robouden/note-hardware/Notecarrier-R/README.md

# Notecarrier R

  - Schematics
  - Bills of material
  - PCB layouts and Gerber files
  - Dimensioned drawings
  - 3D models
