robouden/note-hardware/Notecarrier-A/v2.0/KiCad_format/documentation/B-Cu_phantom_curve_overlay.png

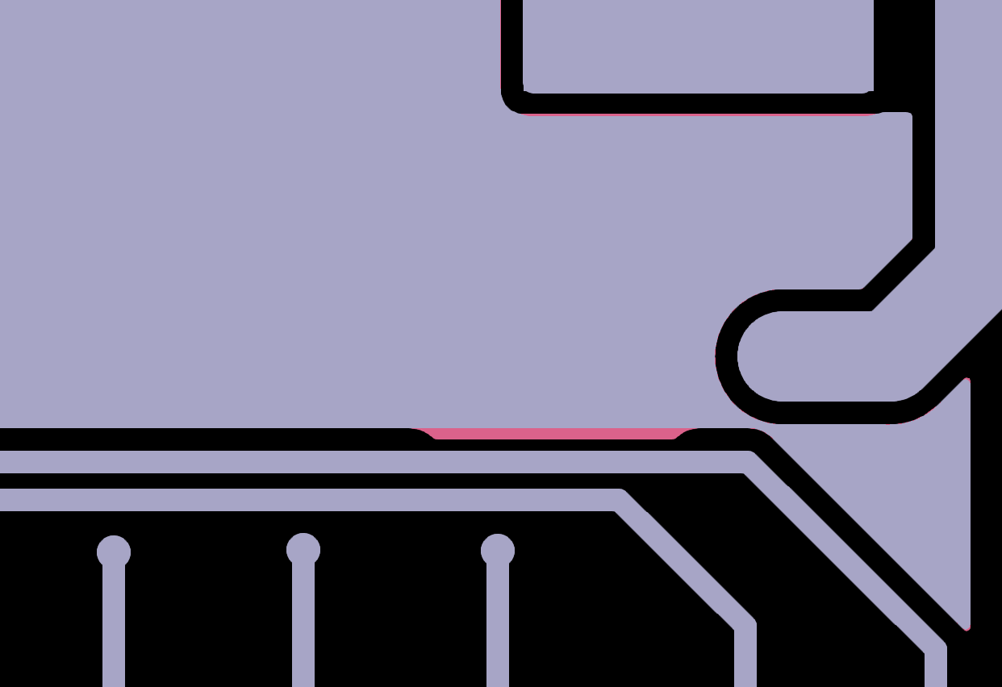
Notecarrier-A/v2.0/KiCad_format/documentation/B-Cu_phantom_curve_overlay.png
