robouden/note-hardware/Notecarrier-A/v2.0/KiCad_format/documentation/multiple_zone_clearance_settings.png

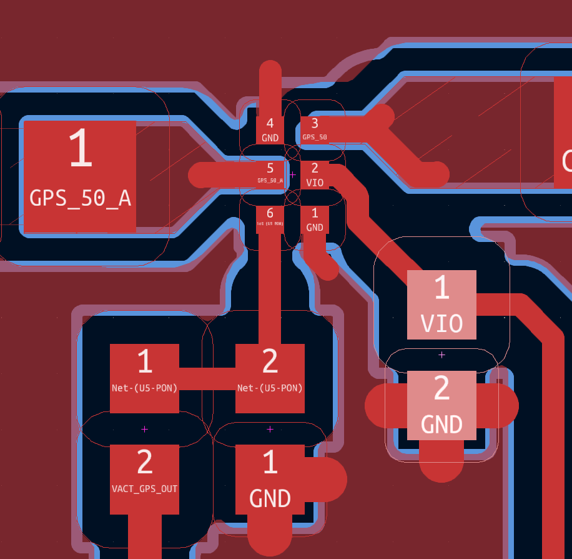
Notecarrier-A/v2.0/KiCad_format/documentation/multiple_zone_clearance_settings.png
