robouden/note-hardware/Notecarrier-A/v2.0/KiCad_format/documentation/no_phantom_curve.png

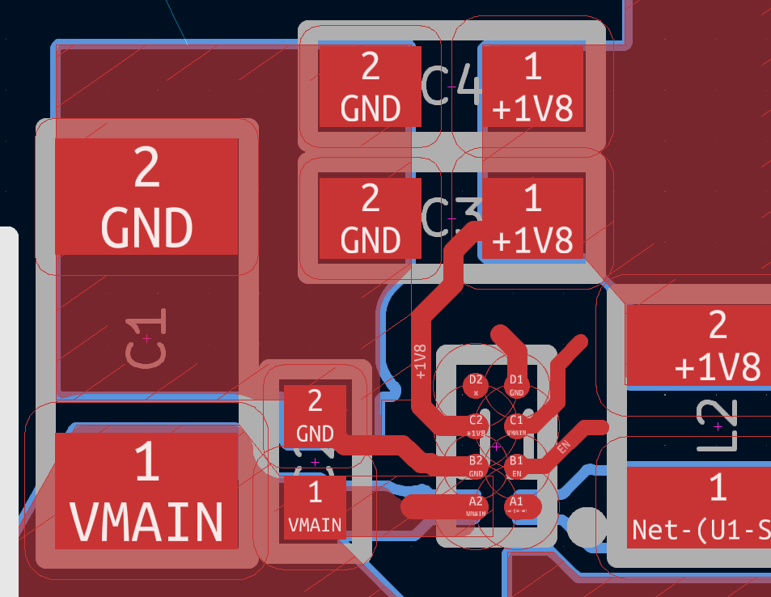
Notecarrier-A/v2.0/KiCad_format/documentation/no_phantom_curve.png
