robouden/note-hardware/Notecarrier-A/v2.0/KiCad_format/documentation/phantom_curve.png

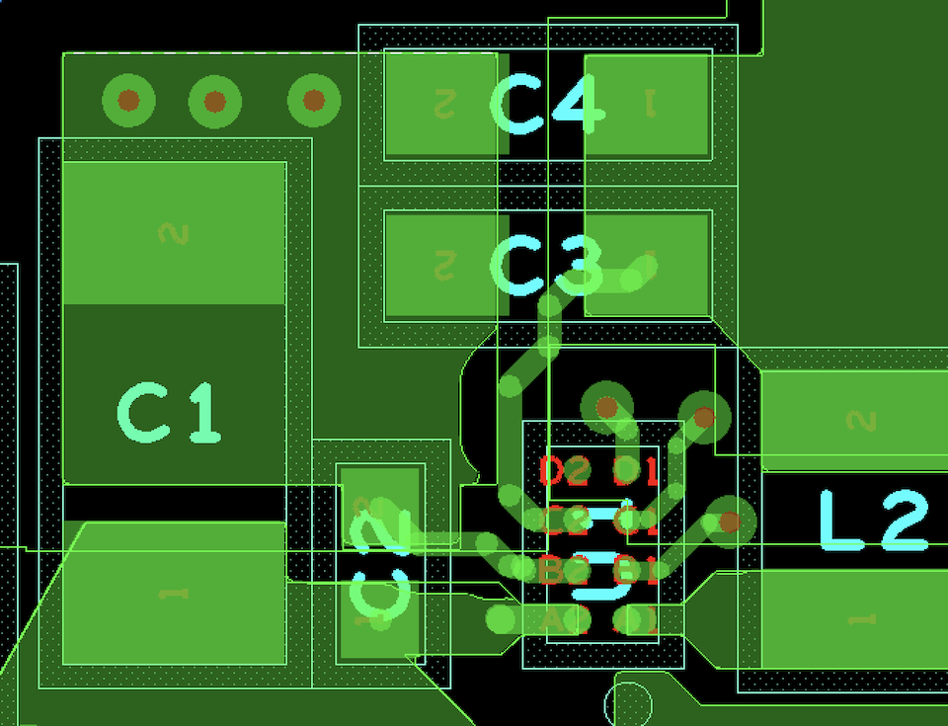
Notecarrier-A/v2.0/KiCad_format/documentation/phantom_curve.png
