robouden/note-hardware/Notecarrier-Mirco/Notecarrier-Micro/Reference/Coilcraft-XFL4020.STEP

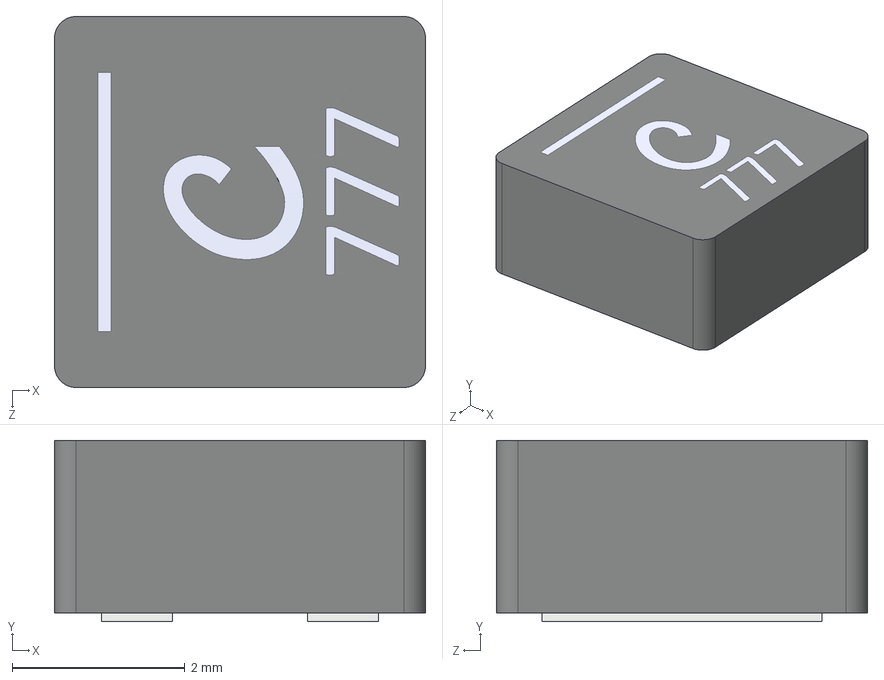
[picture p8: CAD file, 2024-05-01]
Notecarrier-Mirco/Notecarrier-Micro/Reference/Coilcraft-XFL4020.STEP
4.30 x 2.10 x 4.30 mm
