robouden/note-hardware/(list of files, cad)

Other CAD files:
Notecarrier-Mirco/Notecarrier-Micro/Notecarrier- Mirco.FCStd
Notecarrier-B/v3.1/PCB + 3D + 2D/2D/20173047_NOTECARRIER-M2-BH_V14_DIMENSION.dxf
Notecarrier-B/v1.6/Notecarrier-B drawing v1.6.dxf
Notecarrier-Mirco/Notecarrier-Micro/Reference/Coilcraft-XFL4020.stl
