robouden/note-hardware/Notecarrier-A/v2.0/KiCad_format/validation/In1_Cu-diff.png

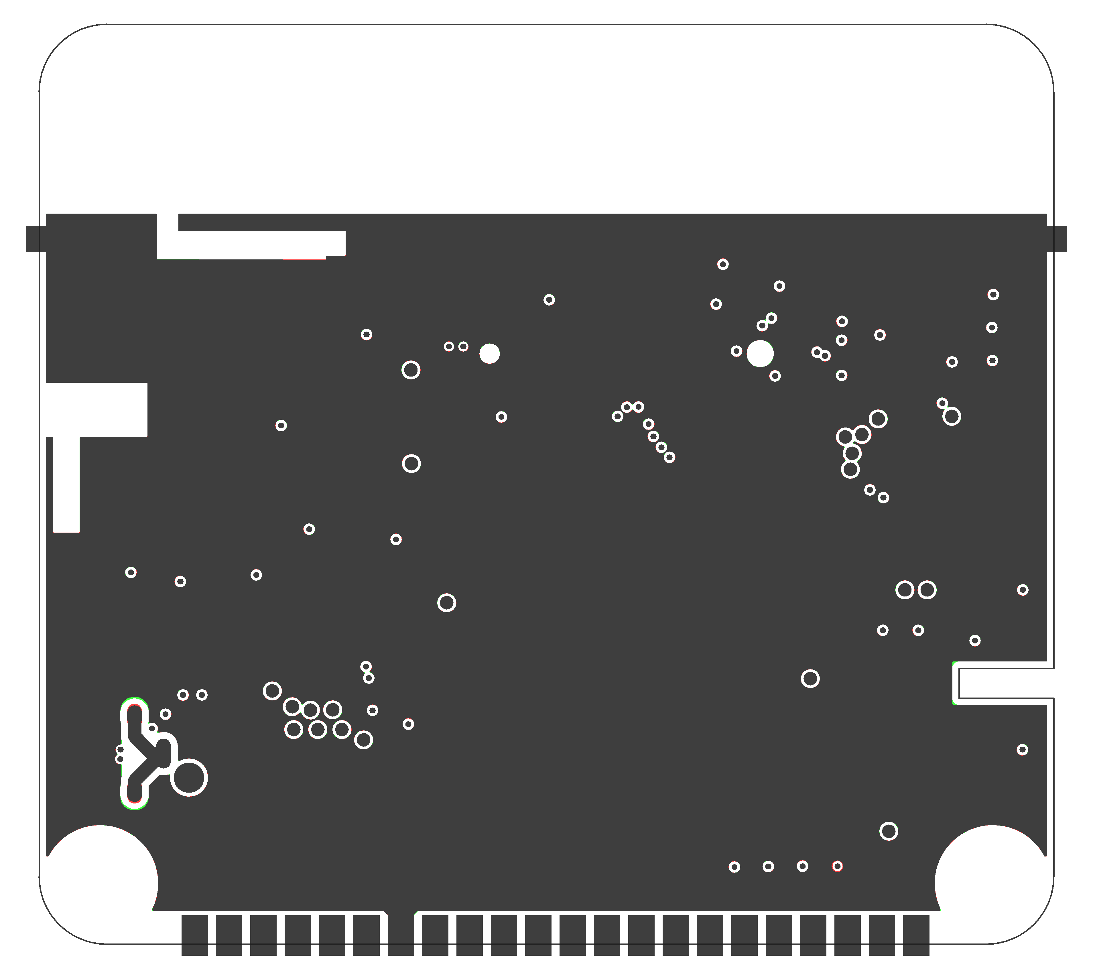
Notecarrier-A/v2.0/KiCad_format/validation/In1_Cu-diff.png
