robouden/note-hardware/Notecarrier-Mirco/Notecarrier-Micro/validation/B_Cu-diff.png

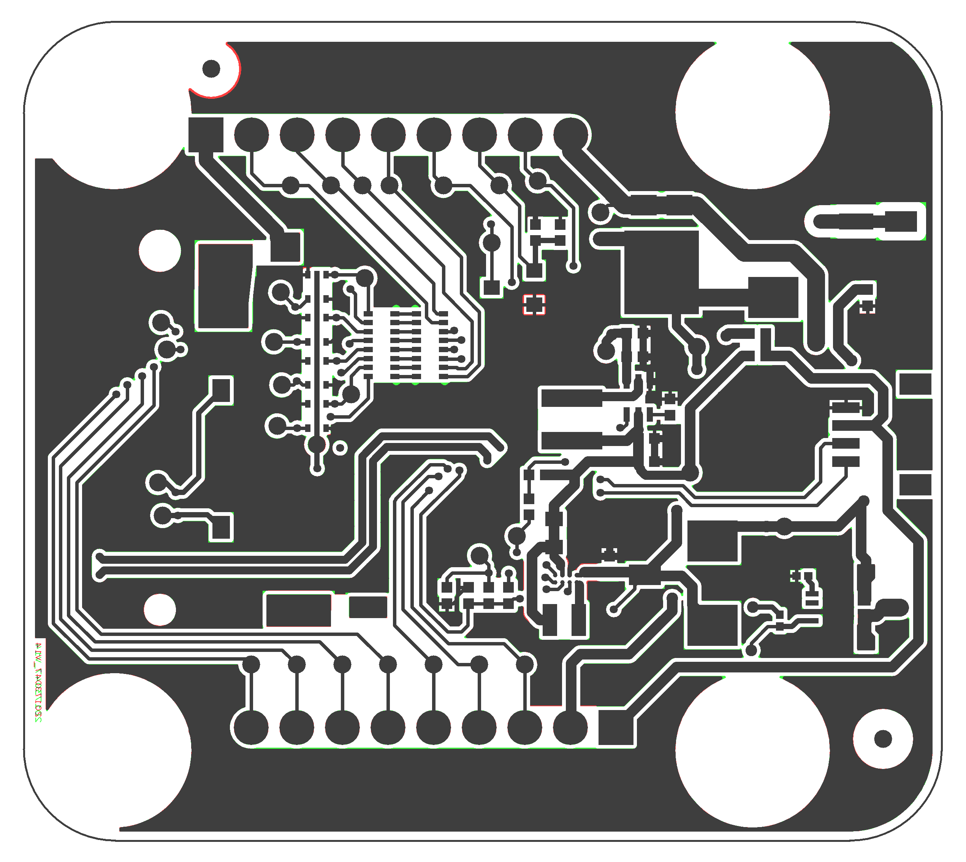
Notecarrier-Mirco/Notecarrier-Micro/validation/B_Cu-diff.png
