robouden/note-hardware/Notecarrier-Mirco/Notecarrier-Micro/validation/B_Mask-diff.png

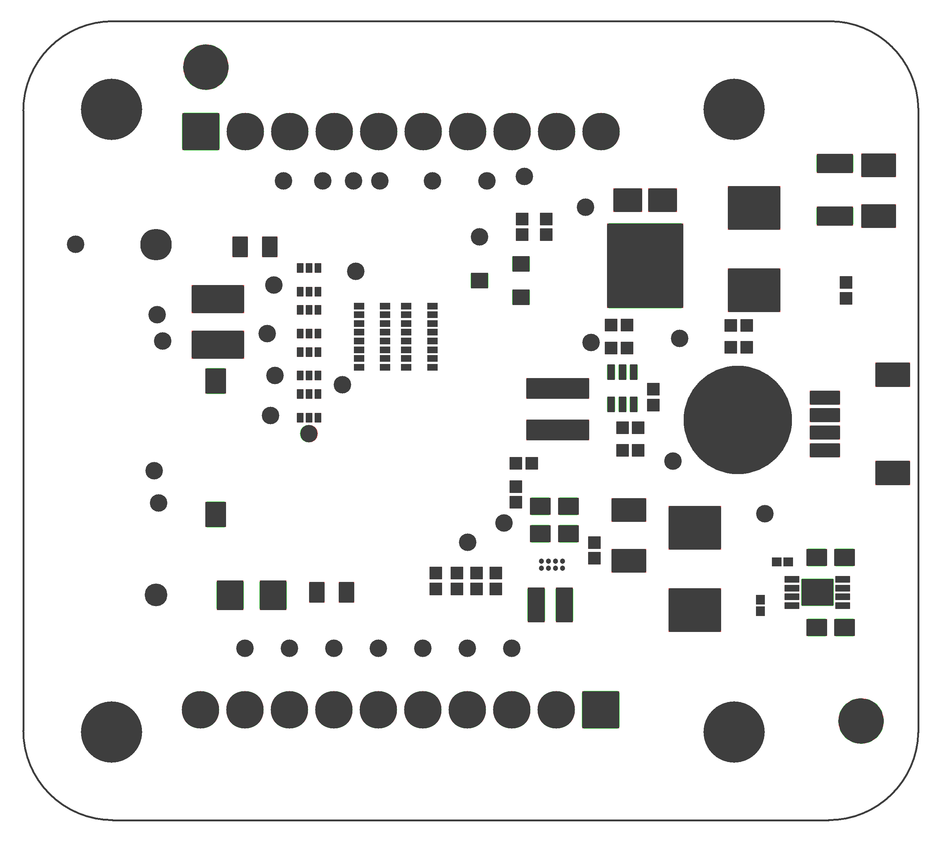
Notecarrier-Mirco/Notecarrier-Micro/validation/B_Mask-diff.png
