robouden/note-hardware/Notecarrier-Mirco/Notecarrier-Micro/validation/B_Paste-diff.png

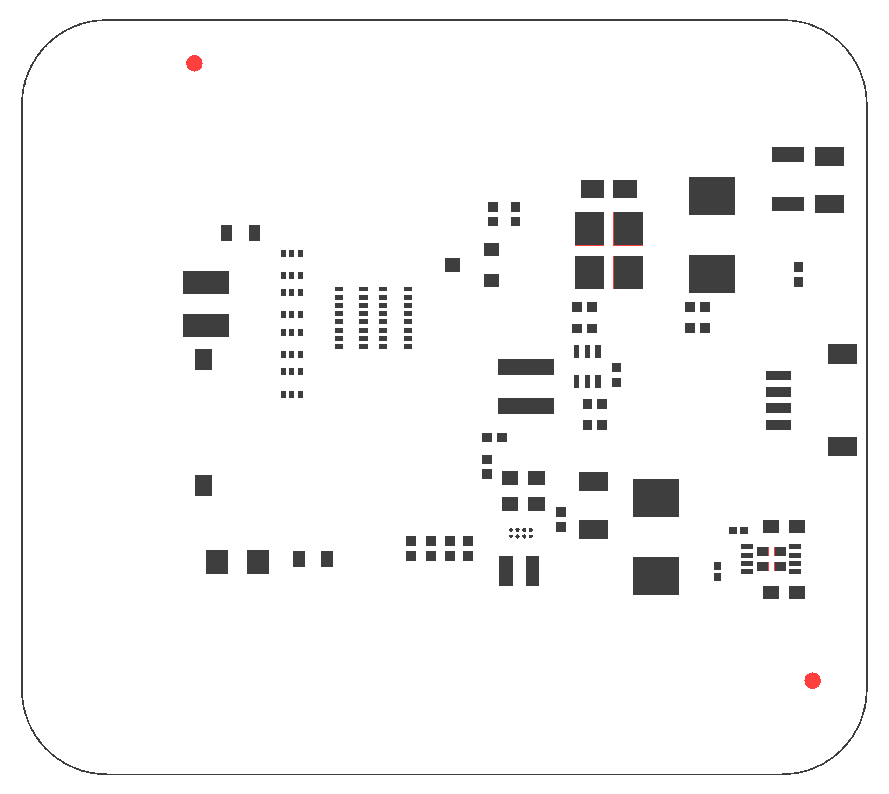
Notecarrier-Mirco/Notecarrier-Micro/validation/B_Paste-diff.png
