robouden/note-hardware/Notecarrier-Mirco/Notecarrier-Micro/validation/B_Silkscreen-diff.png

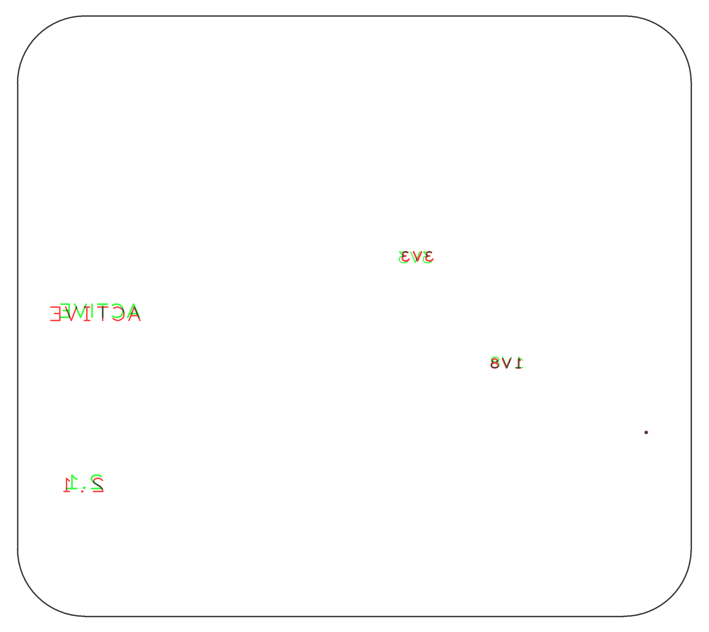
Notecarrier-Mirco/Notecarrier-Micro/validation/B_Silkscreen-diff.png
