robouden/note-hardware/Notecarrier-Mirco/Notecarrier-Micro/validation/Edge_Cuts-diff.png

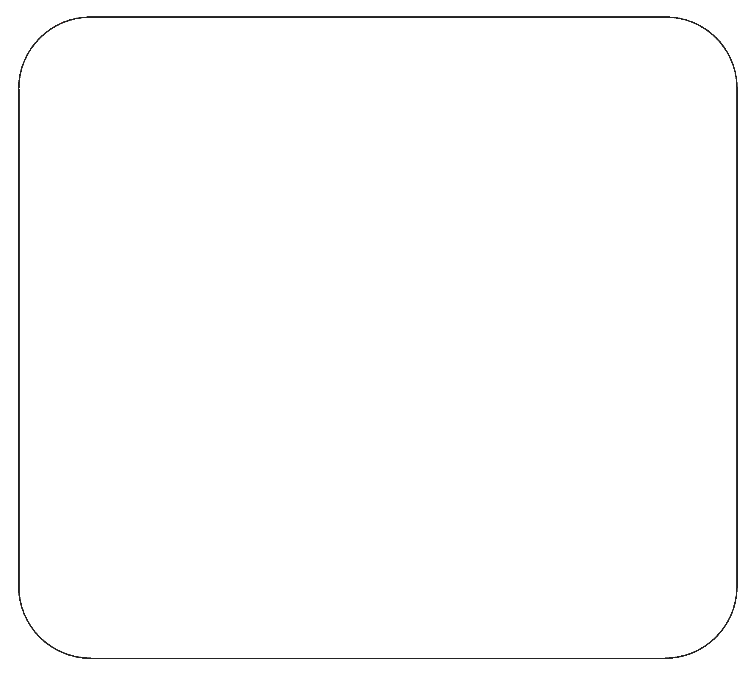
Notecarrier-Mirco/Notecarrier-Micro/validation/Edge_Cuts-diff.png
