robouden/note-hardware/Notecarrier-Mirco/Notecarrier-Micro/validation/F_Cu-diff.png

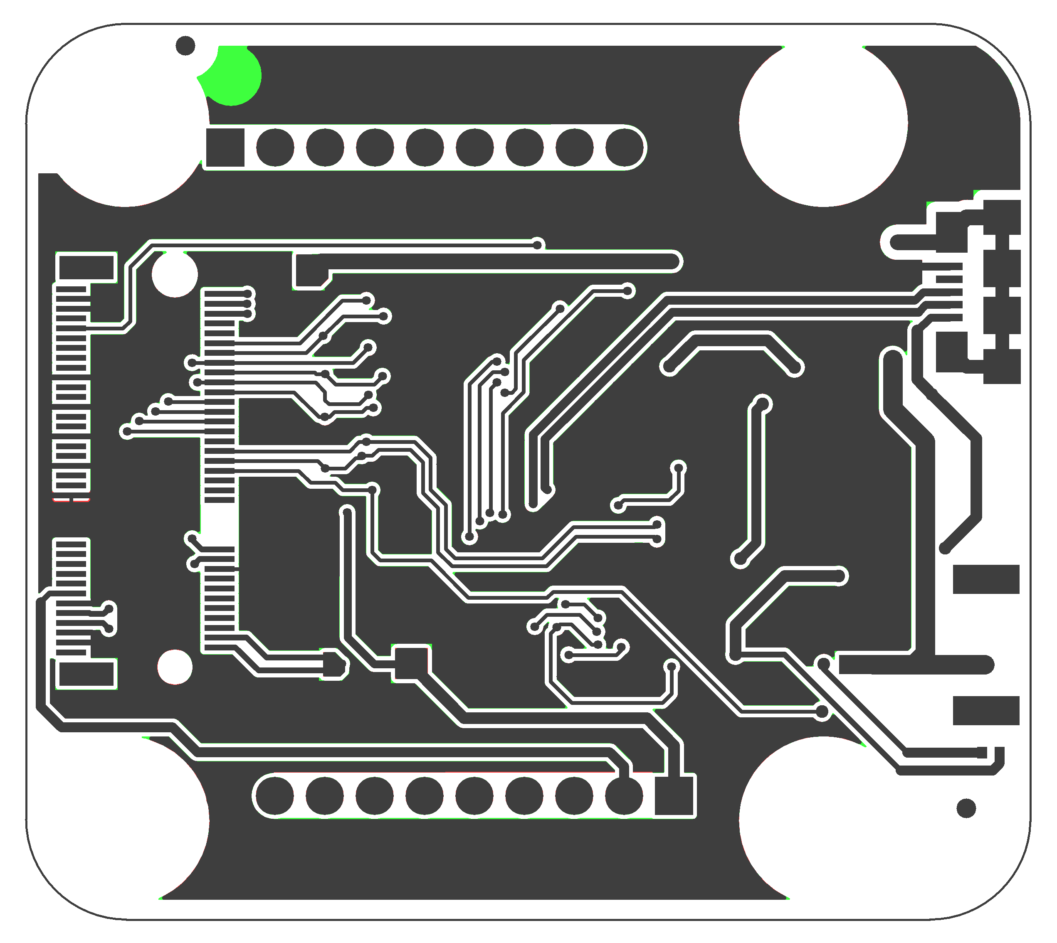
Notecarrier-Mirco/Notecarrier-Micro/validation/F_Cu-diff.png
