robouden/note-hardware/Notecarrier-Mirco/Notecarrier-Micro/validation/F_Mask-diff.png

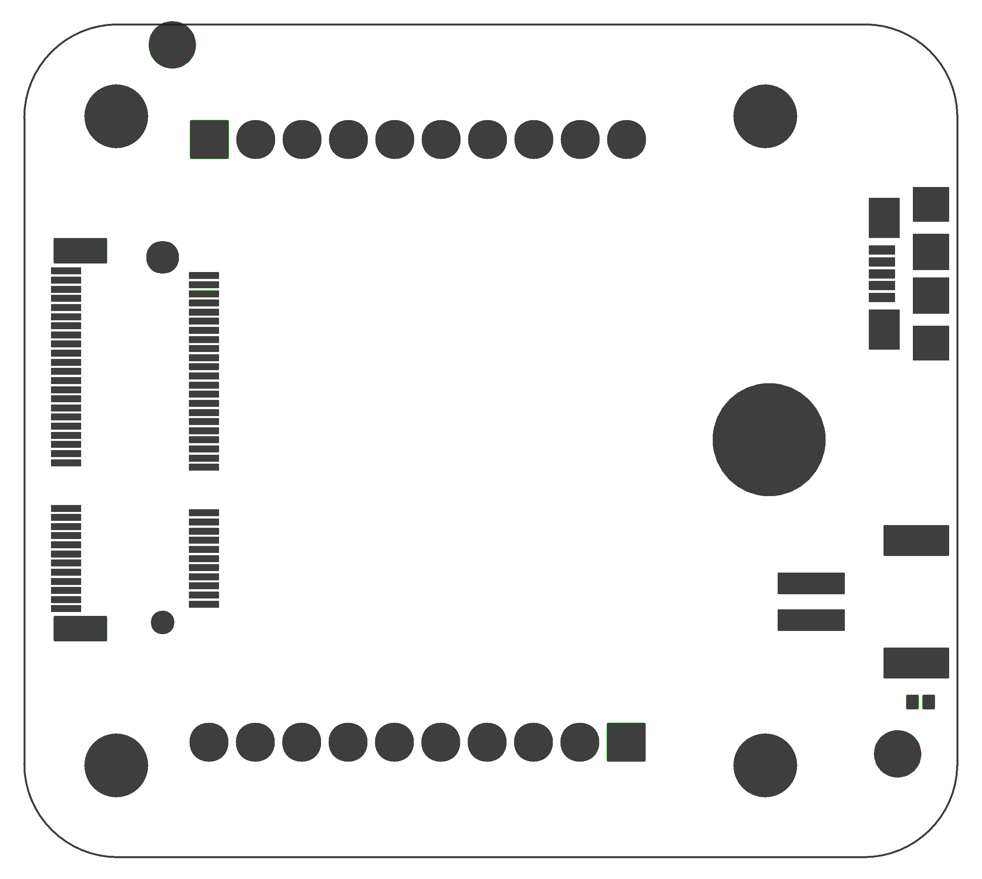
Notecarrier-Mirco/Notecarrier-Micro/validation/F_Mask-diff.png
