robouden/note-hardware/Notecarrier-Mirco/Notecarrier-Micro/validation/F_Paste-diff.png

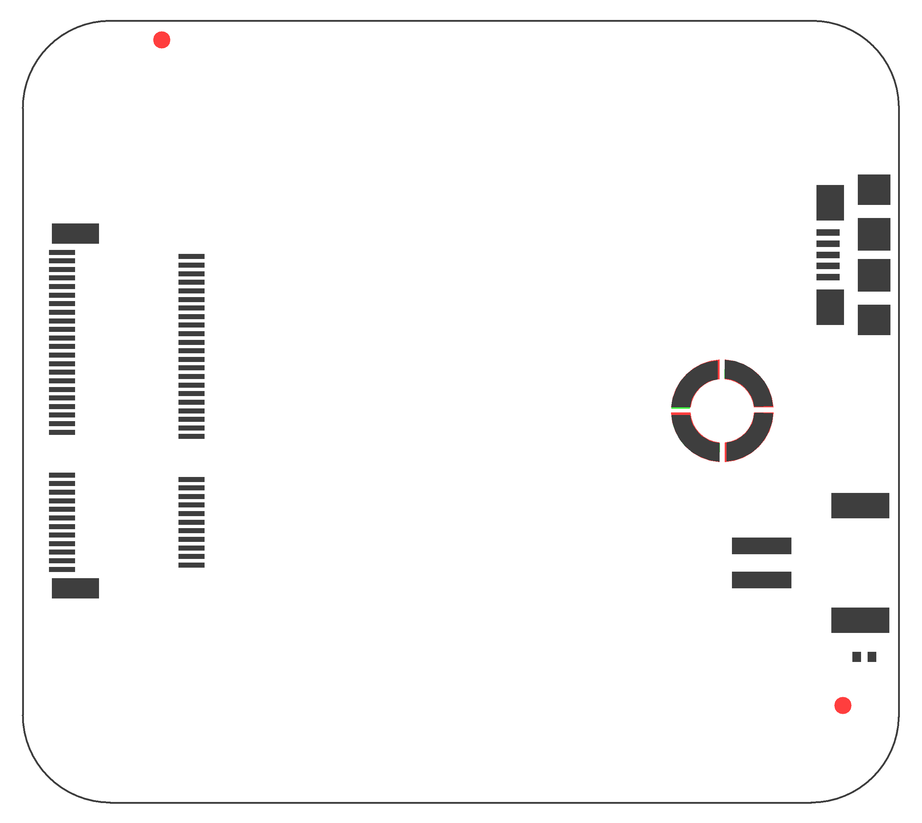
Notecarrier-Mirco/Notecarrier-Micro/validation/F_Paste-diff.png
