robouden/note-hardware/Notecarrier-Mirco/Notecarrier-Micro/validation/F_Silkscreen-diff.png

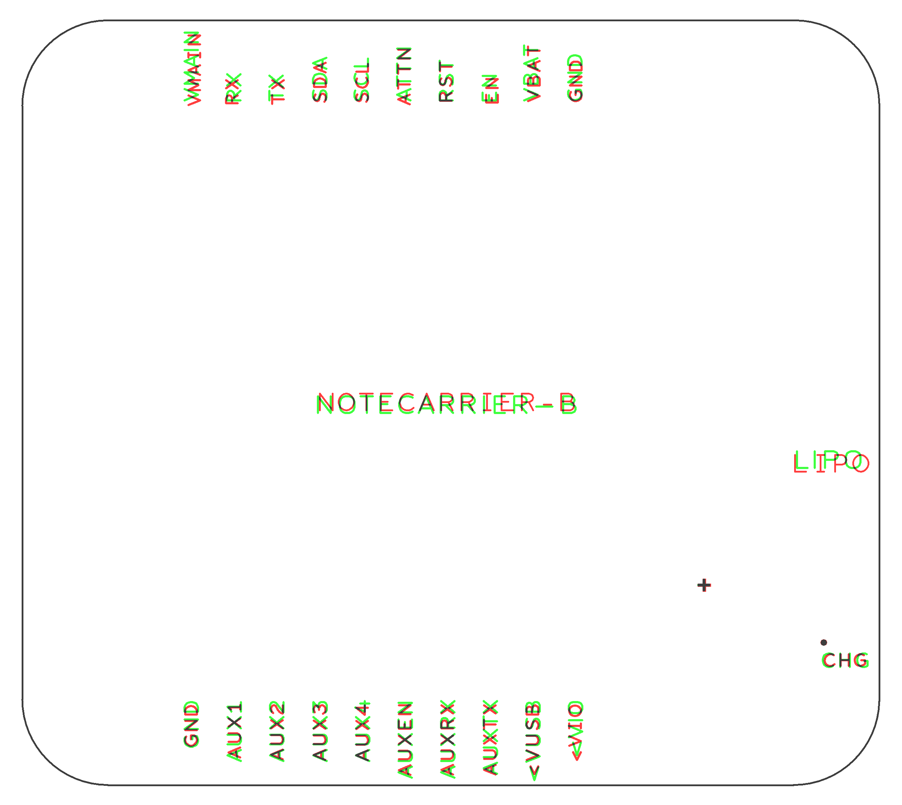
Notecarrier-Mirco/Notecarrier-Micro/validation/F_Silkscreen-diff.png
