robouden/note-hardware/Notecarrier-Mirco/Notecarrier-Micro/validation/F_Silkscreen-KiCad.png

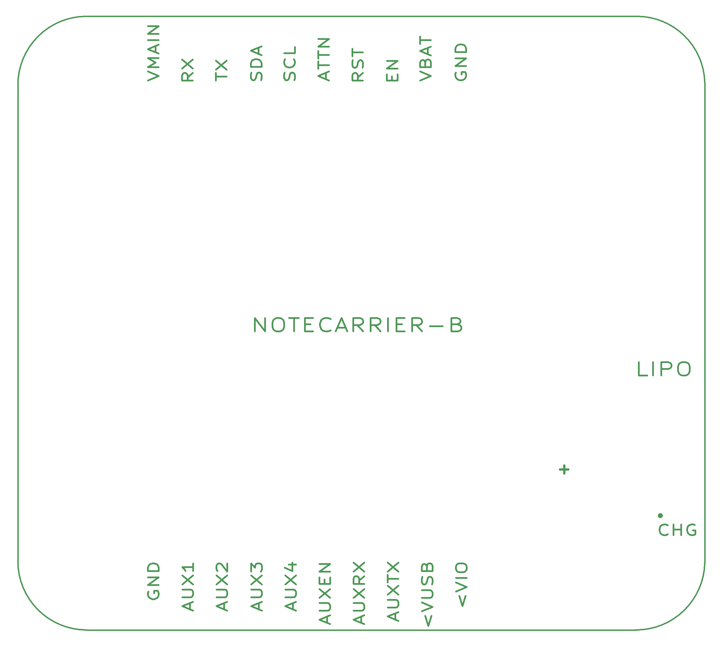
Notecarrier-Mirco/Notecarrier-Micro/validation/F_Silkscreen-KiCad.png
