robouden/note-hardware/Notecarrier-Mirco/Notecarrier-Micro/validation/NPTH-diff.png

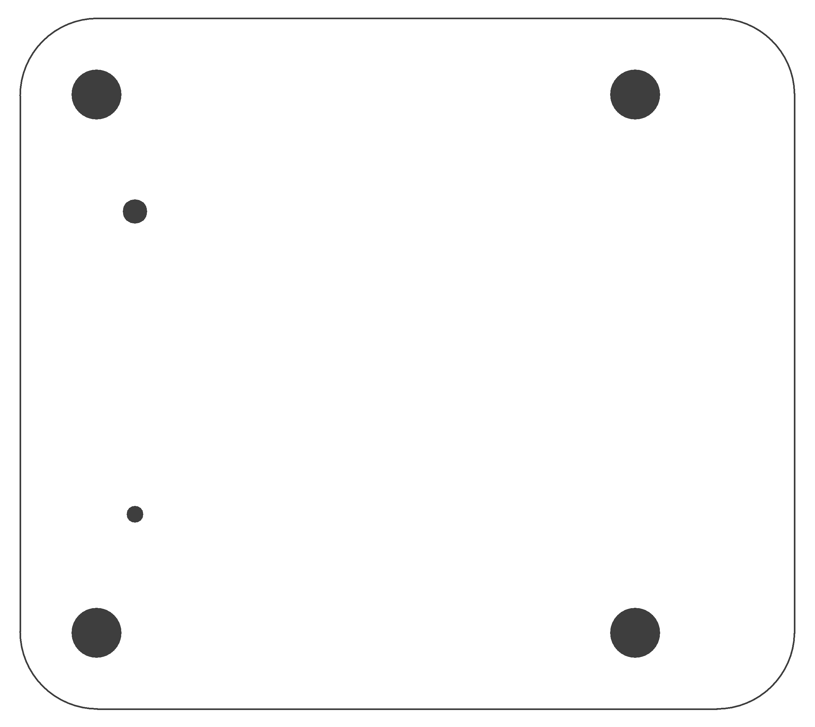
Notecarrier-Mirco/Notecarrier-Micro/validation/NPTH-diff.png
