robouden/note-hardware/Notecarrier-Mirco/Notecarrier-Micro/validation/orig/B_Paste-KiCad_top.png

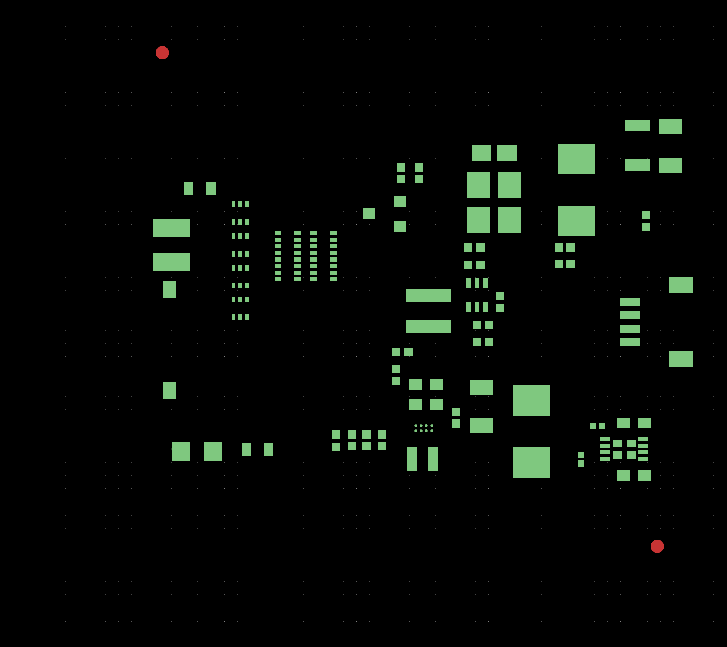
Notecarrier-Mirco/Notecarrier-Micro/validation/orig/B_Paste-KiCad_top.png
