robouden/note-hardware/Notecarrier-Mirco/Notecarrier-Micro/validation/orig/Drill_NPTH-KiCad_top.png

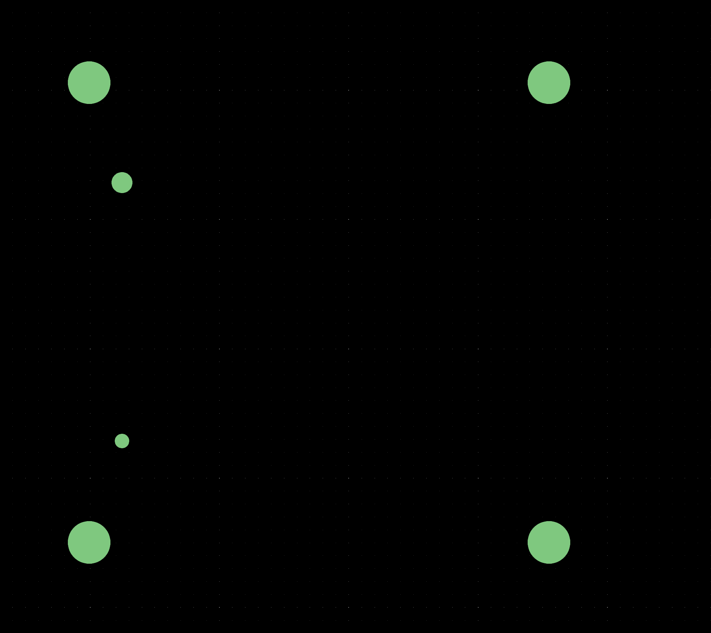
Notecarrier-Mirco/Notecarrier-Micro/validation/orig/Drill_NPTH-KiCad_top.png
