robouden/note-hardware/Notecarrier-Mirco/Notecarrier-Micro/validation/orig/Drill_PTH-OrCAD_top.png

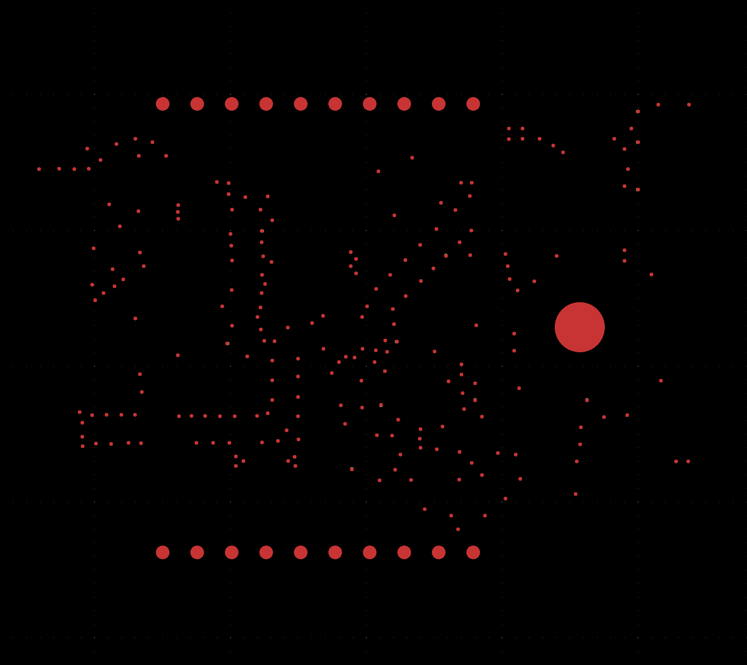
Notecarrier-Mirco/Notecarrier-Micro/validation/orig/Drill_PTH-OrCAD_top.png
