robouden/note-hardware/Notecarrier-Mirco/Notecarrier-Micro/validation/orig/Edge_Cuts-KiCad_top.png

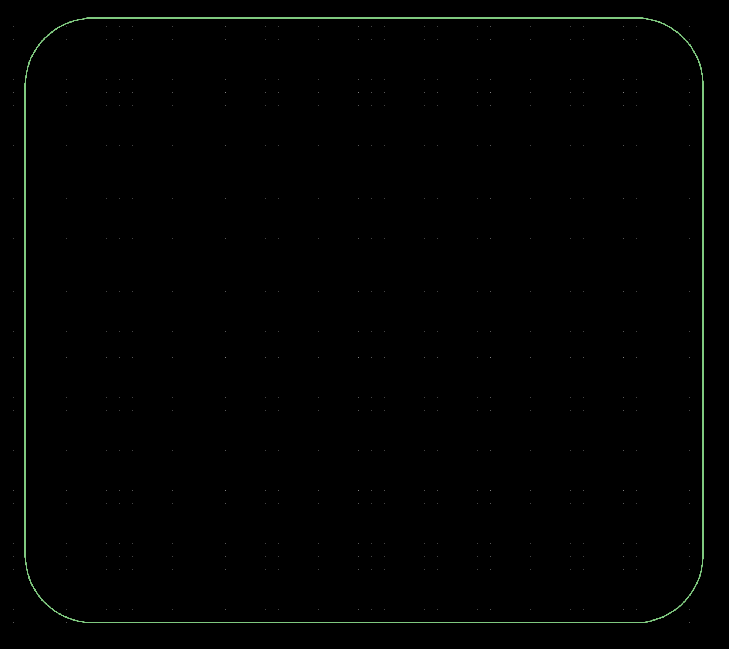
Notecarrier-Mirco/Notecarrier-Micro/validation/orig/Edge_Cuts-KiCad_top.png
