robouden/note-hardware/Notecarrier-Mirco/Notecarrier-Micro/validation/orig/F_Cu-KiCad_top.png

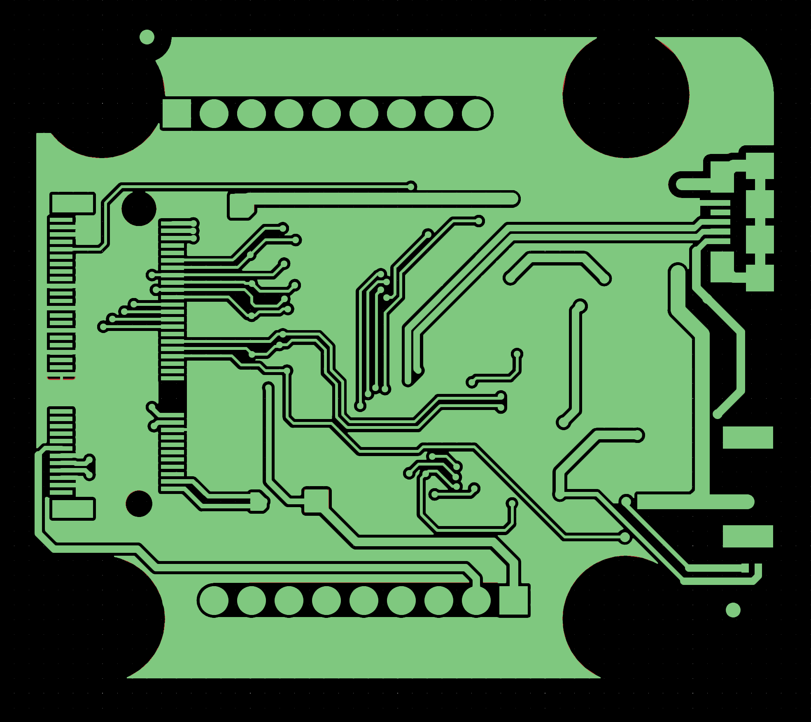
Notecarrier-Mirco/Notecarrier-Micro/validation/orig/F_Cu-KiCad_top.png
