robouden/note-hardware/Notecarrier-Mirco/Notecarrier-Micro/validation/orig/F_Mask-KiCad_top.png

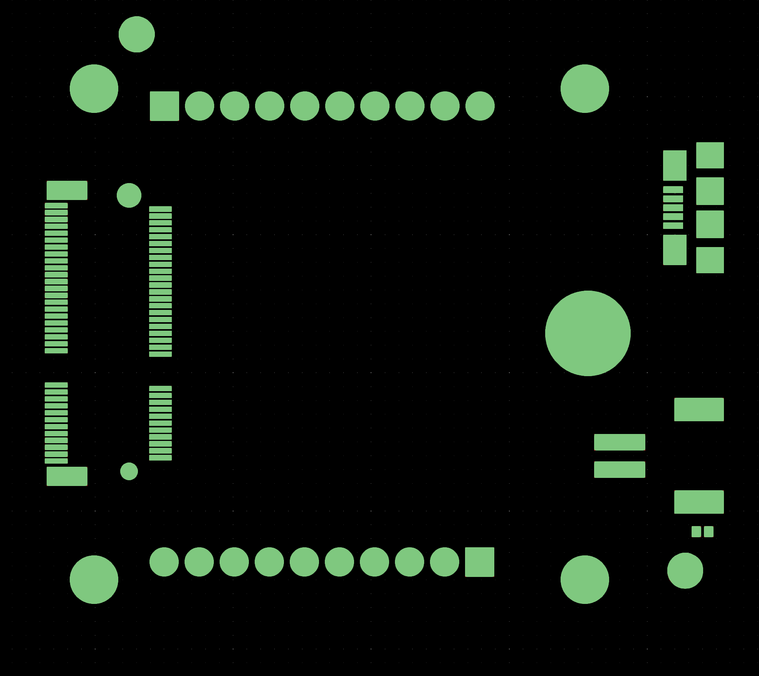
Notecarrier-Mirco/Notecarrier-Micro/validation/orig/F_Mask-KiCad_top.png
