robouden/note-hardware/Notecarrier-Mirco/Notecarrier-Micro/validation/PTH-diff.png

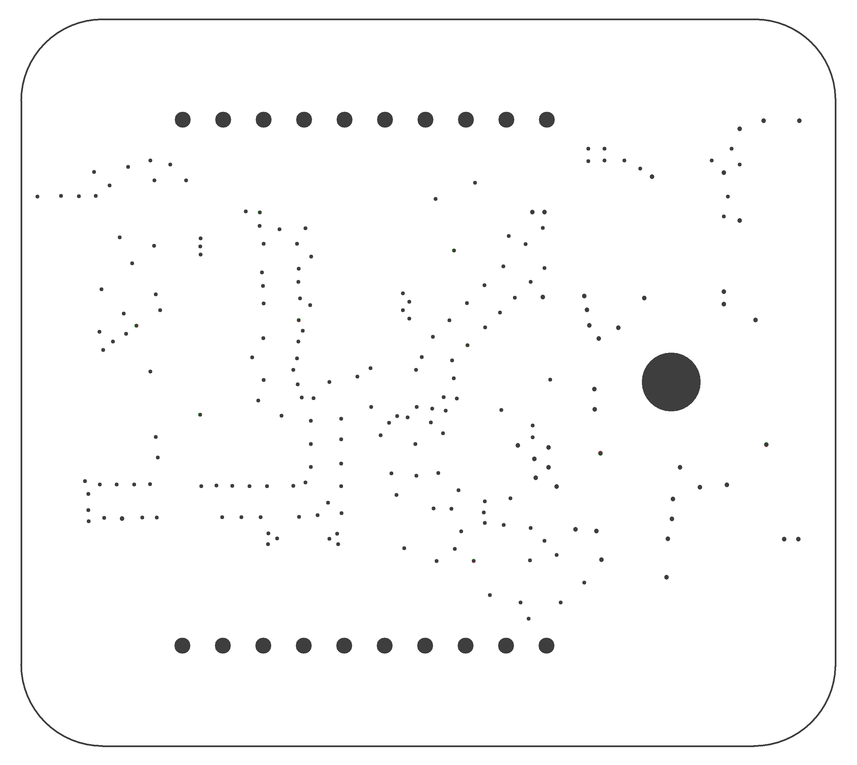
Notecarrier-Mirco/Notecarrier-Micro/validation/PTH-diff.png
