robouden/note-hardware/Notecarrier-Mirco/Notecarrier-Micro/validation/PTH-OrCAD.png

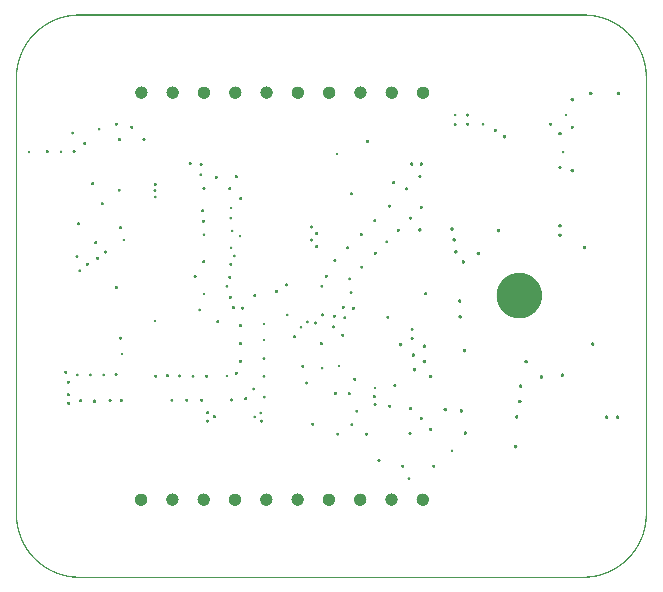
Notecarrier-Mirco/Notecarrier-Micro/validation/PTH-OrCAD.png
