robouden/note-hardware/Notecarrier-A/v2.0/Notecarrier-A schematic v2.0.pdf

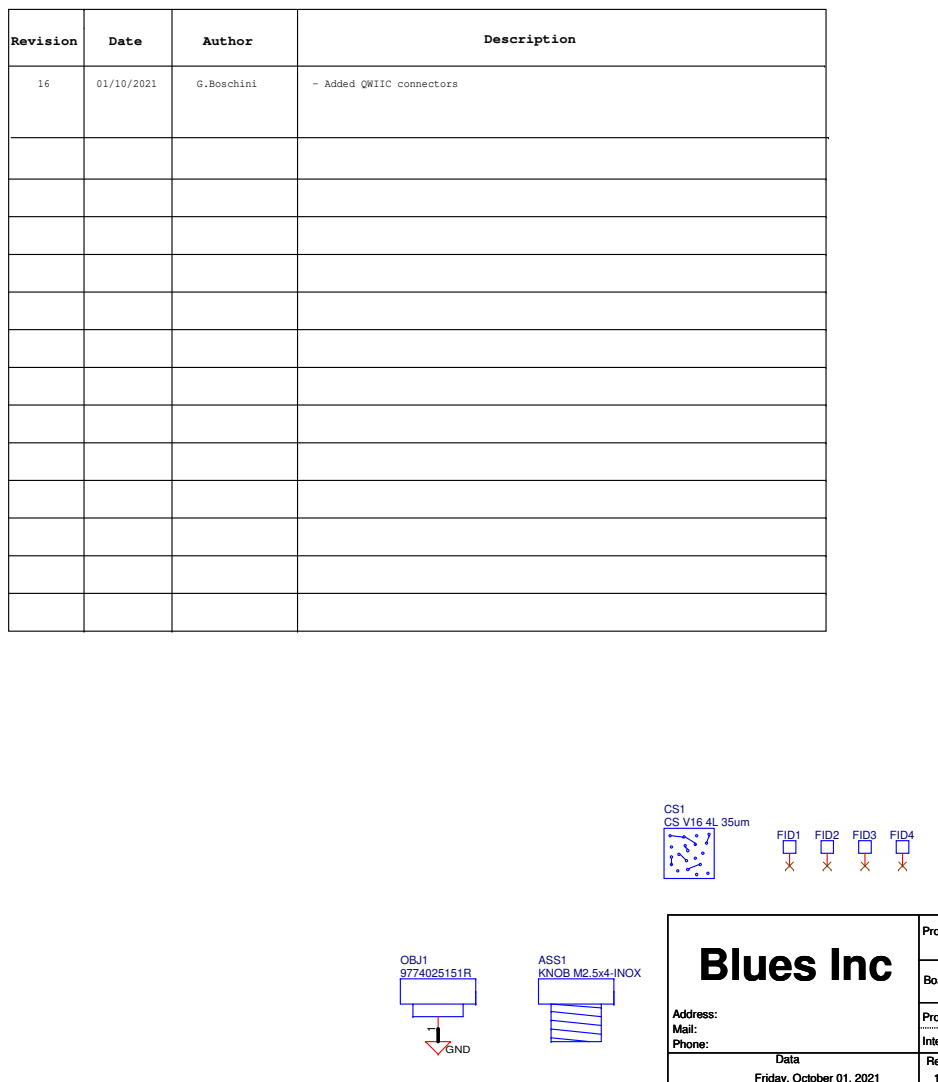
[picture p36: page 1]
Revision; Date; Author; Description; G.Boschini; - Added QWIIC connectors; GND; Project Code; Rev.; Rev. changes; Sheet; Board; Project; Code; Page name; Data; Designed by; Internal Code; Friday, October 01, 2021; 00 - REVISION; NOTECARRIER AL; NOTEBOX; See Revision Page; Address:; Mail: Phone:; Blues Inc; FID3; ASS1 KNOB M2.5x4-INOX; OBJ1 9774025151R; FID1; FID2; FID4

via C. Battisti, 136
24025 Gazzaniga (Bg), Italy
Mail: info@fae.technology
Phone: +39035738130

Copyright (c) 2020 Blues Inc

# I2C GROVE

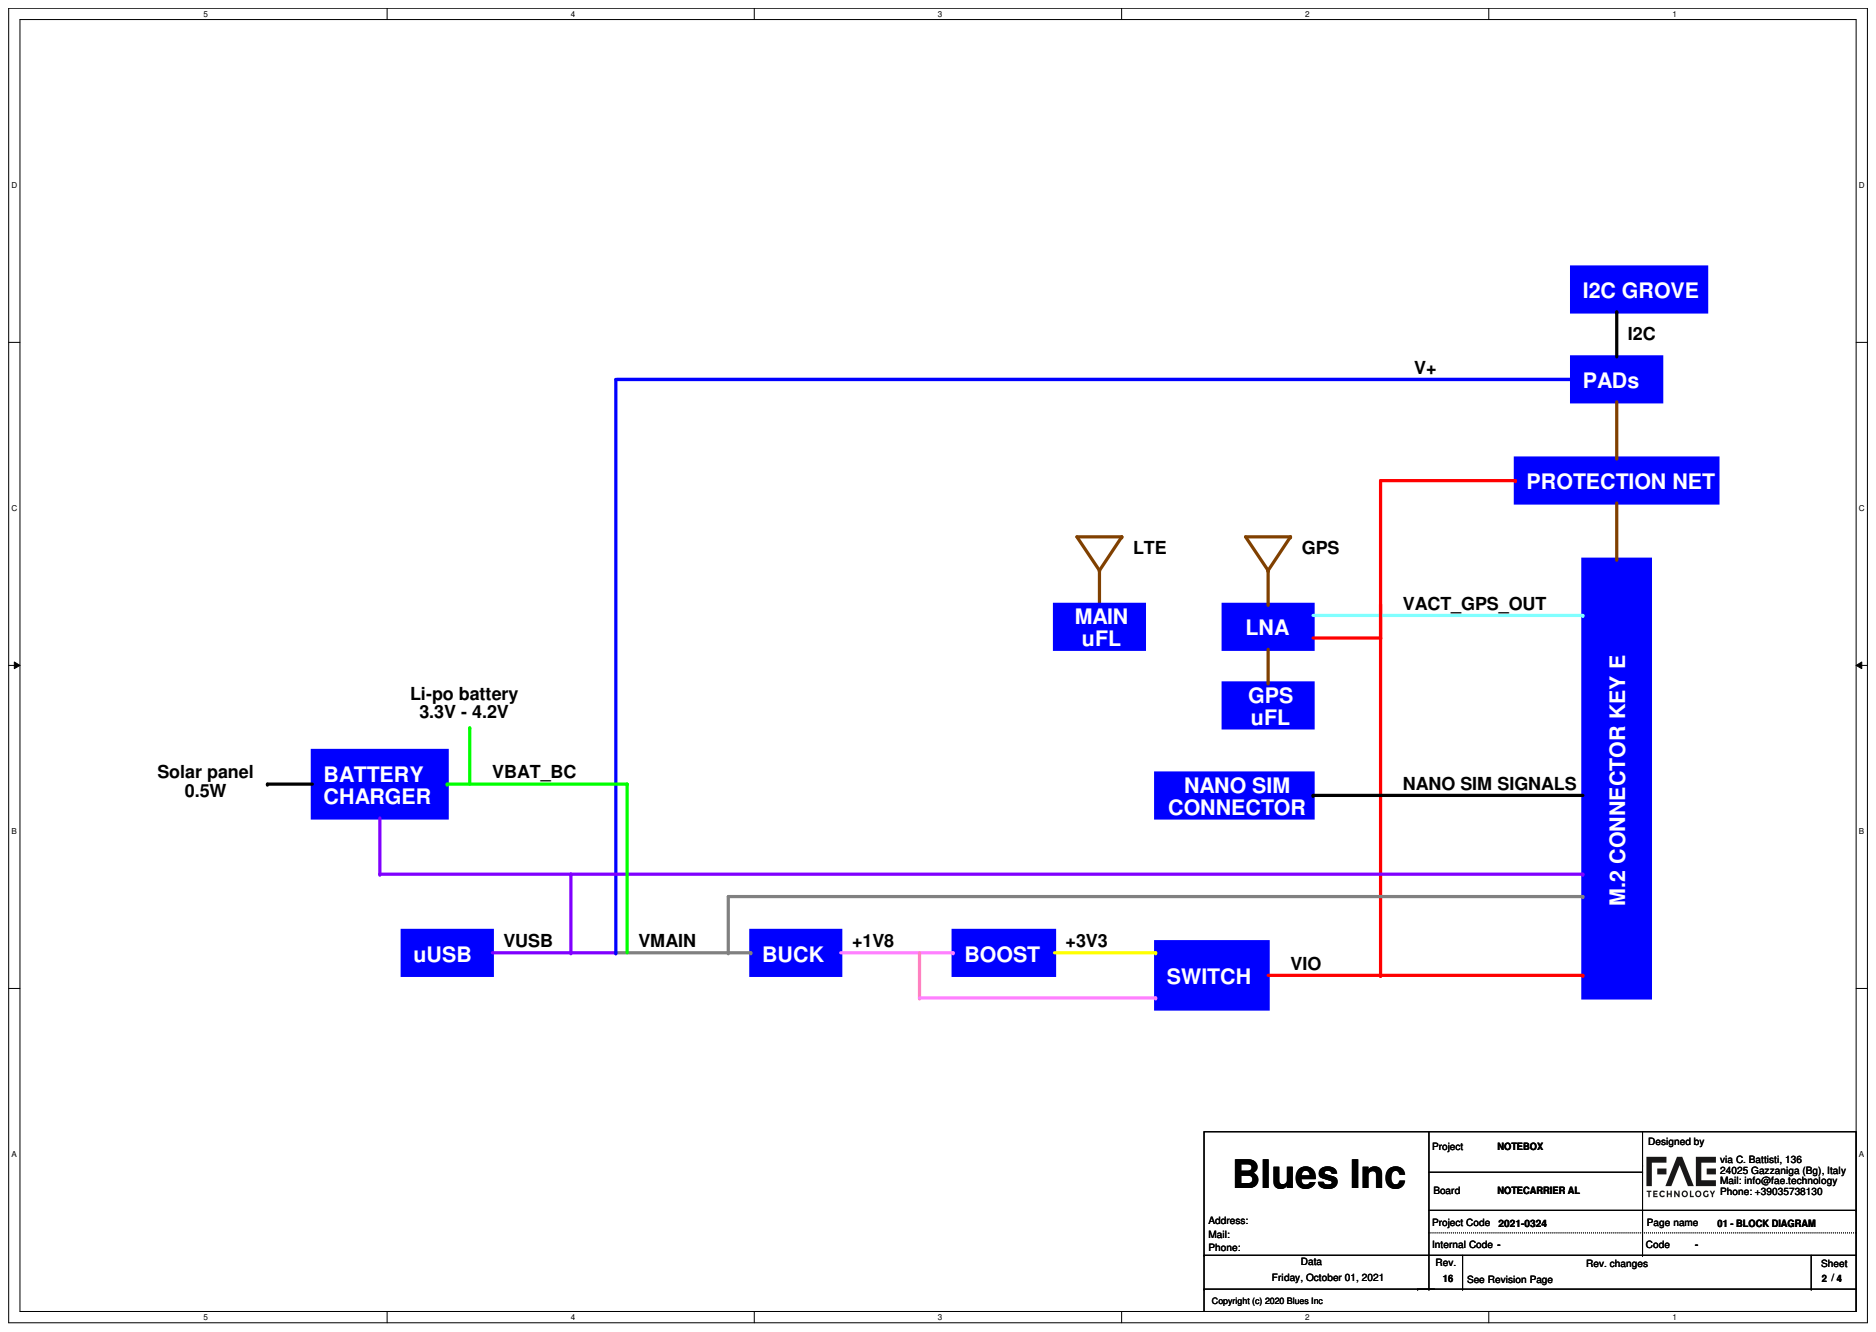
[picture p37: page 2]
BUCK VUSB; VIO SWITCH VMAIN uUSB; BOOST ⁺¹V8; VACT_GPS_OUT; LNA; LTE; GPS; M.2 CONNECTOR KEY E; PROTECTION NET; PADs; GPS uFL; MAIN uFL; NANO SIM CONNECTOR; NANO SIM SIGNALS BATTERY CHARGER Solar panel 0.5W; VBAT_BC; Project Code; Rev.; Rev. changes; Sheet; Board; Project; Code; Page name; Data; Designed by; Internal Code; 01 - BLOCK DIAGRAM; NOTECARRIER AL; NOTEBOX; See Revision Page; Address:; Mail: Phone:; Blues Inc

Li-po battery

via C. Battisti, 136
24025 Gazzaniga (Bg), Italy
Mail: info@fae.technology
Phone: +39035738130

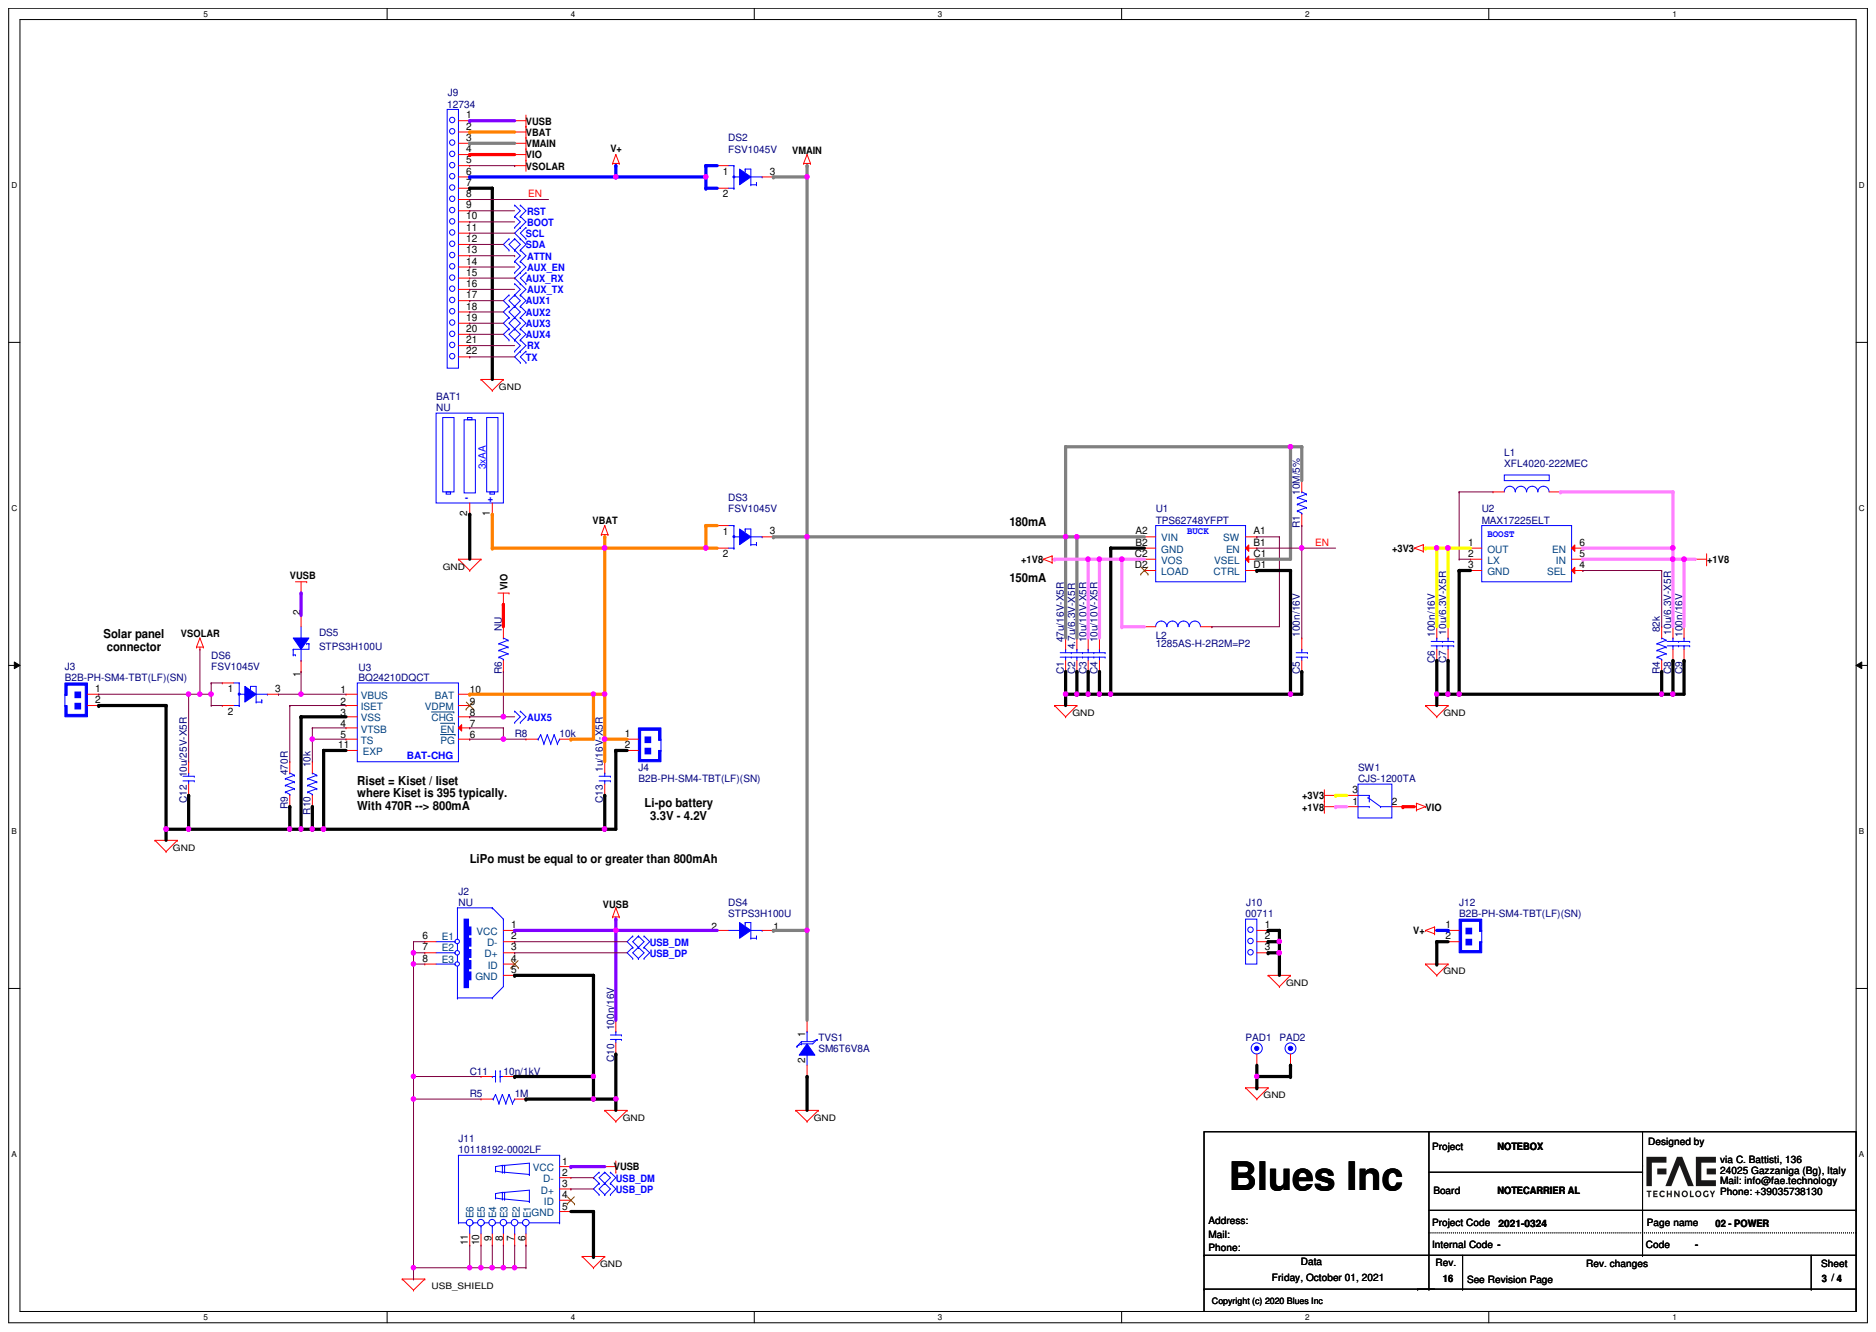
[picture p38: page 3]

B2B-PH-SM4-TBT(LF)(SN)

Riset = Kiset / Iiset
where Kiset is 395 typically.
With 470R --> 800mA

LiPo must be equal to or greater than 800mAh

via C. Battisti, 136
24025 Gazzaniga (Bg), Italy
Mail: info@fae.technology
Phone: +39035738130

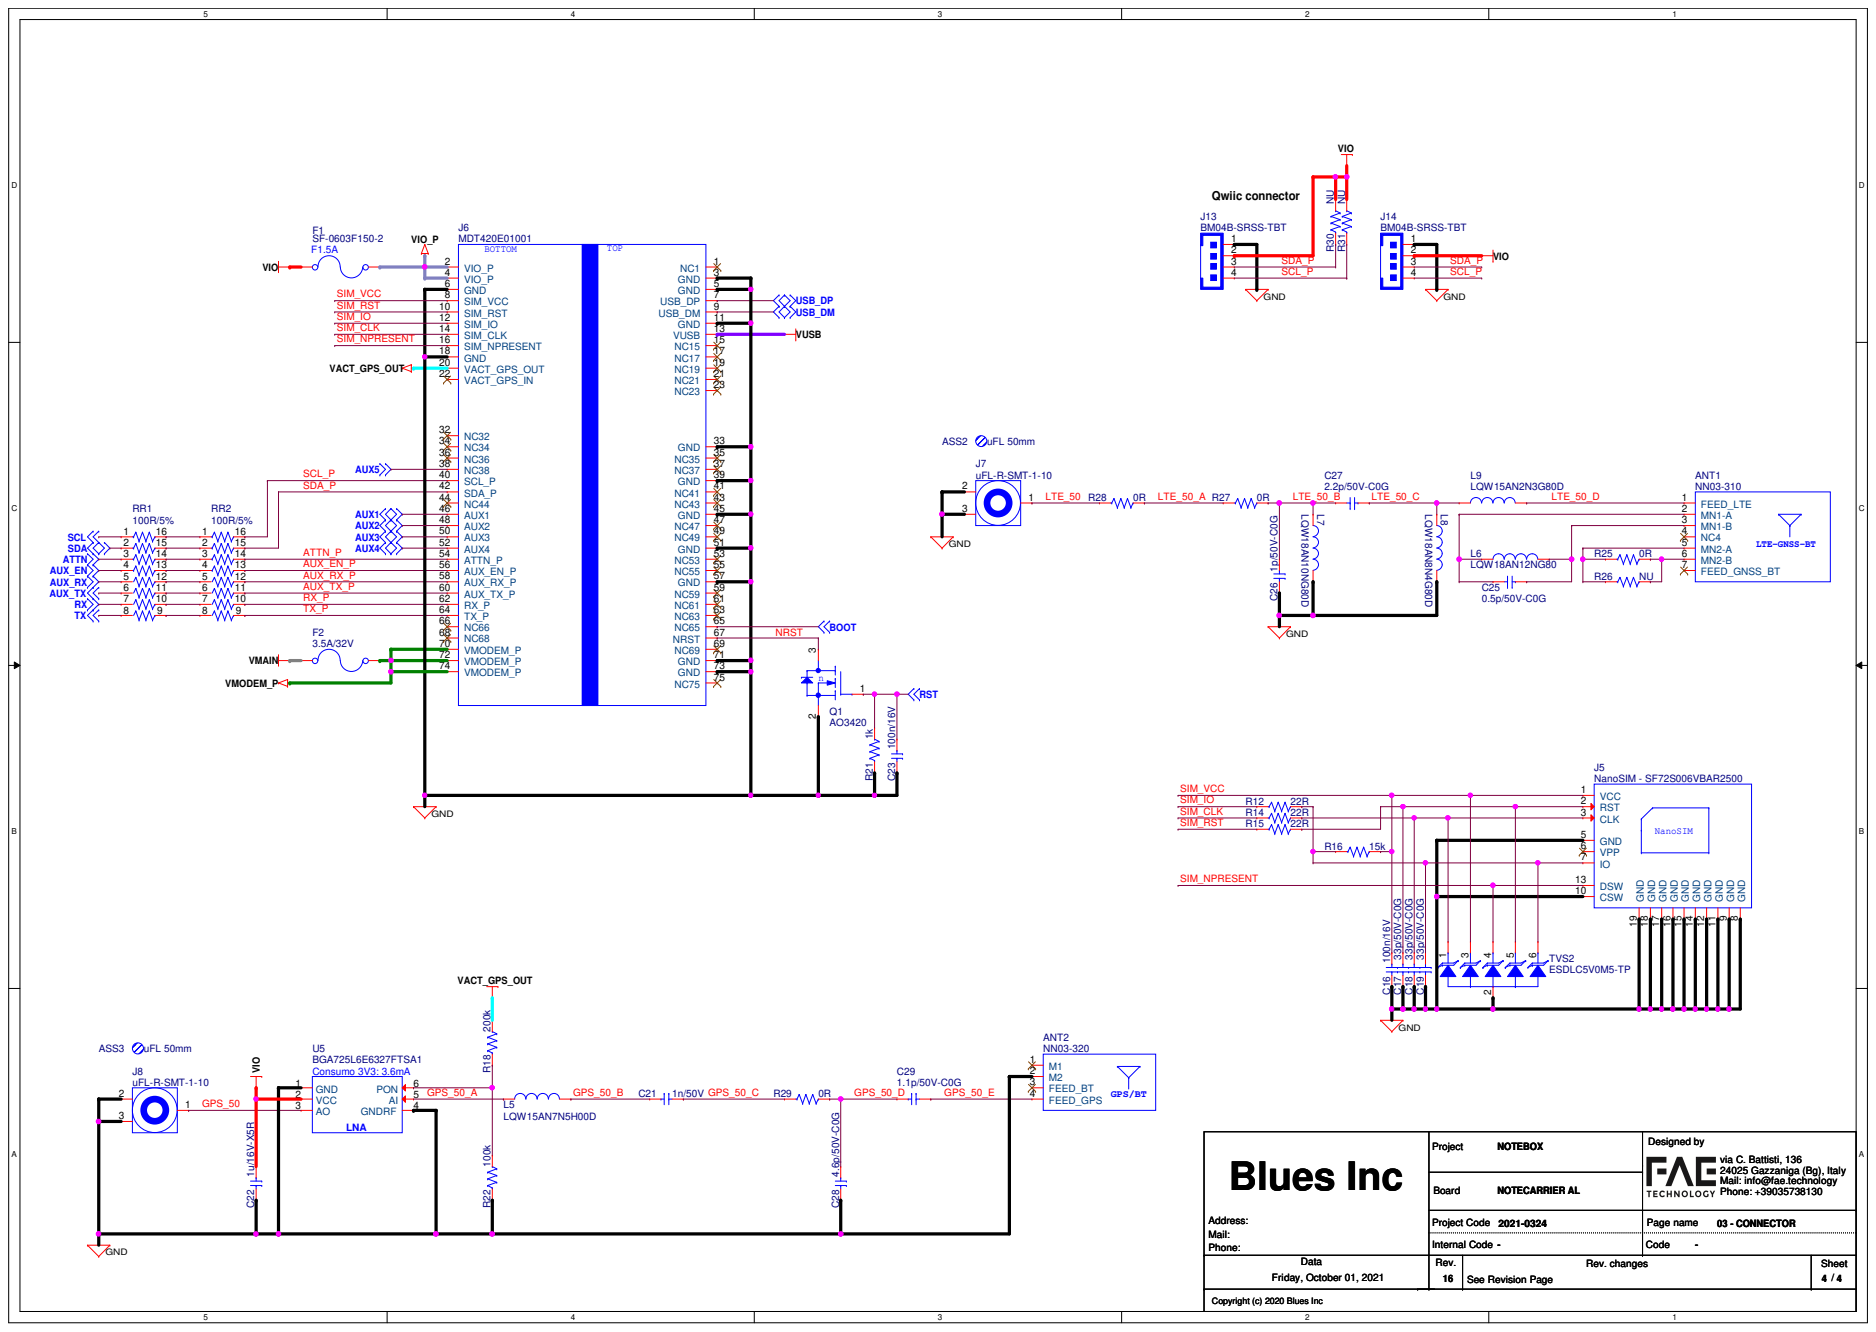
[picture p39: page 4]

via C. Battisti, 136
24025 Gazzaniga (Bg), Italy
Mail: info@fae.technology
Phone: +39035738130

Project Code Project Code Project Code | Page name Page name Page name 03 - CONNECTOR 03 - CONNECTOR 03 - CONNECTOR

Internal Code Internal Code Internal Code --- | Code Code Code ---
