robouden/note-hardware/Notecarrier-B/v3.1/SCH + BOM/SCH/20173047_NOTECARRIER-M2-BH_V14.pdf

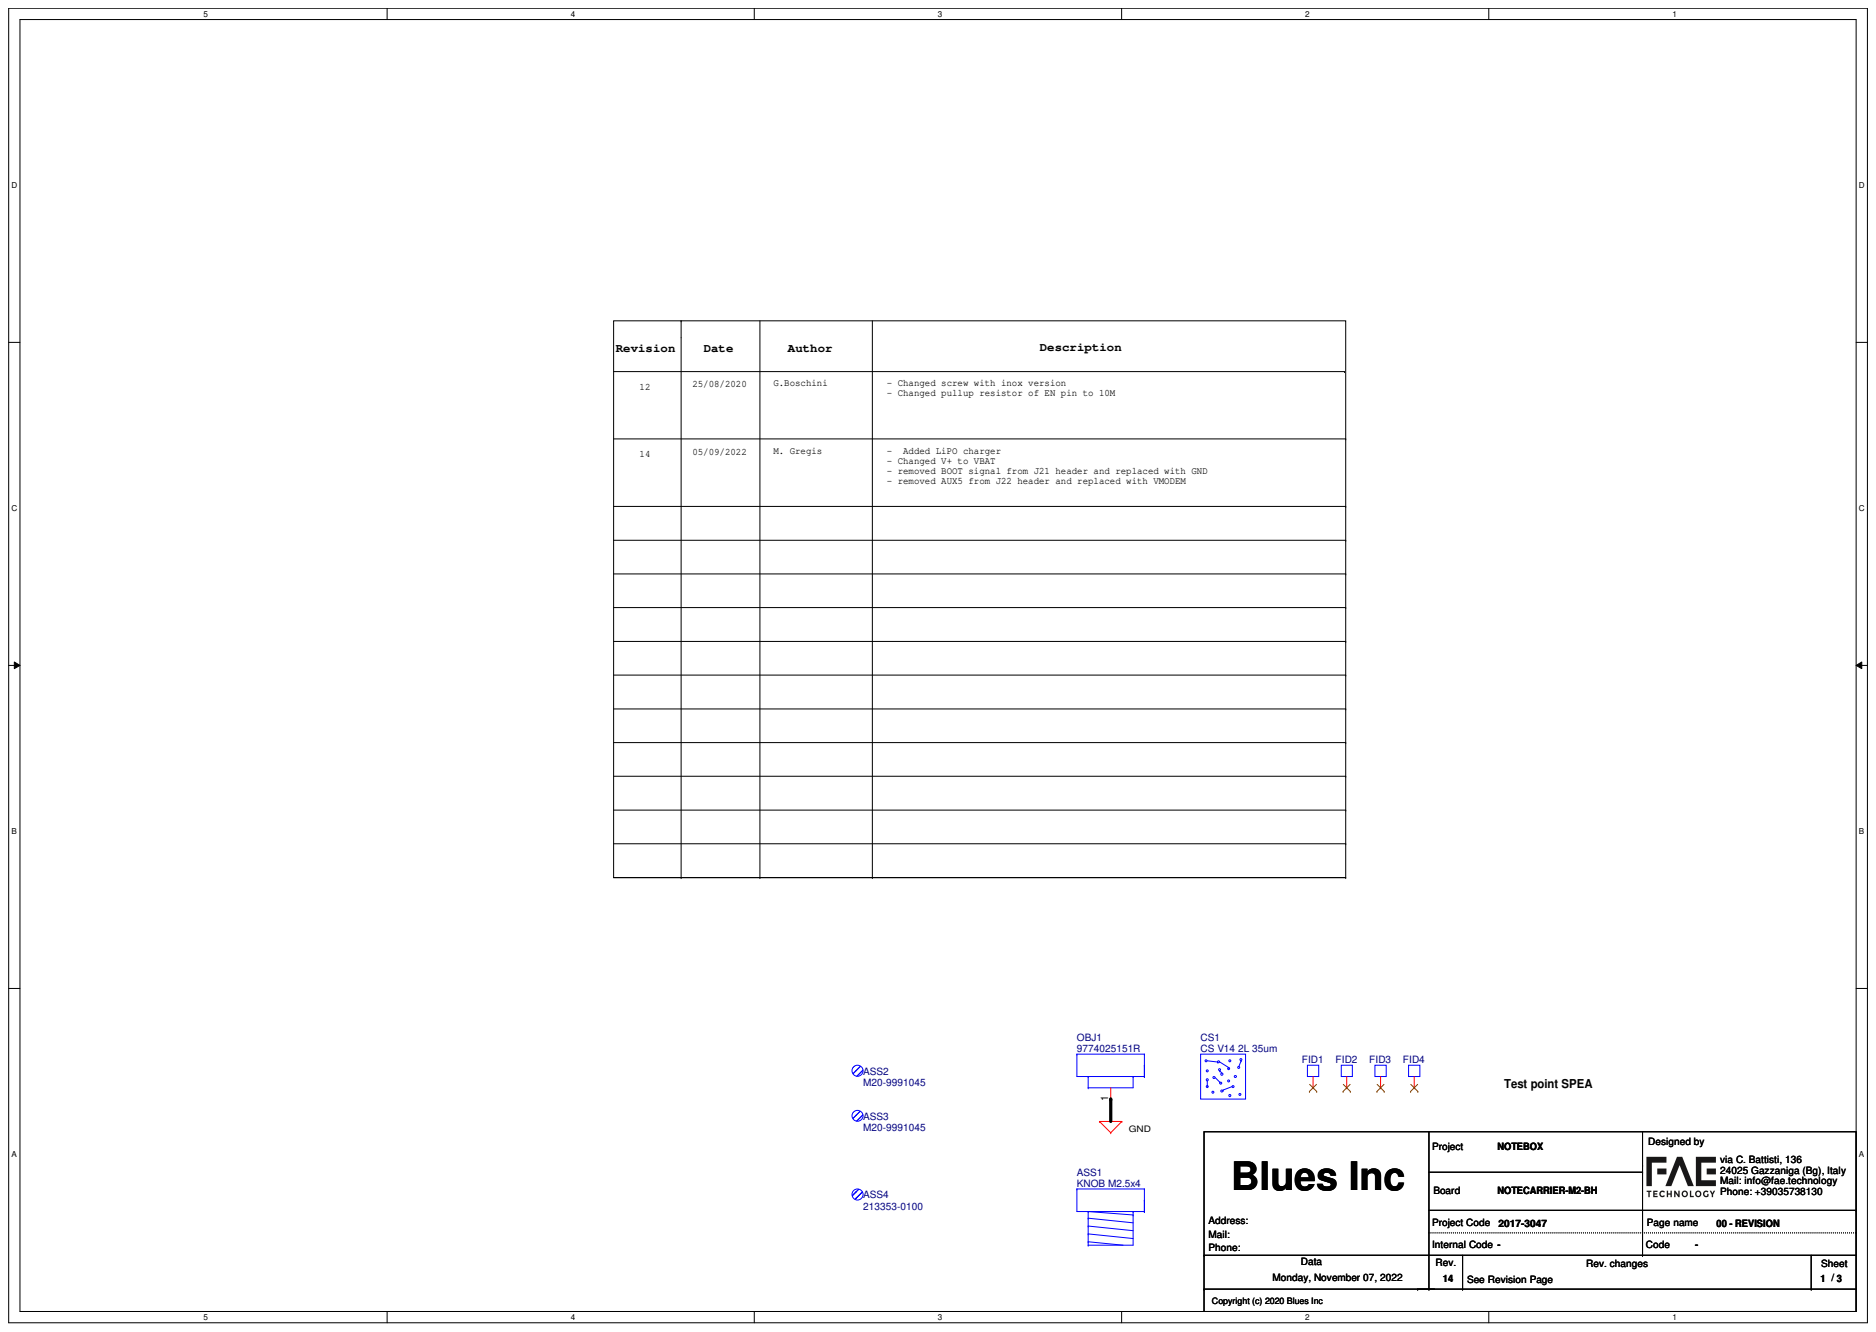
[picture p41: page 1]
Revision; Date; Author; Description; G.Boschini 12; M. Gregis; Added LiPO charger; GND; Project Code; Rev.; Rev. changes; Sheet; Board; Project; Code; Page name; Data; Designed by; Internal Code; Monday, November 07, 2022; 00 - REVISION; NOTECARRIER-M2-BH; NOTEBOX; See Revision Page; Address:; Mail: Phone:; Blues Inc; OBJ1 9774025151R; ASS2 M20-9991045; ASS3 M20-9991045; FID1; ASS4; FID2; FID3; FID4; ASS1 KNOB M2.5x4

- Changed screw with inox version
- Changed pullup resistor of EN pin to 10M

- Changed V+ to VBAT
- removed BOOT signal from J21 header and replaced with GND
- removed AUX5 from J22 header and replaced with VMODEM

Test point SPEA

via C. Battisti, 136
24025 Gazzaniga (Bg), Italy
Mail: info@fae.technology
Phone: +39035738130

Copyright (c) 2020 Blues Inc

# VBAT

# STRIP

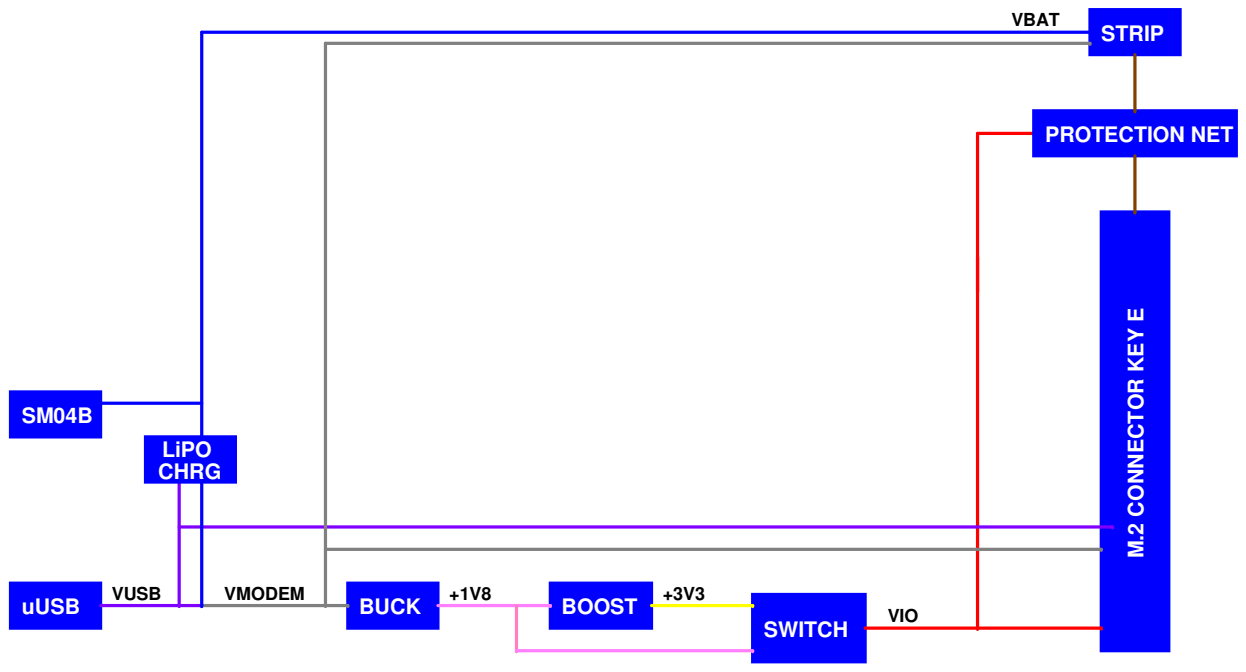
[picture p42: page 2]
M.2 CONNECTOR KEY E; VUSB uUSB; PROTECTION NET; +1V8 VIO BUCK; SWITCH; +3V3 BOOST VMODEM; LiPO CHRG; Project Code; Rev.; Rev. changes; Sheet; Board; Project; Code; Page name; Data; Designed by; Internal Code; 01 - BLOCK DIAGRAM; NOTECARRIER-M2-BH; NOTEBOX; See Revision Page; Address:; Mail: Phone:; Blues Inc

via C. Battisti, 136
24025 Gazzaniga (Bg), Italy
Mail: info@fae.technology
Phone: +39035738130

EDGE CONNECTOR | POWER

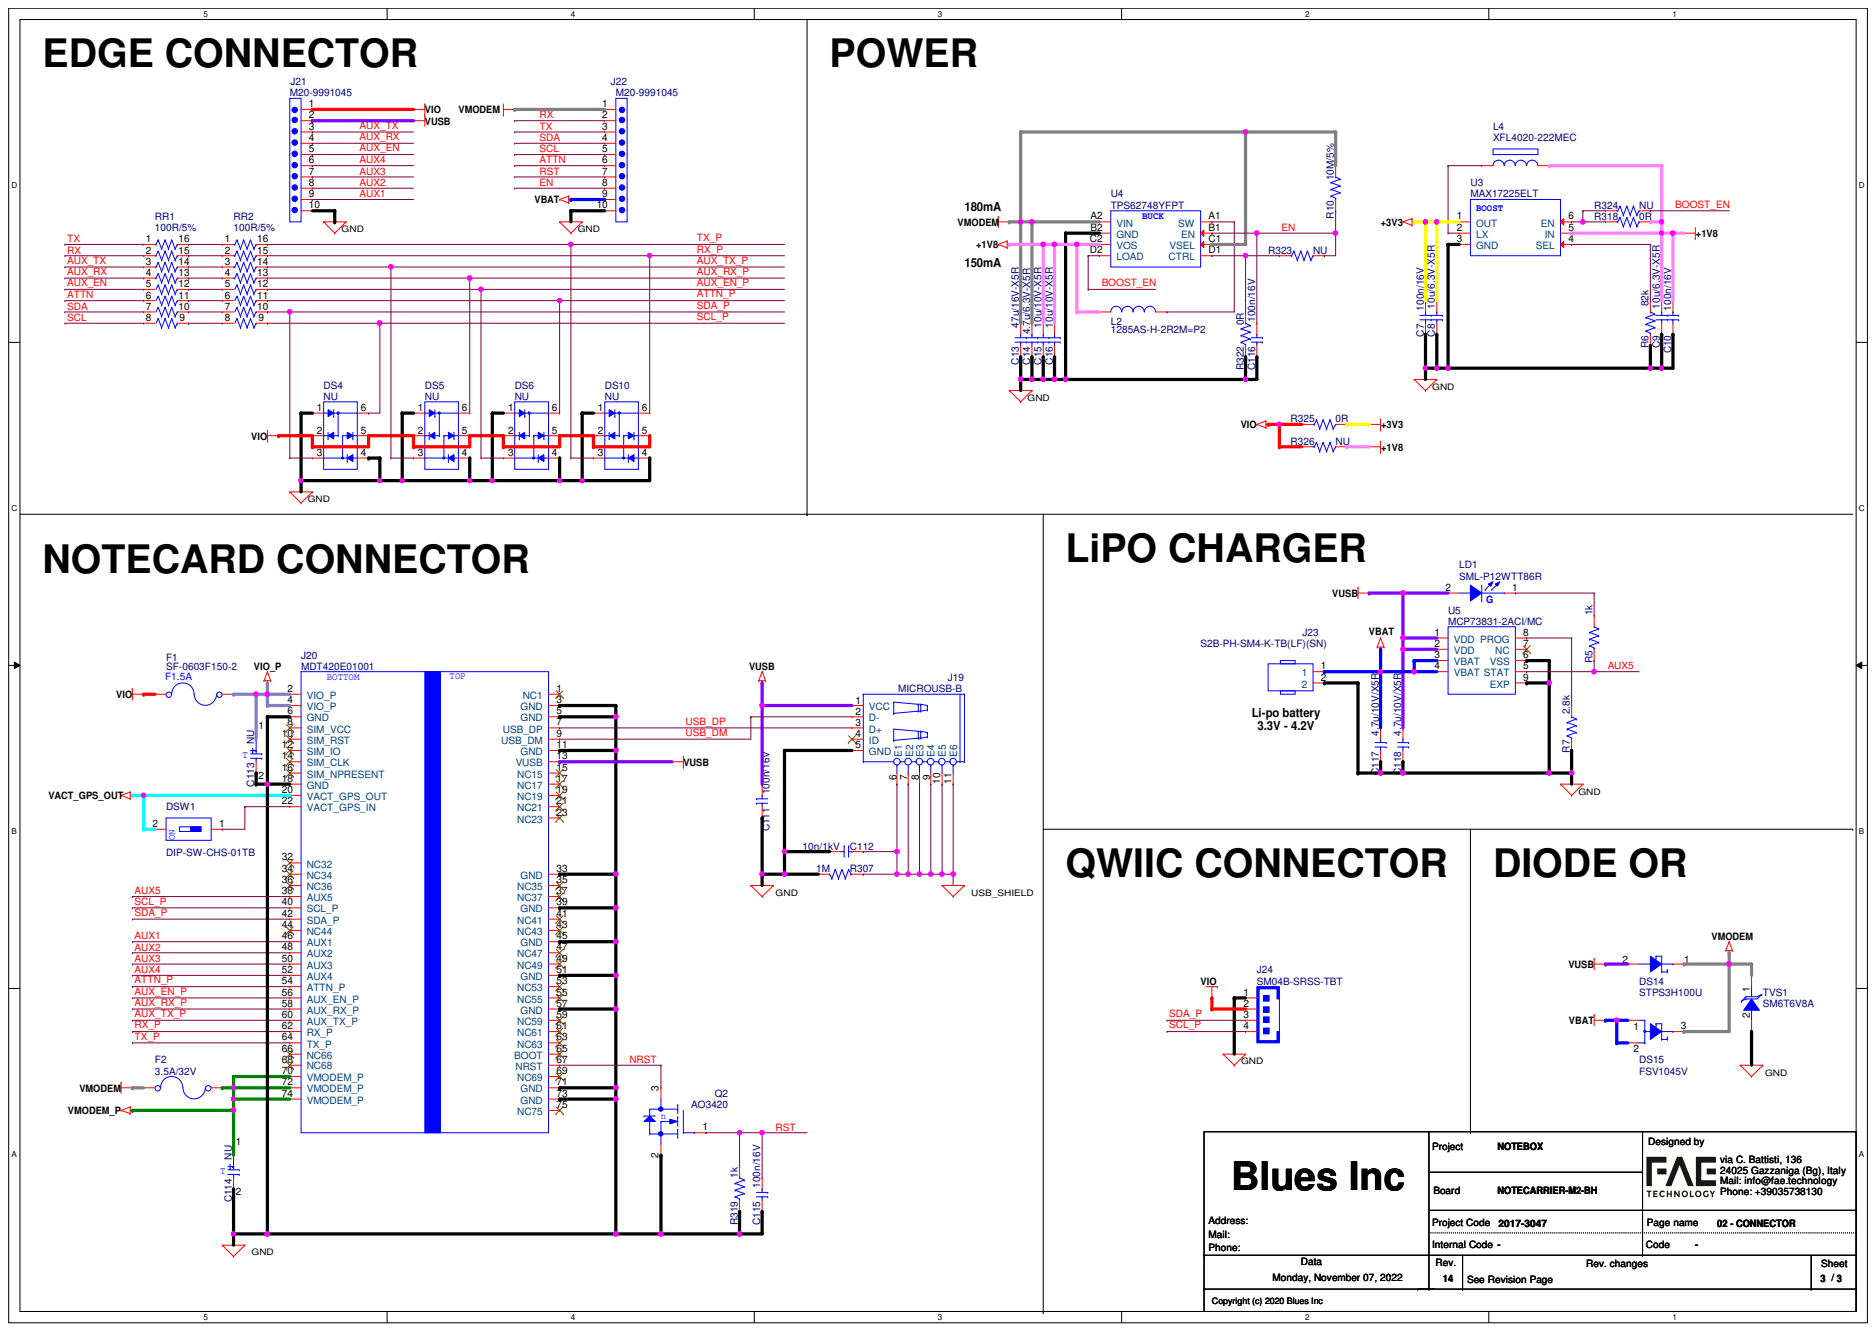
[picture p43: page 3]

SCL_P

via C. Battisti, 136
24025 Gazzaniga (Bg), Italy
Mail: info@fae.technology
Phone: +39035738130
