robouden/note-hardware/Notecarrier-R/v1.0/SCH + BOM/SCH/20231252_notecarrier-m2-r_v1.pdf

# NOTECARRIER-M2-R

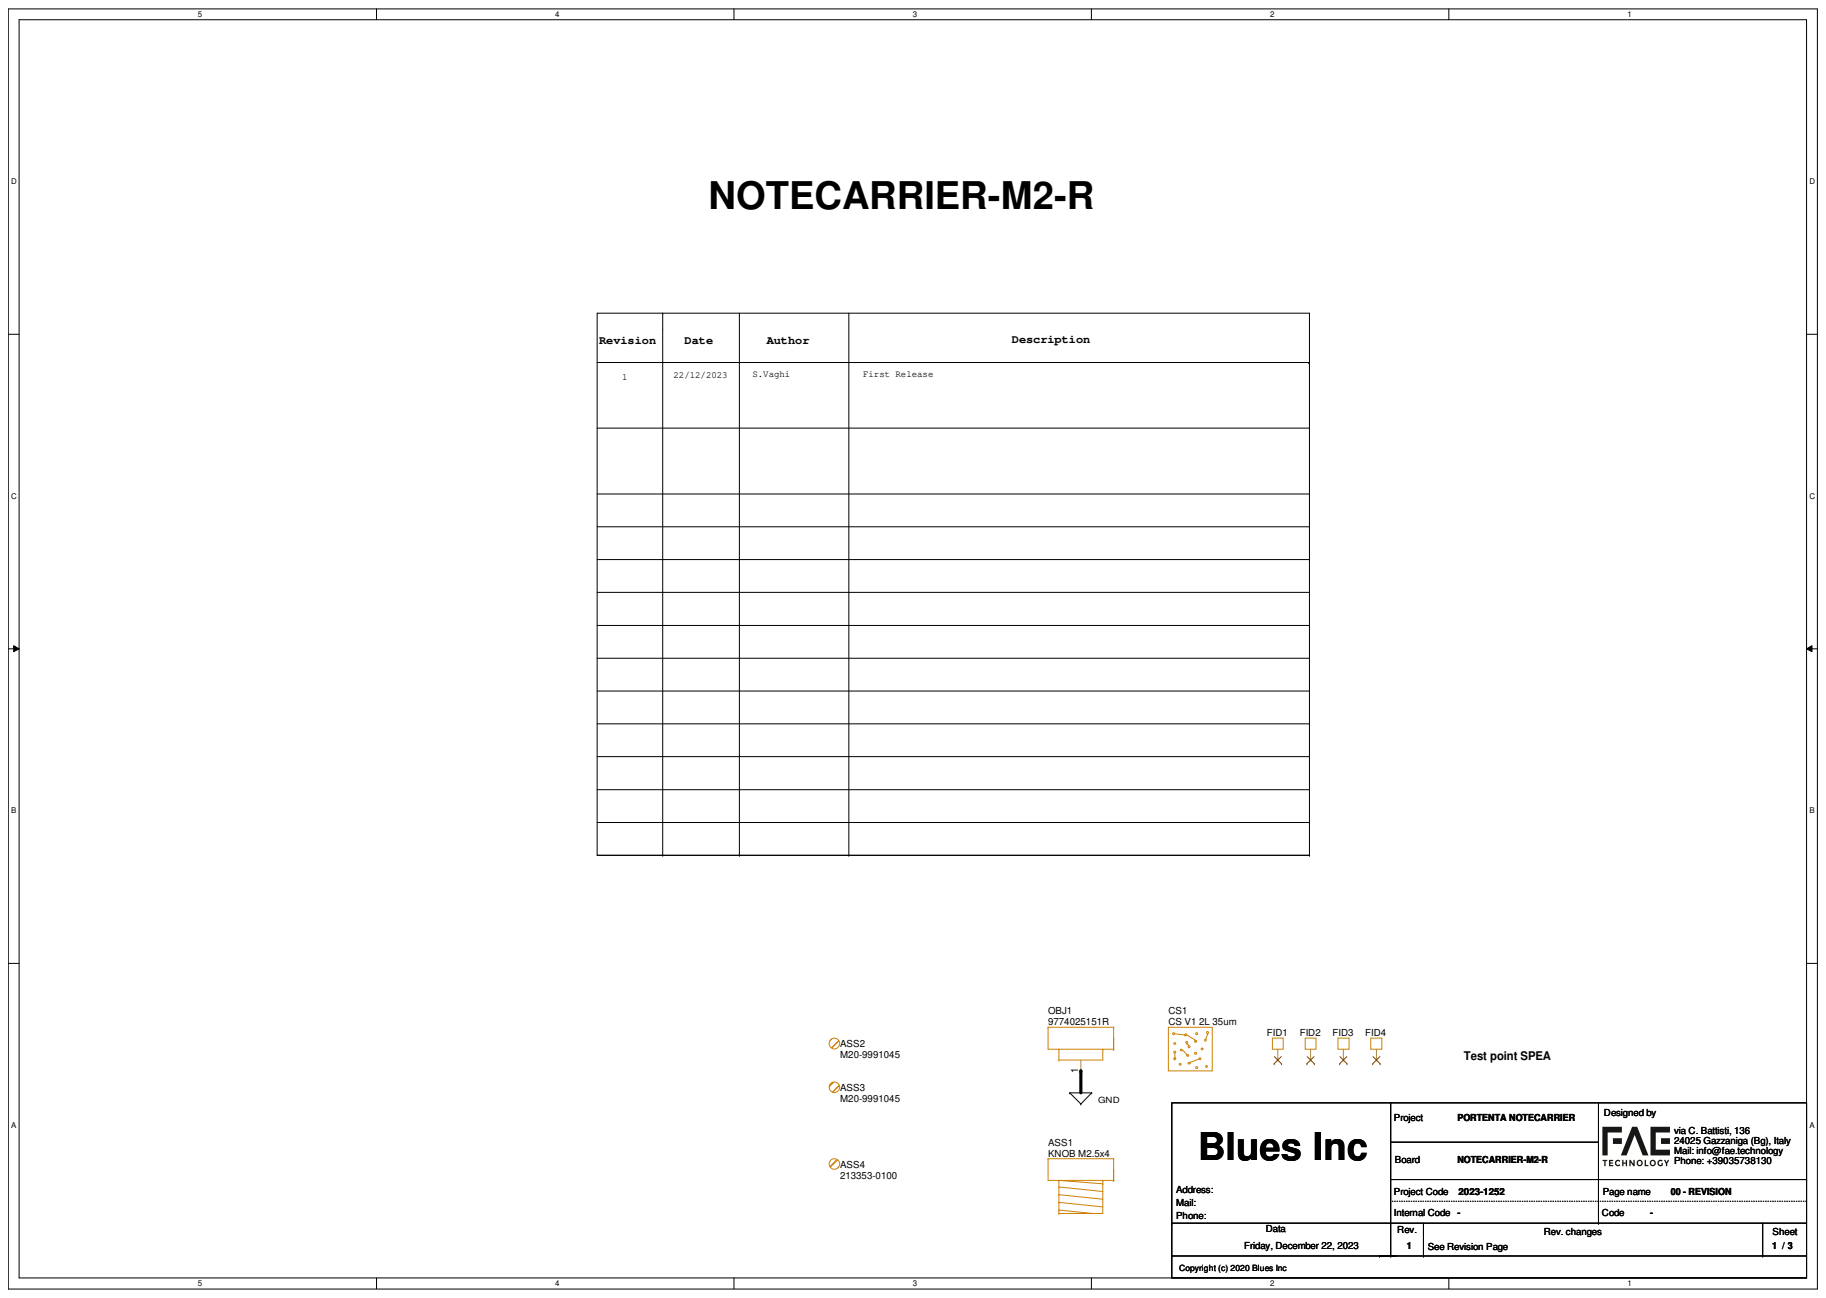
[picture p44: page 1]
Revision; Date; Author; Description; S.Vaghi; First Release 1; GND; Project Code; Rev.; Rev. changes; Sheet; Board; Project; Code; Page name; Data; Designed by; Internal Code; Friday, December 22, 2023; 00 - REVISION; NOTECARRIER-M2-R; PORTENTA NOTECARRIER; See Revision Page; Address:; Mail: Phone:; Blues Inc; FID4; ASS2;  ASS4 213353-0100; OBJ1 9774025151R; ASS1 KNOB M2.5x4; FID2; ASS3; FID1; FID3

Test point SPEA

via C. Battisti, 136
24025 Gazzaniga (Bg), Italy
Mail: info@fae.technology
Phone: +39035738130

Copyright (c) 2020 Blues Inc

# STRIP

# NOTECARRIER-M2-R

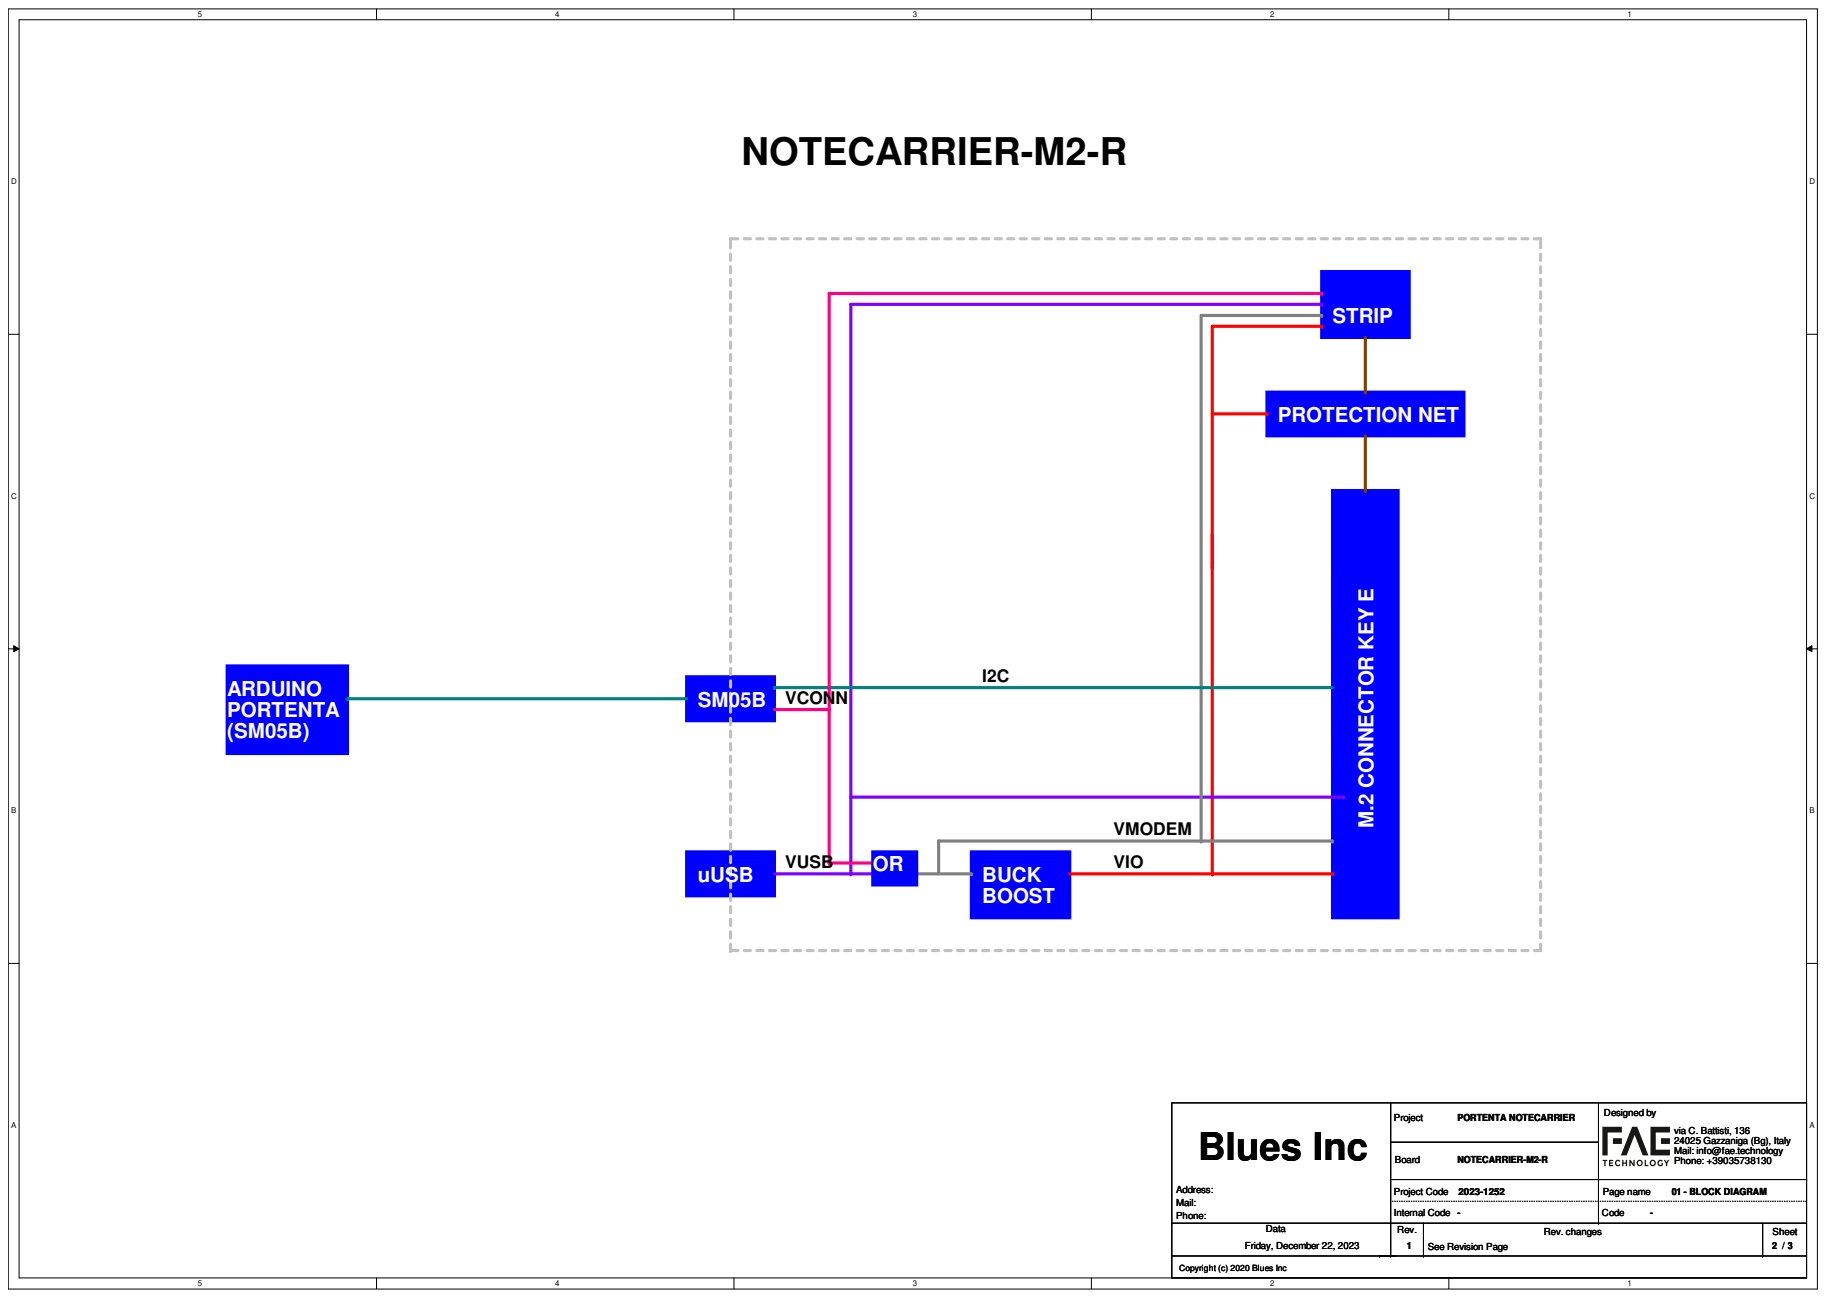
[picture p45: page 2]
M.2 CONNECTOR KEY E; VUSB uUSB; PROTECTION NET; VIO BUCK; BOOST; VMODEM; I2C ARDUINO; PORTENTA (SM05B); VCONN; Project Code; Rev.; Rev. changes; Sheet; Board; Project; Code; Page name; Data; Designed by; Internal Code; Friday, December 22, 2023; 01 - BLOCK DIAGRAM; NOTECARRIER-M2-R; PORTENTA NOTECARRIER; See Revision Page; Address:; Mail: Phone:; Blues Inc

via C. Battisti, 136
24025 Gazzaniga (Bg), Italy
Mail: info@fae.technology
Phone: +39035738130

EDGE CONNECTOR | POWER

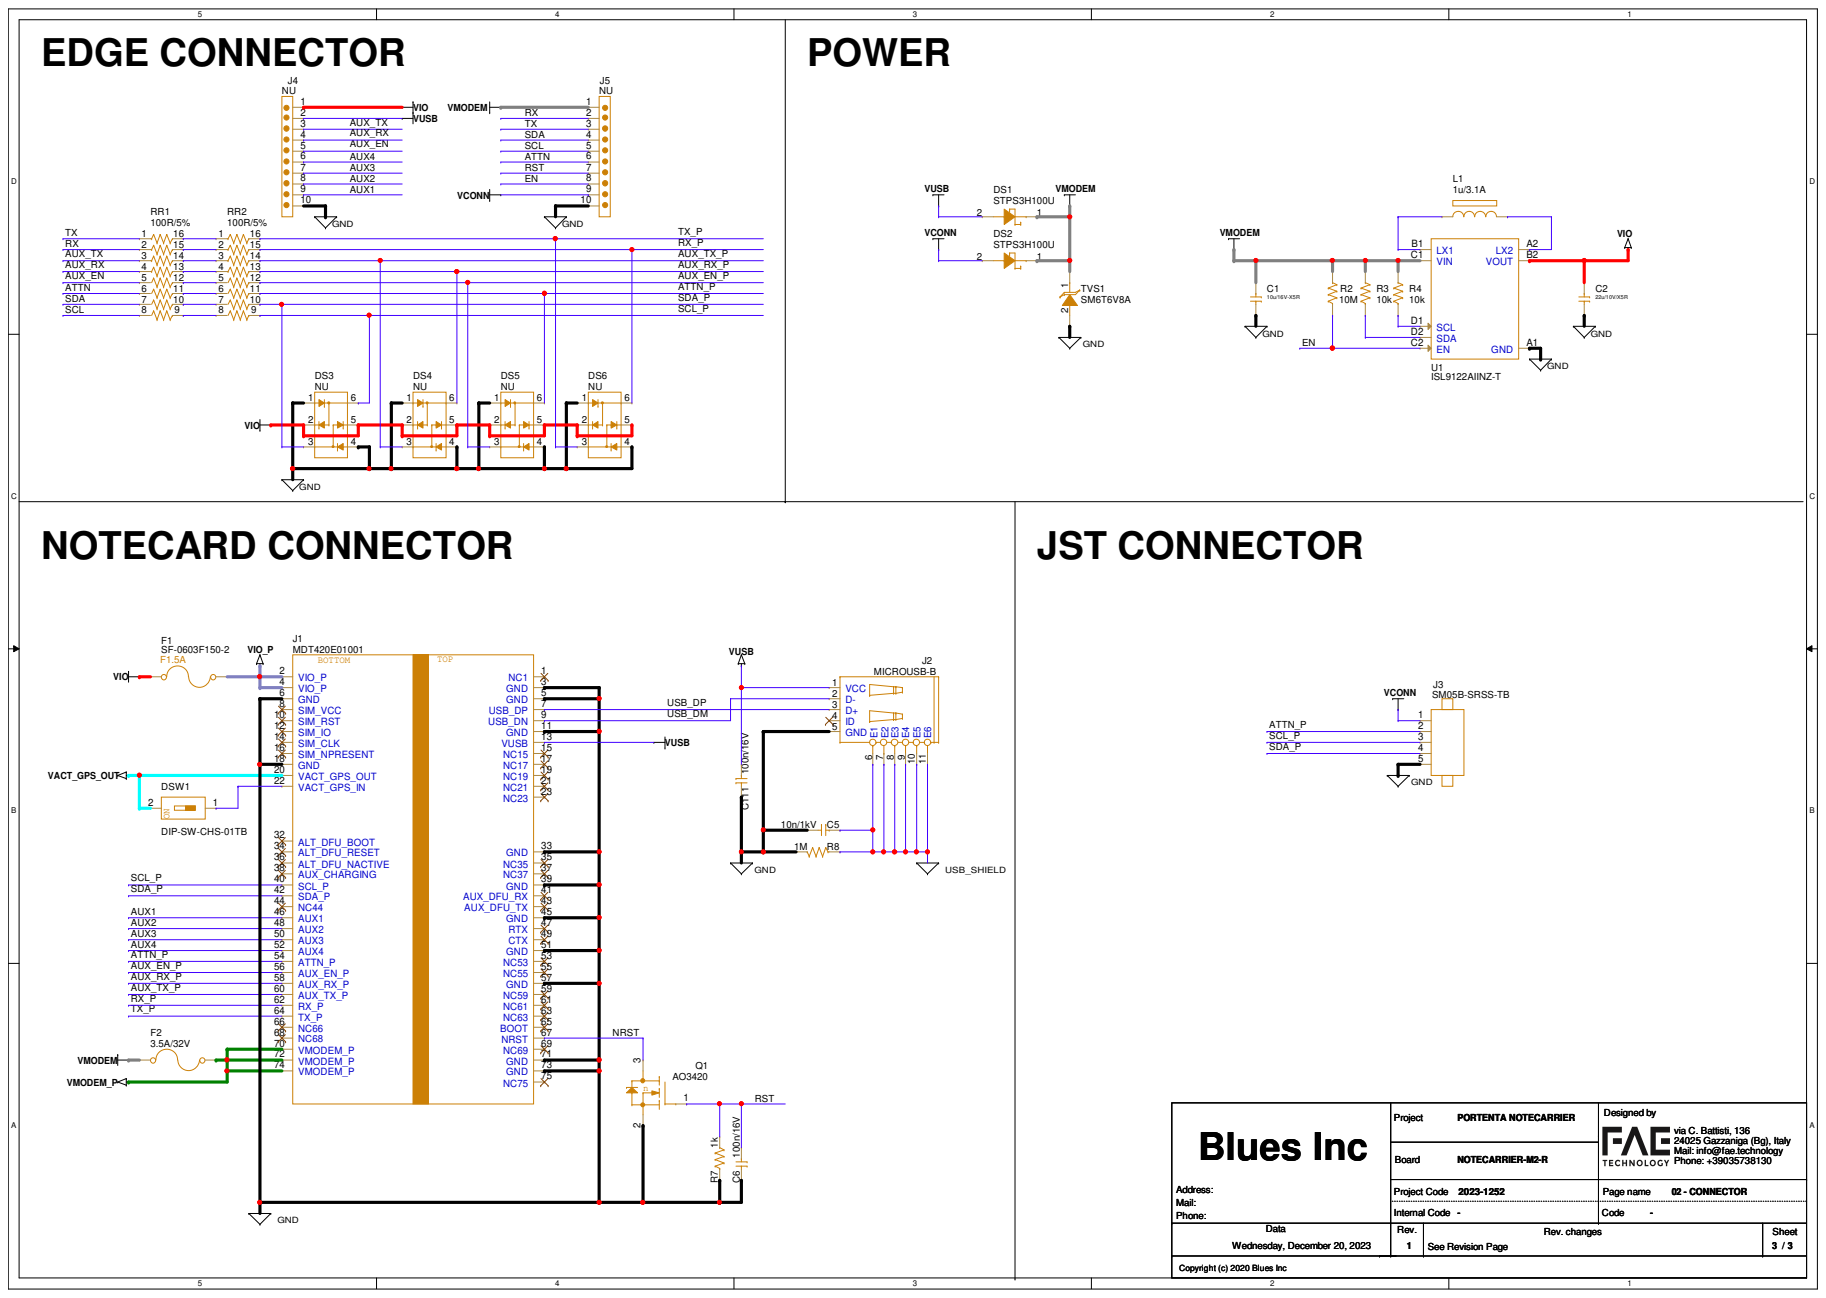
[picture p46: page 3]

F1 SF-0603F150-2 VIO_P VUSB F1.5A J2 | VCONN

VCC 1

via C. Battisti, 136
24025 Gazzaniga (Bg), Italy
Mail: info@fae.technology
Phone: +39035738130
