robouden/note-hardware/100379_mincarrier-b_Rev-10.PDF

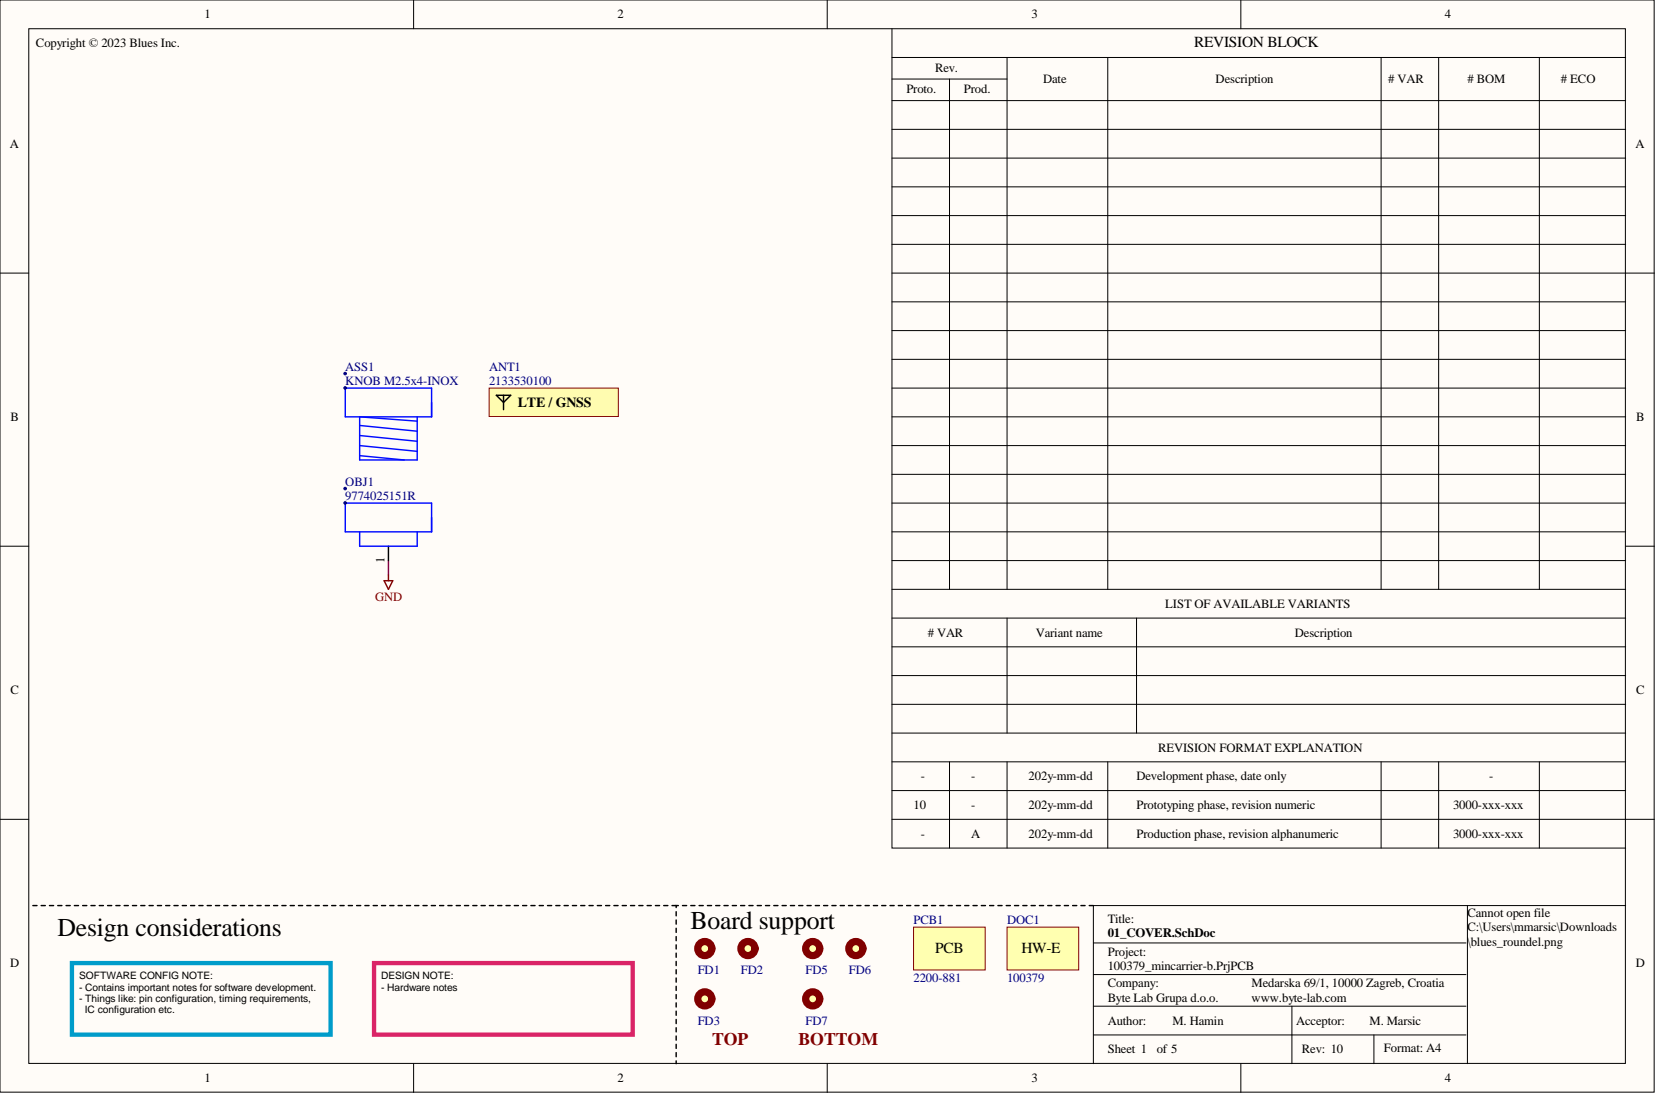
[picture p47: page 1]

Prod.

# VAR | # ECO

LIST OF AVAILABLE VARIANTS

- | - | 202y-mm-dd | Development phase, date only | -

10 - 3000-xxx-xxx | -A | 202y-mm-dd | Prototyping phase, revision numeric Production phase, revision alphanumeric | 3000-xxx-xxx

SOFTWARE CONFIG NOTE:
- Contains important notes for software development.
- Things like: pin configuration, timing requirements,
IC configuration etc.

Medarska 69/1, 10000 Zagreb, Croatia
www.byte-lab.com

Author: M. Hamin | Acceptor: M. Marsic

Sheet 1 of 5 | Rev: 10 | Format: A4

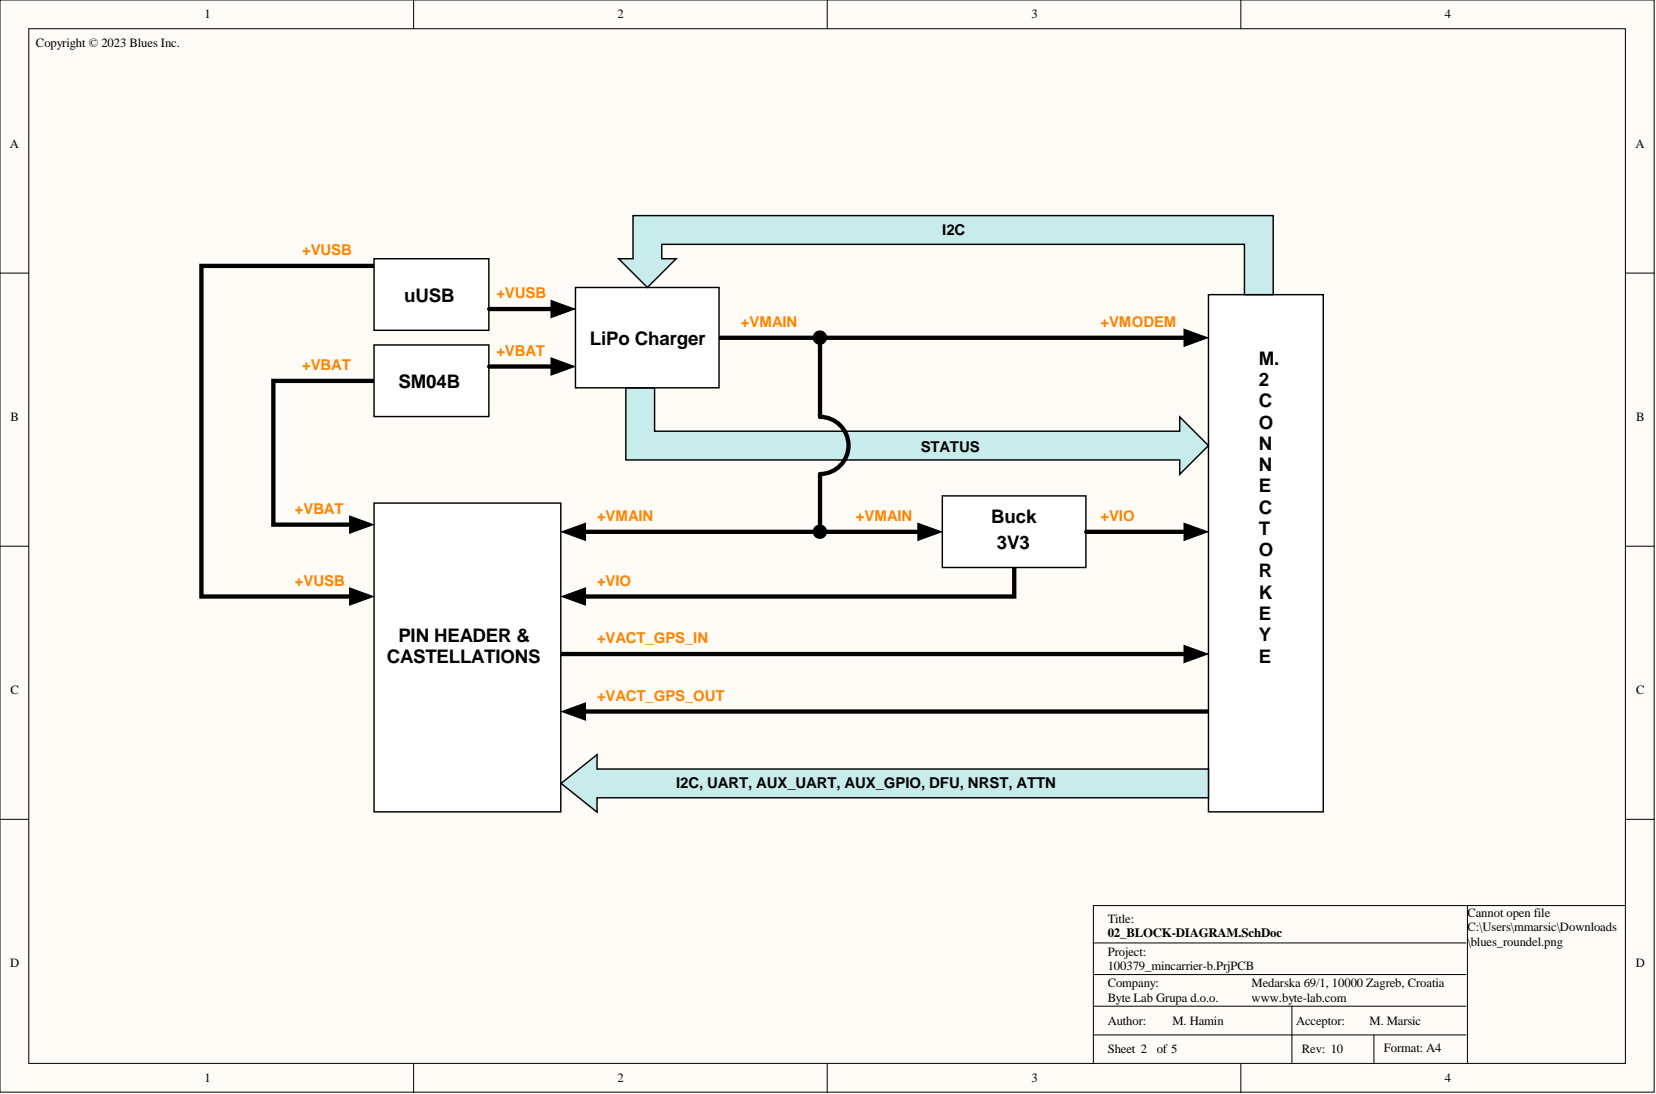
[picture p48: page 2]

I2C, UART, AUX_UART, AUX_GPIO, DFU, NRST, ATTN

Medarska 69/1, 10000 Zagreb, Croatia
www.byte-lab.com

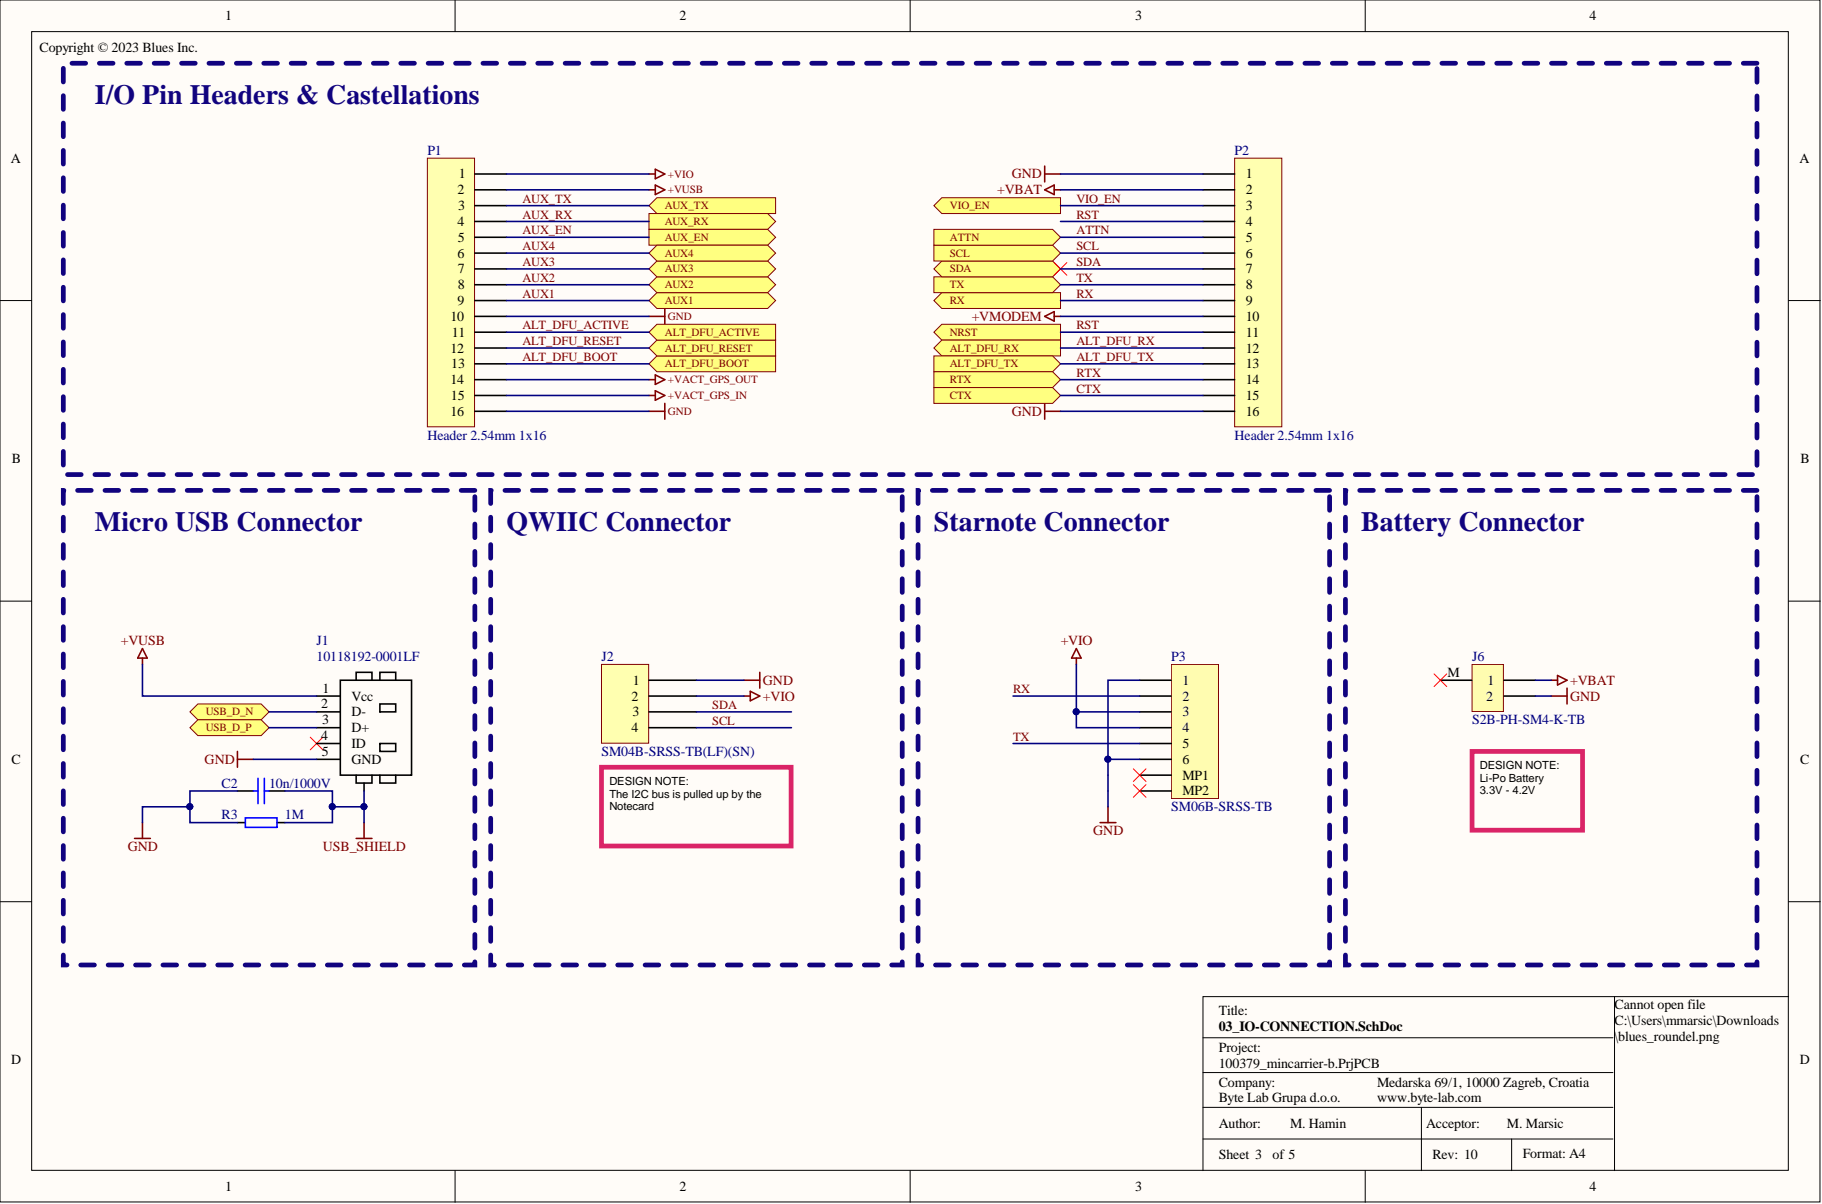
[picture p49: page 3]

SM04B-SRSS-TB(LF)(SN)

3.3V - 4.2V DESIGN NOTE:
The I2C bus is pulled up by the
Notecard

Medarska 69/1, 10000 Zagreb, Croatia
www.byte-lab.com

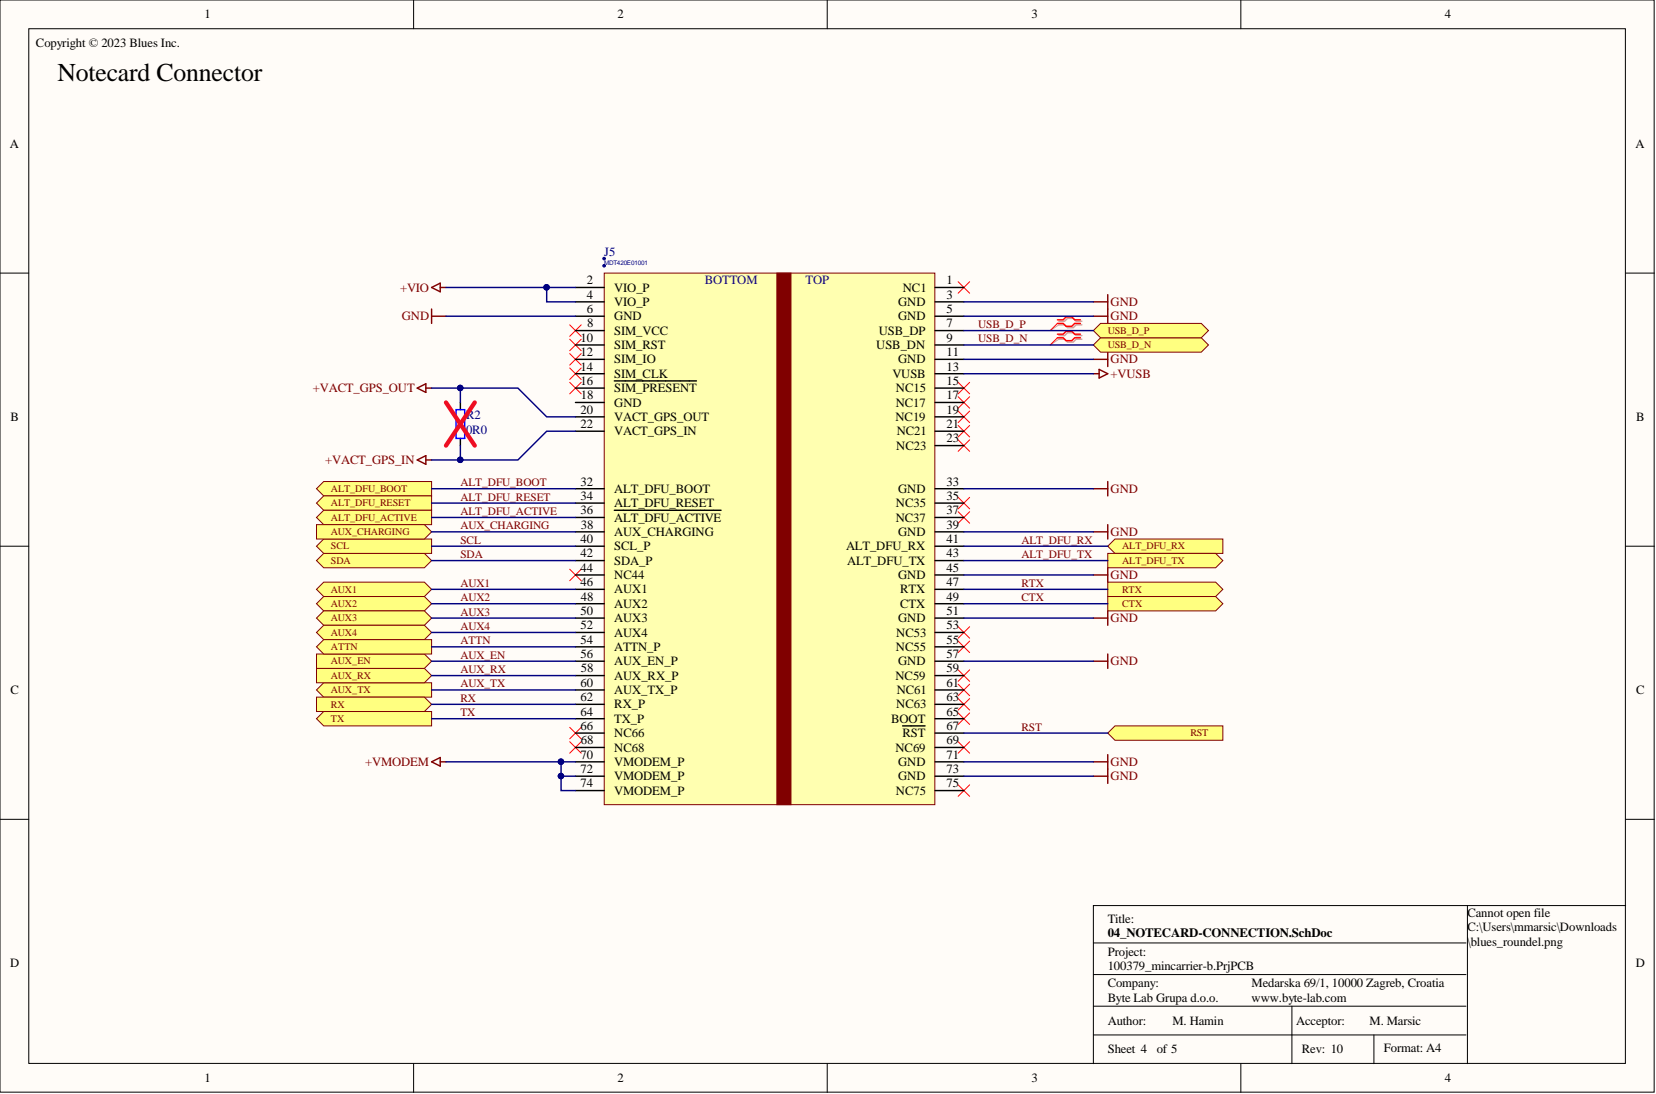
[picture p50: page 4]

7 2 | 7 3
7 4

A u tho r : M . Hamin | A c cep tor : M . M arsi c

She e t o f | Rev : | For m a t: A

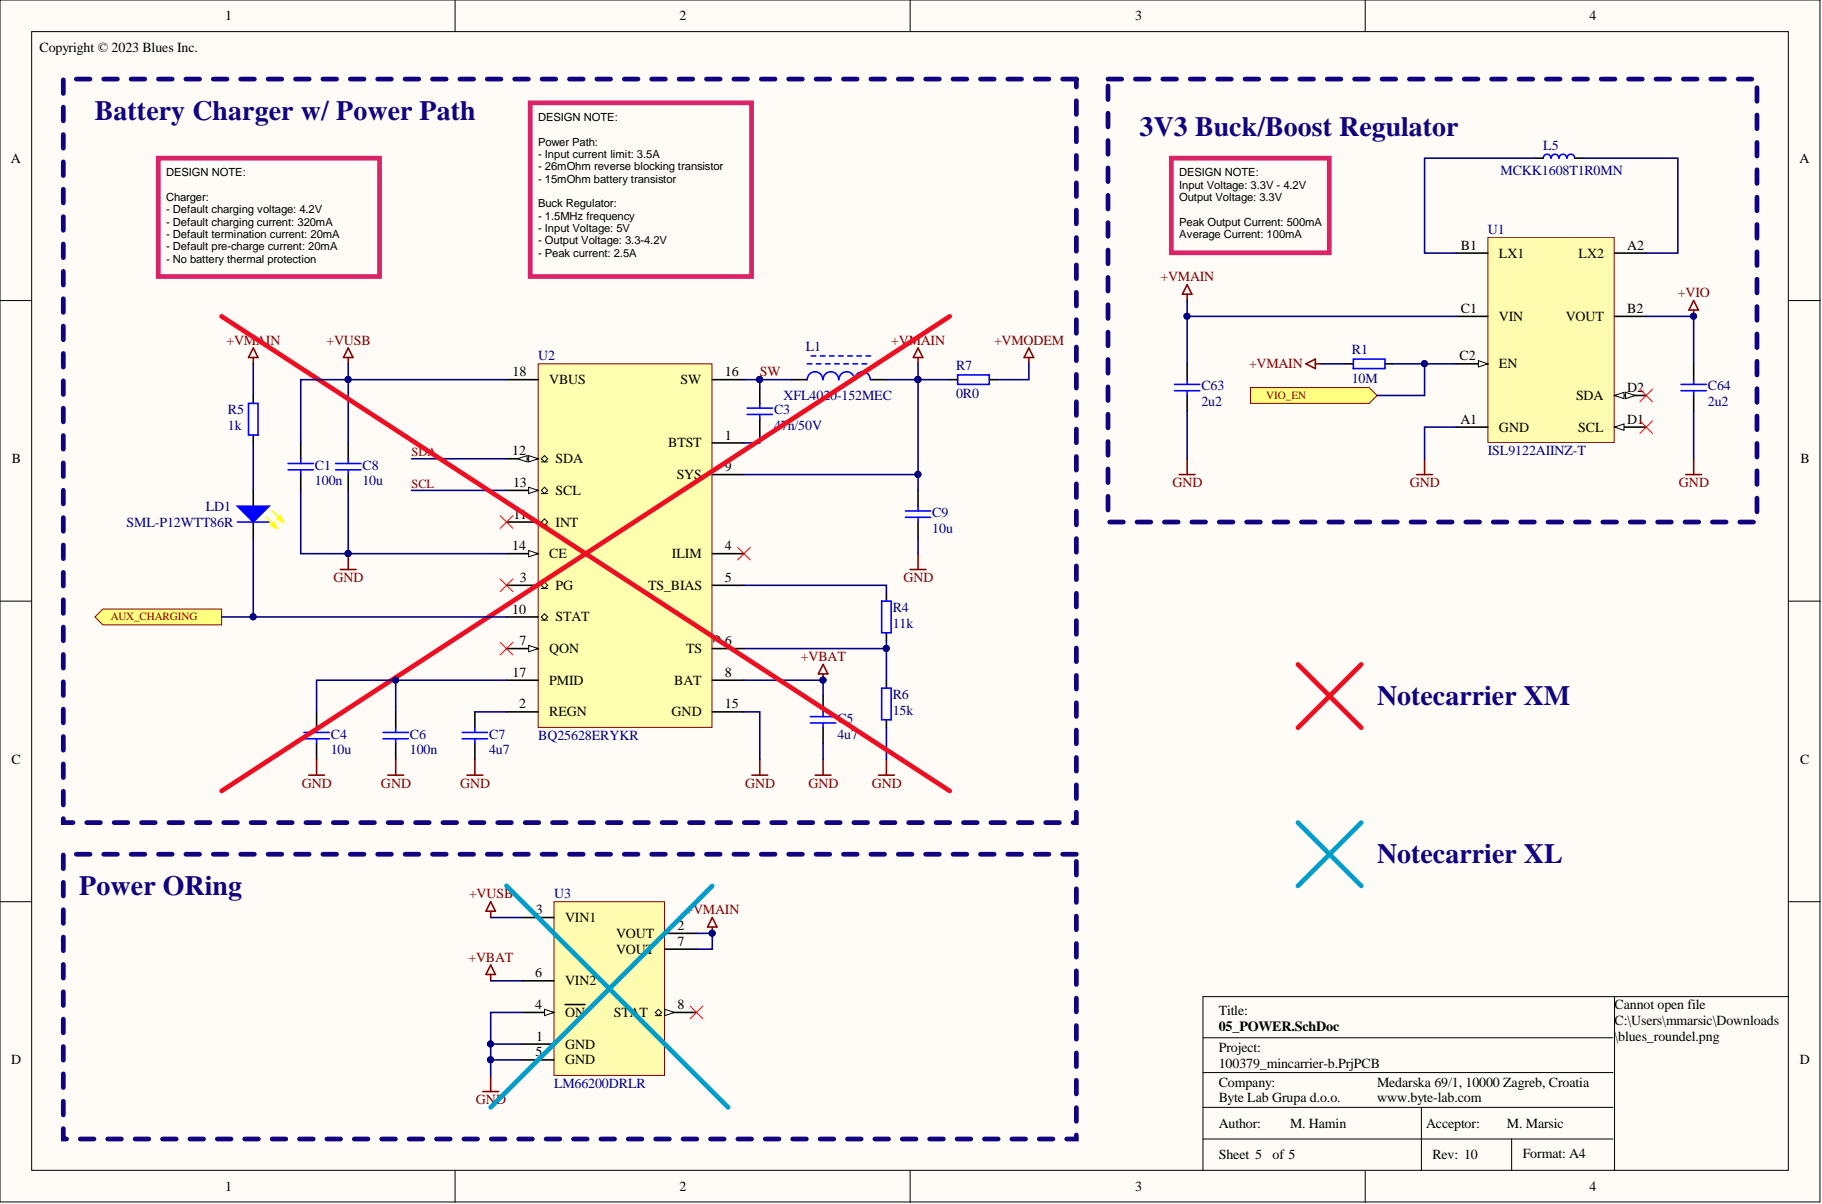
[picture p51: page 5]

Charger:
- Default charging voltage: 4.2V
- Default charging current: 320mA
- Default termination current: 20mA
- Default pre-charge current: 20mA
- No battery thermal protection

PMID 17 | +VBAT

REGN 2

Title: 05_POWER.SchDoc | Cannot open file C:\Users\mmarsic\Downloads \blues_roundel.png

GND 1
GND 5

Medarska 69/1, 10000 Zagreb, Croatia
www.byte-lab.com
