robouden/note-hardware/2200-881_Dimensions.PDF

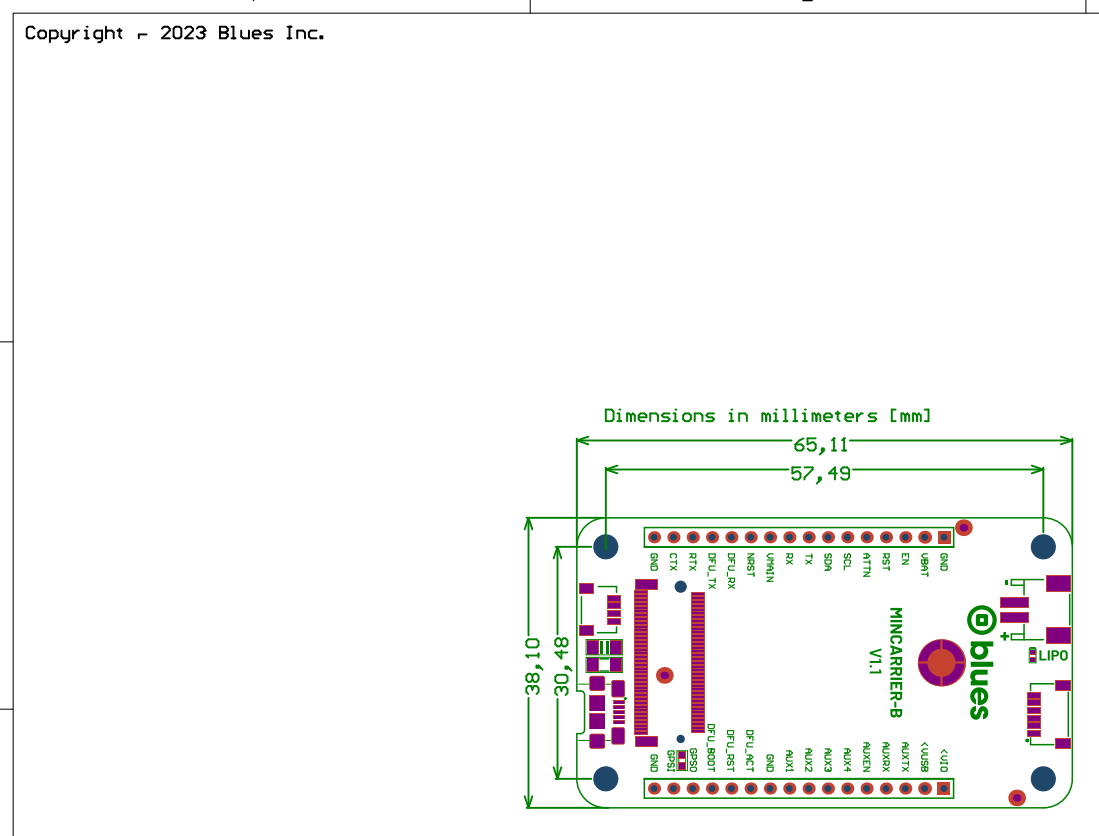
[picture p52: page 1]
