robouden/note-hardware/Notecarrier-B/v1.6/Notecarrier-B schematic v1.6.pdf

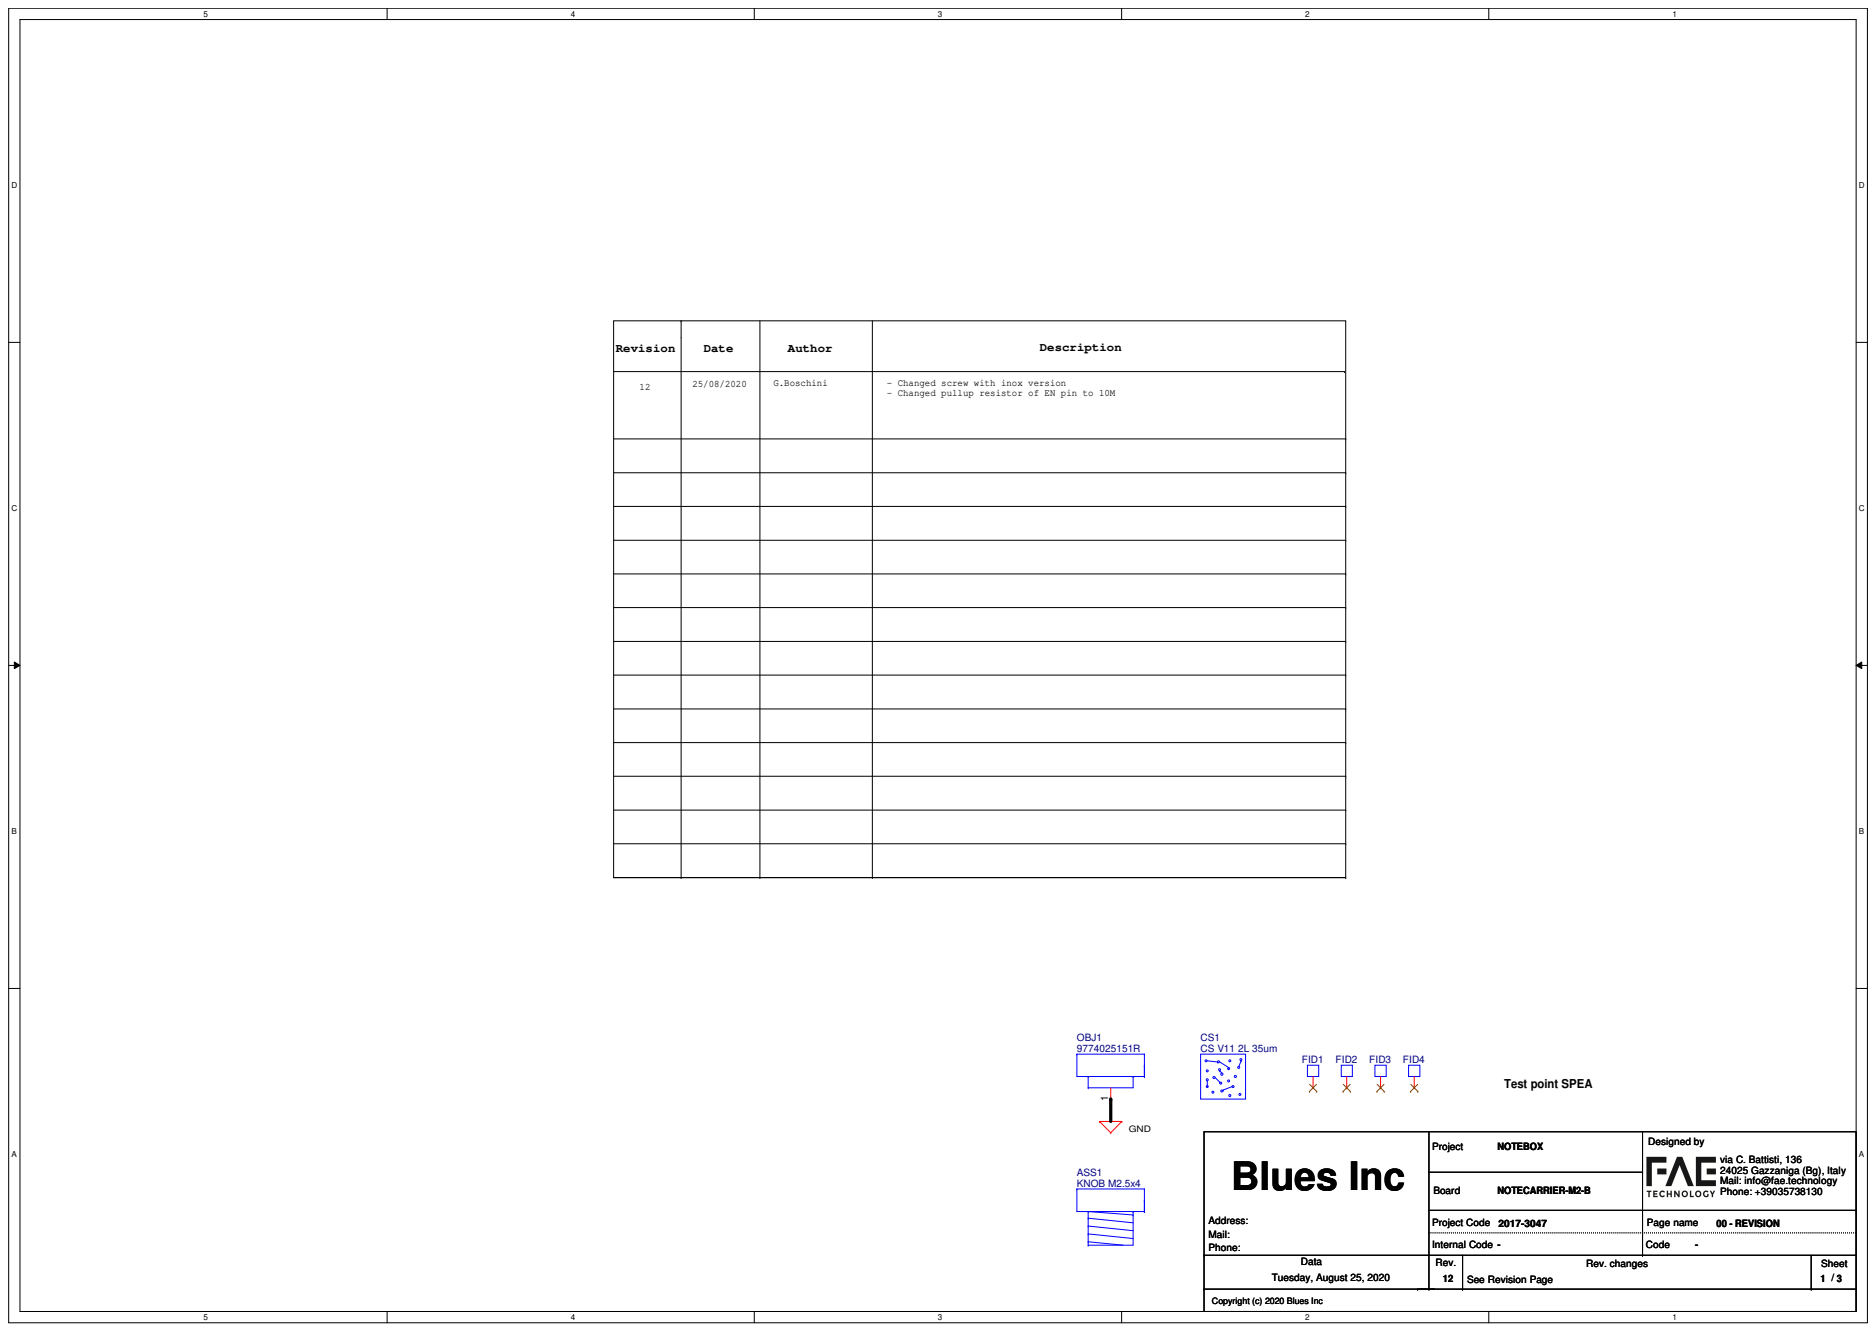
[picture p53: page 1]
Revision; Date; Author; Description; G.Boschini 12; GND; Project Code; Rev.; Rev. changes; Sheet; Board; Project; Code; Page name; Data; Designed by; Internal Code; Tuesday, August 25, 2020; 00 - REVISION; NOTECARRIER-M2-B; NOTEBOX; See Revision Page; Address:; Mail: Phone:; Blues Inc; FID4; OBJ1 9774025151R; ASS1 KNOB M2.5x4; FID1; FID2; FID3

- Changed screw with inox version
- Changed pullup resistor of EN pin to 10M

Test point SPEA

via C. Battisti, 136
24025 Gazzaniga (Bg), Italy
Mail: info@fae.technology
Phone: +39035738130

Copyright (c) 2020 Blues Inc

V+

# STRIP

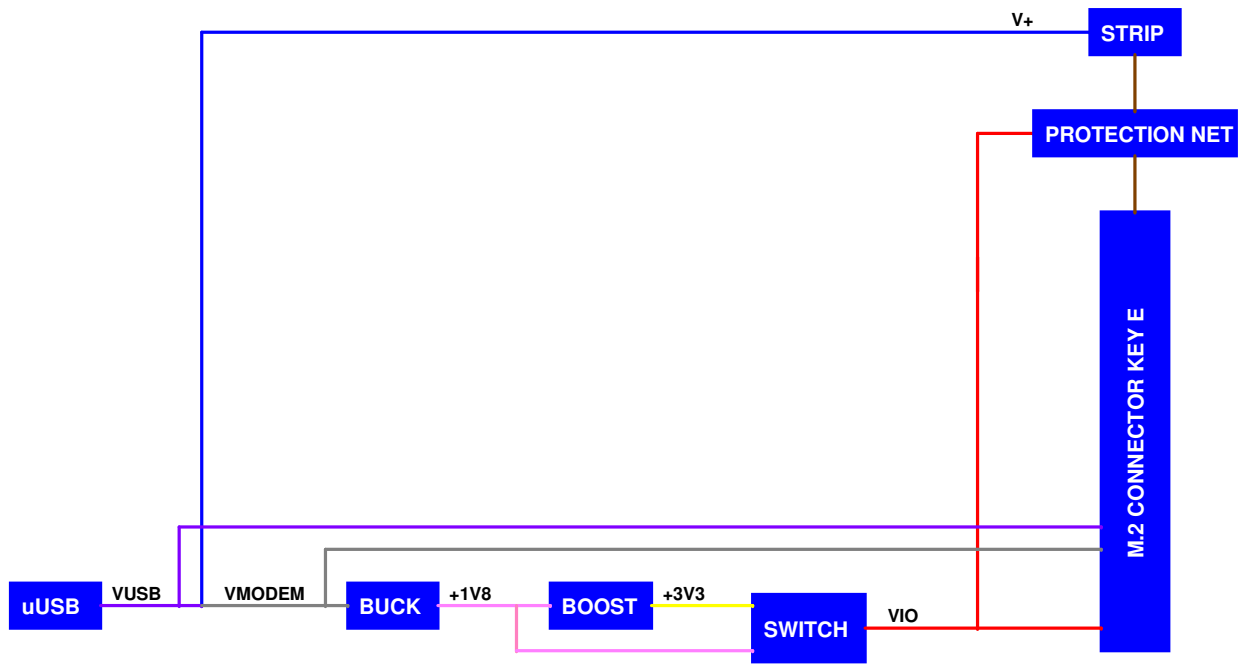
[picture p54: page 2]
M.2 CONNECTOR KEY E; VUSB uUSB; PROTECTION NET; +1V8 VIO BUCK; SWITCH; +3V3 BOOST VMODEM; Project Code; Rev.; Rev. changes; Sheet; Board; Project; Code; Page name; Data; Designed by; Internal Code; 01 - BLOCK DIAGRAM; NOTECARRIER-M2-B; NOTEBOX; See Revision Page; Address:; Mail: Phone:; Blues Inc

via C. Battisti, 136
24025 Gazzaniga (Bg), Italy
Mail: info@fae.technology
Phone: +39035738130

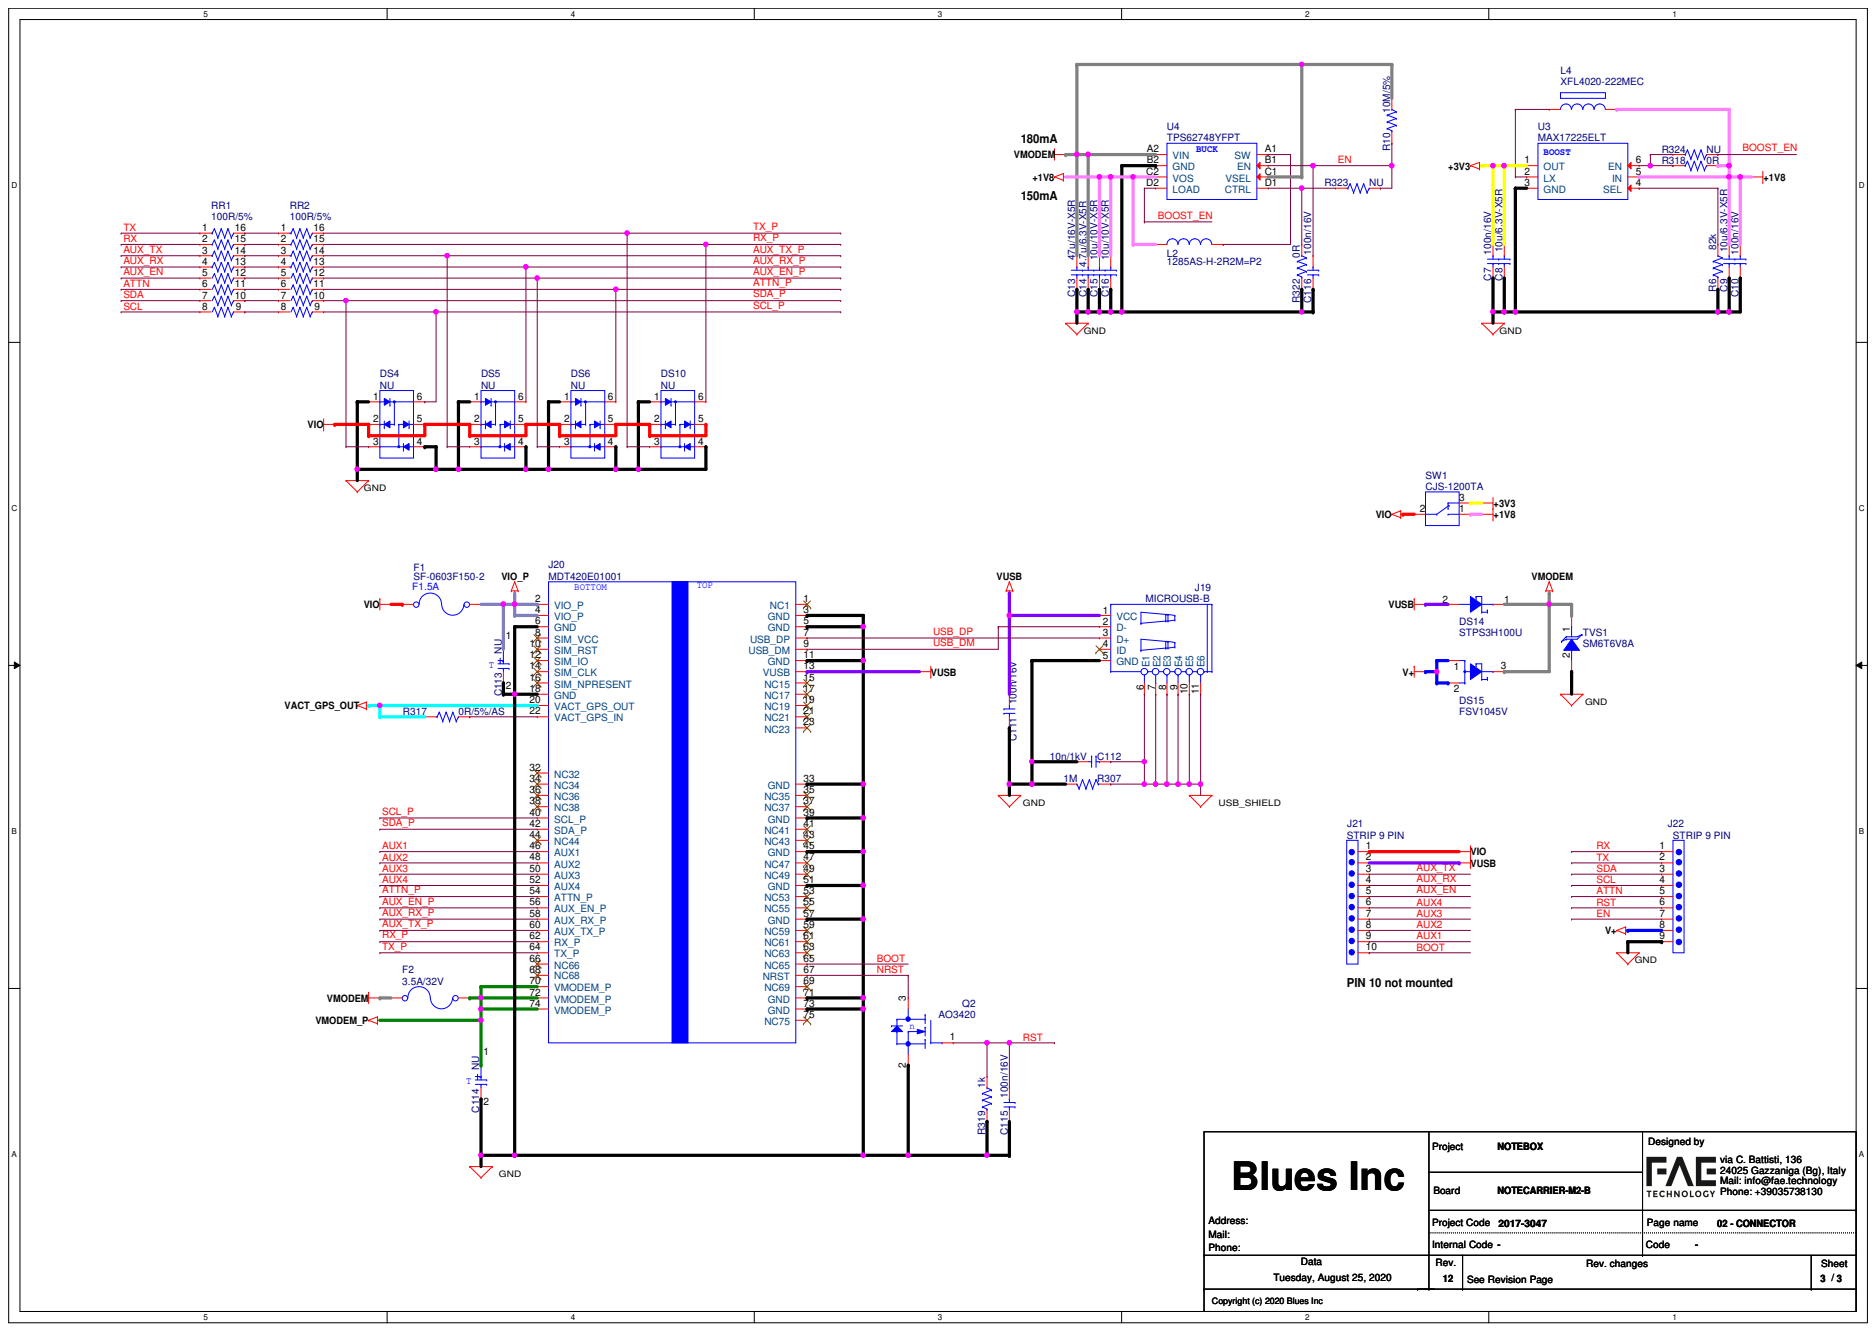
[picture p55: page 3]

via C. Battisti, 136
24025 Gazzaniga (Bg), Italy
Mail: info@fae.technology
Phone: +39035738130

Project Code Project Code Project Code | Page name Page name Page name 02 - CONNECTOR 02 - CONNECTOR 02 - CONNECTOR

Internal Code Internal Code Internal Code --- | Code Code Code ---
