robouden/note-hardware/Notecarrier-B/v1.6/Notecarrier-B drawing v1.6.pdf

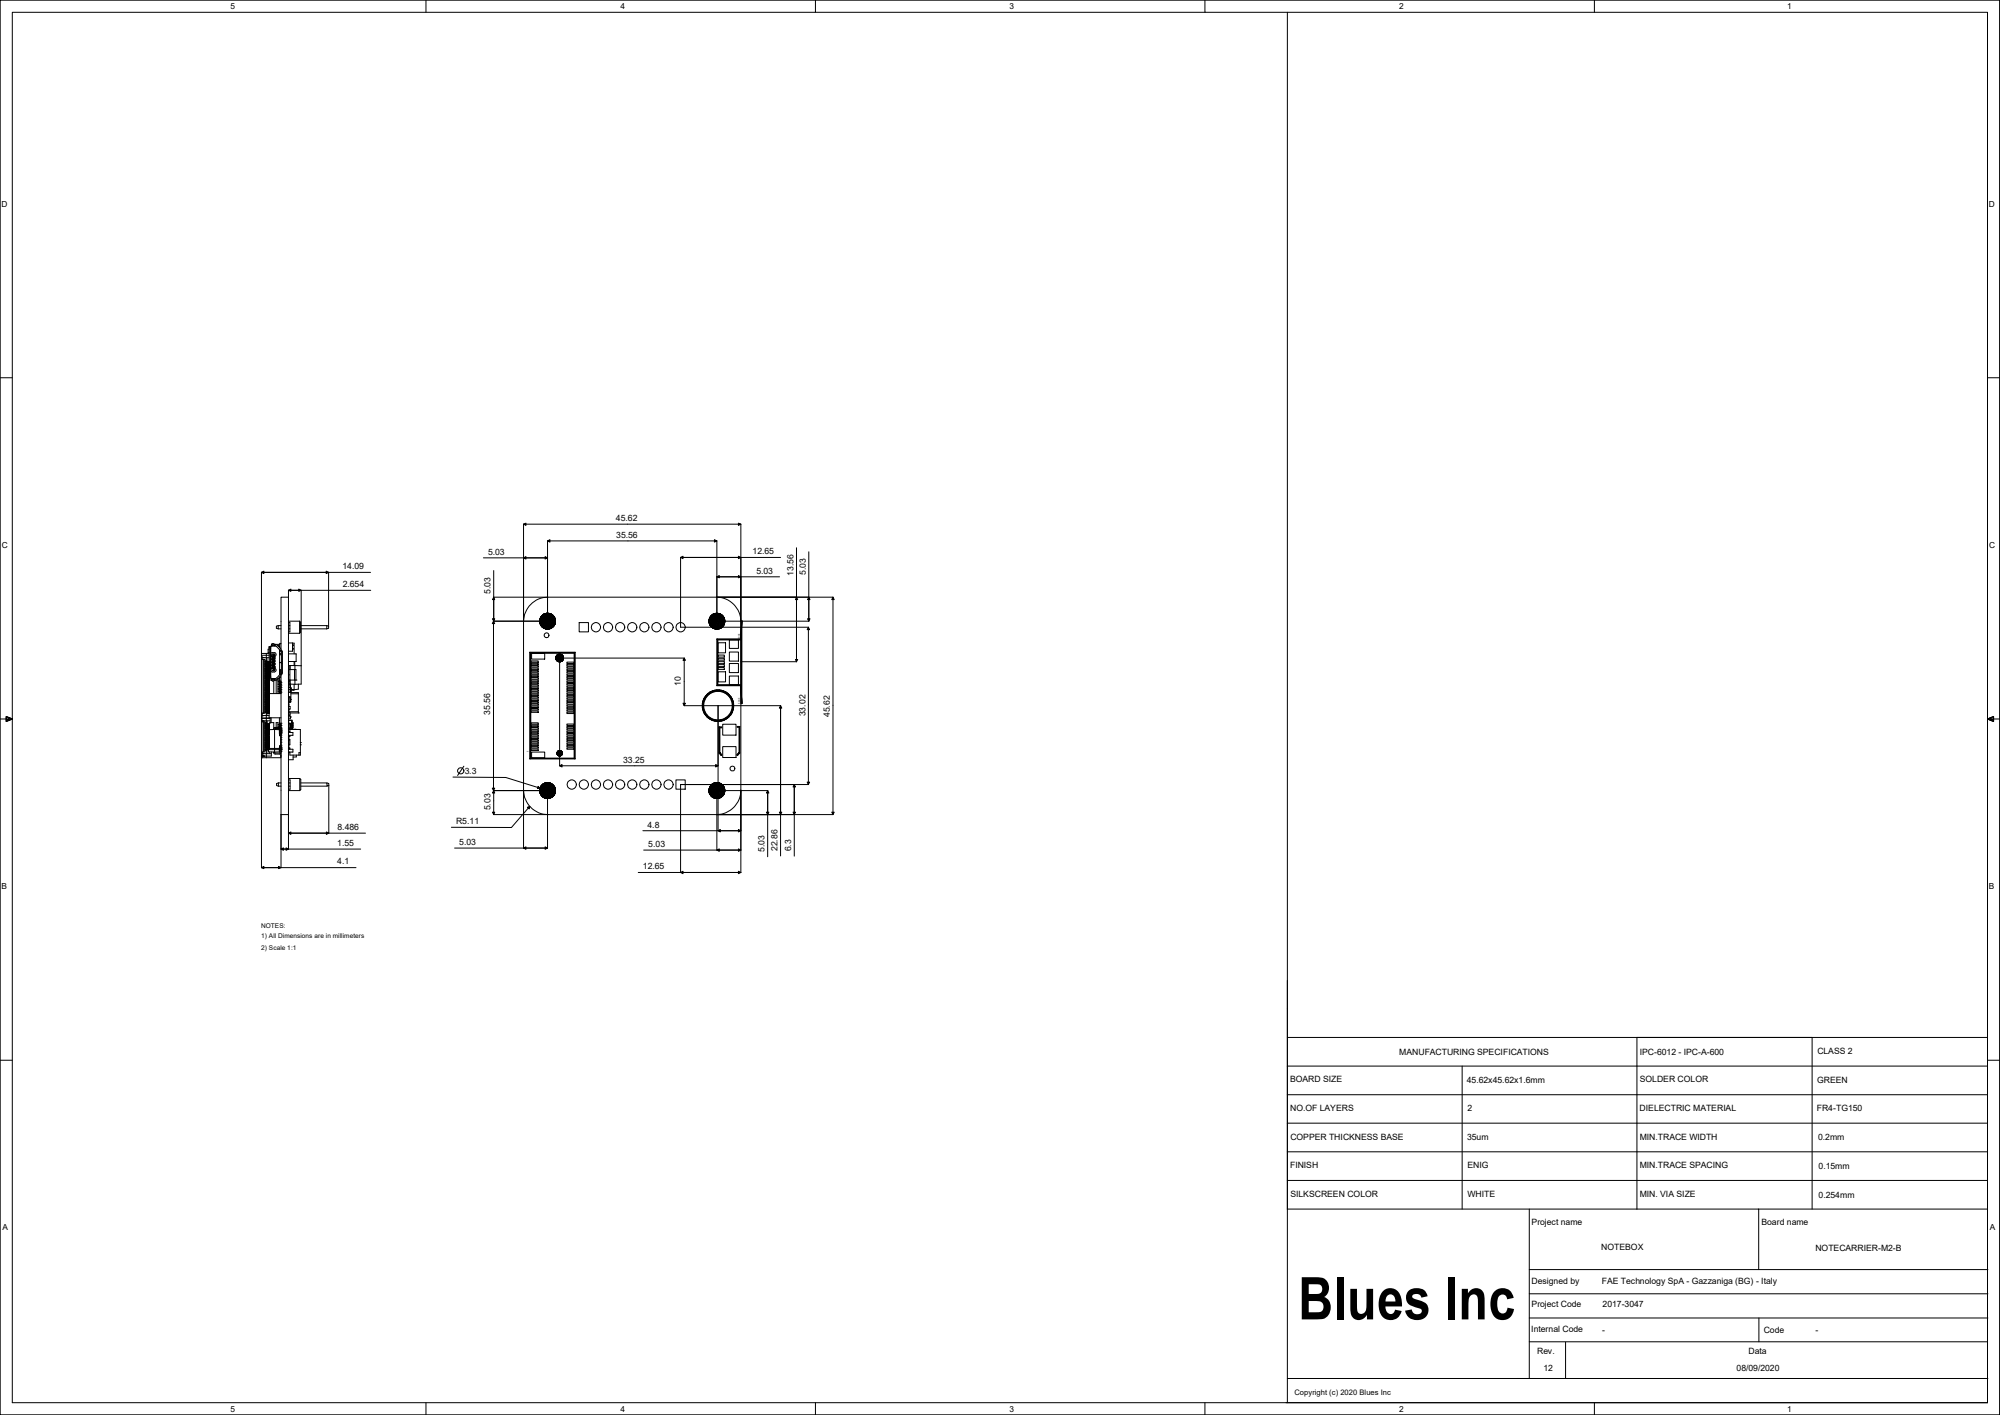
[picture p56: page 1]
6.3 33.02EDGE EDGE; IPC-6012 - IPC-A-600; CLASS 2; A Project name; Board name; Internal Code; Designed by; Project Code; Code; NOTECARRIER-M2-B; Rev.; Data; NOTEBOX; GREEN; SOLDER COLOR; DIELECTRIC MATERIAL; FINISH; SILKSCREEN COLOR; WHITE; ENIG; BOARD SIZE; MANUFACTURING SPECIFICATIONS; Blues Inc

NOTES:
1) All Dimensions are in millimeters
2) Scale 1:1

NO.OF LAYERS

COPPER THICKNESS BASE

MIN.TRACE WIDTH

MIN.TRACE SPACING

MIN. VIA SIZE

FAE Technology SpA - Gazzaniga (BG) - Italy

Copyright (c) 2020 Blues Inc
