robouden/note-hardware/(list of files, drawings)

Other design files:
Notecarrier-A/v2.0/Notecarrier-A schematic v2.0.dsn
Notecarrier-B/v1.6/Notecarrier-B schematic v1.6.dsn
Notecarrier-B/v3.1/SCH + BOM/SCH/20173047_NOTECARRIER-M2-BH_V14.DSN
Notecarrier-R/v1.0/SCH + BOM/SCH/20231252_NOTECARRIER-M2-R_V1.DSN
