robouden/note-hardware/Notecarrier-Mirco/Notecarrier-Micro/Notecarrier-Micro.kicad_pcb

## KiCad design Notecarrier-Mirco/Notecarrier-Micro/Notecarrier-Micro.kicad_pcb (2024-05-01)

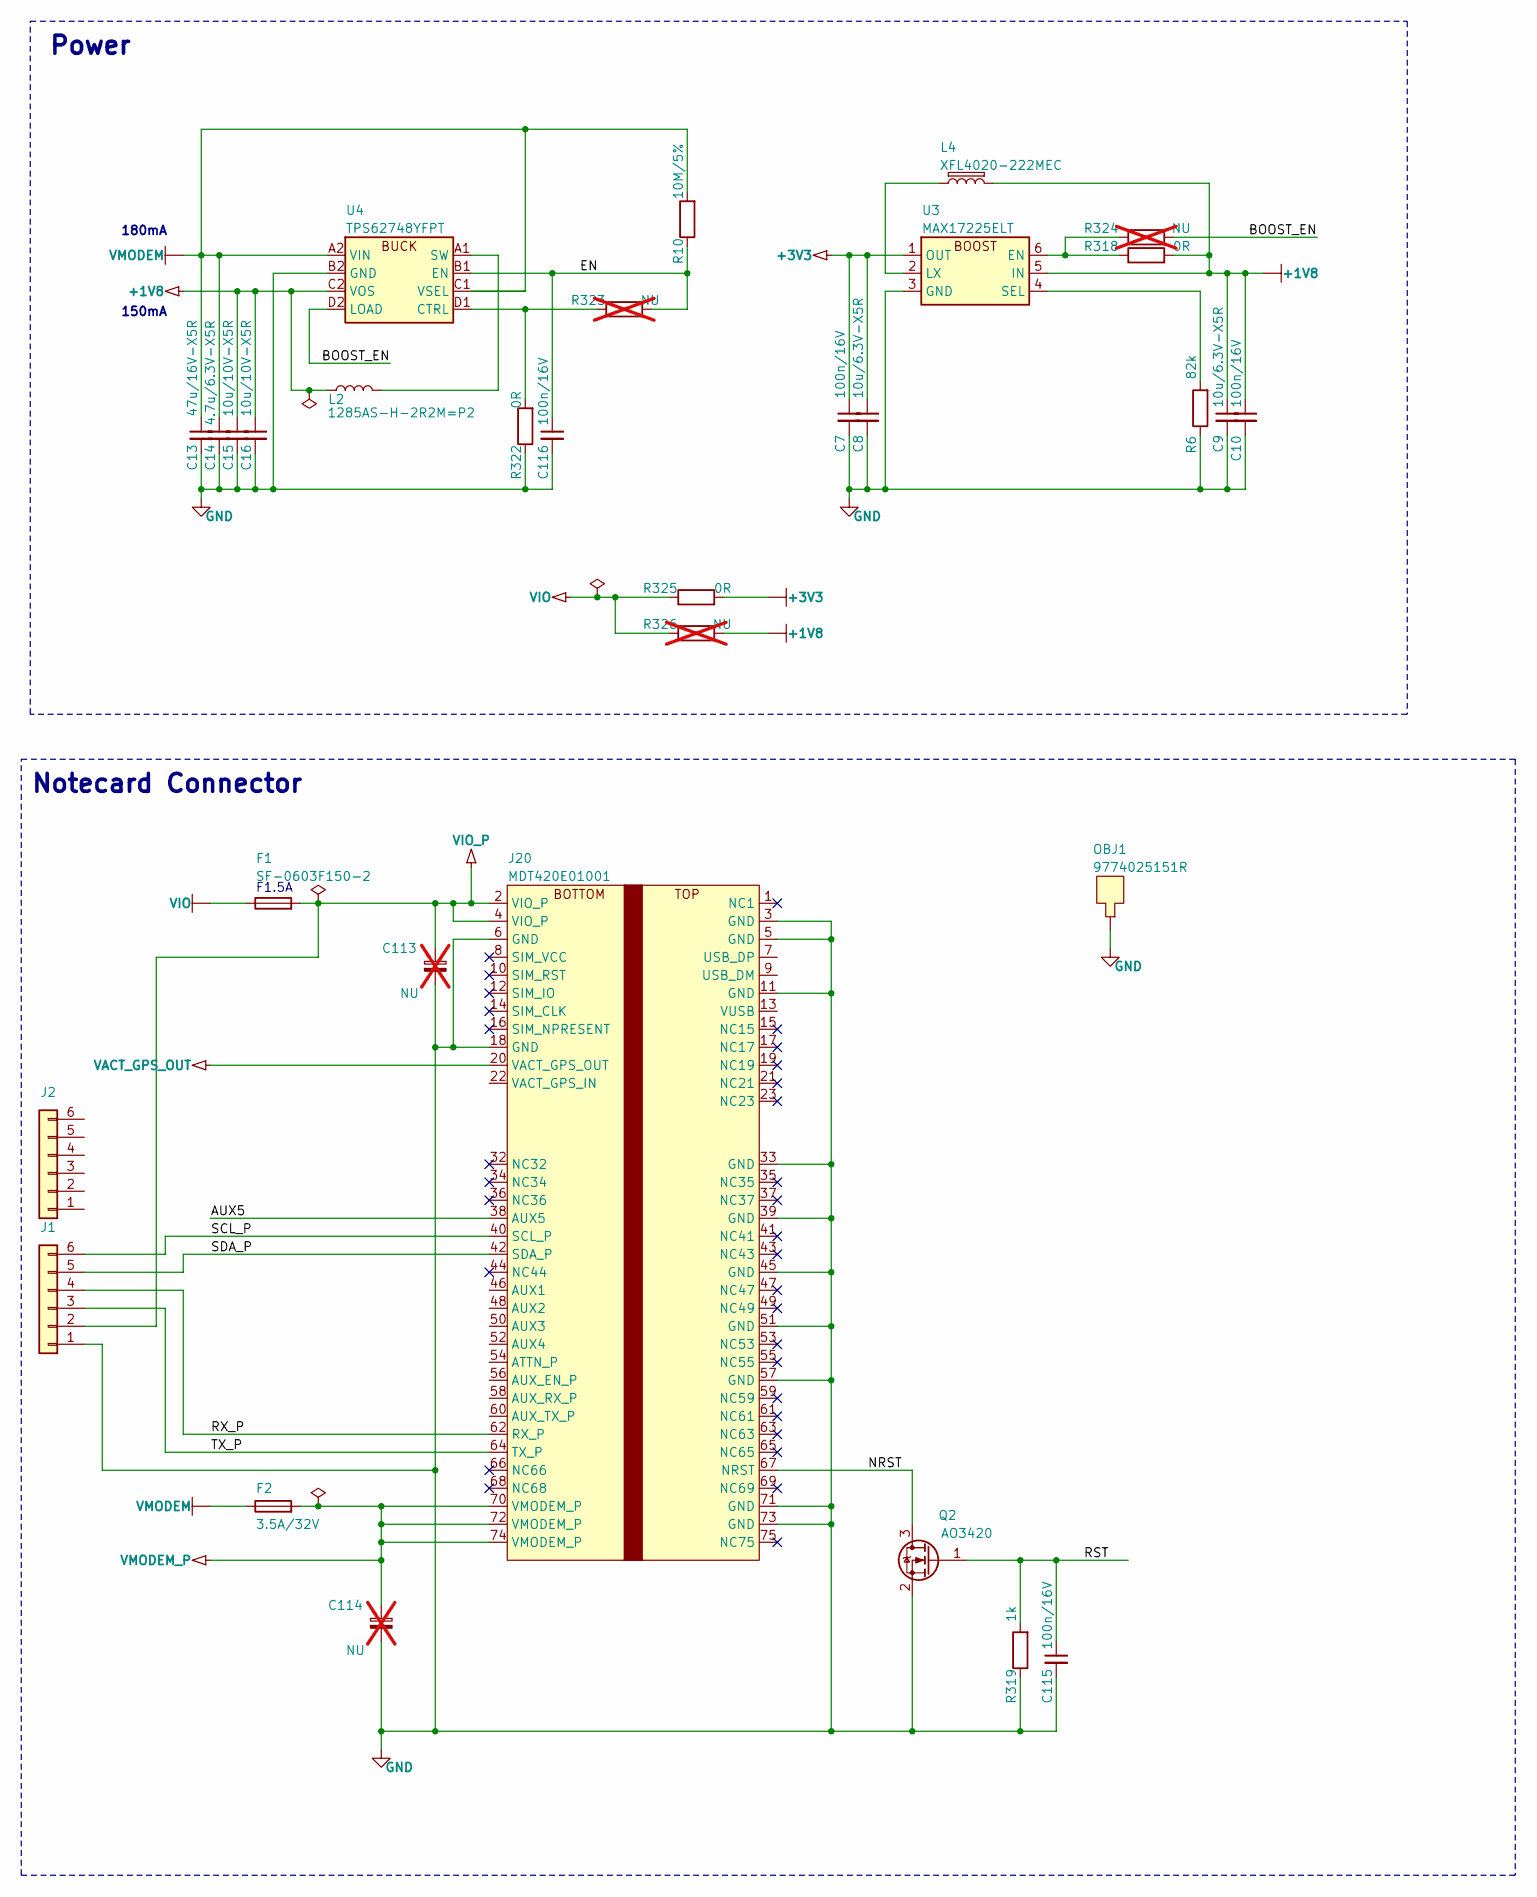
[picture p57: schematic Notecarrier-Micro.kicad_sch]

Parts:
C7, C10, C115, C116: 100n/16V; CS-C-0402_NO-FILL
C8, C9: 10u/6.3V-X5R; CS-C-0402_NO-FILL
C13: 47u/16V-X5R; CS-C-1206
C14: 4.7u/6.3V-X5R; CS-C-0402_NO-FILL
C15, C16: 10u/10V-X5R; CS-C-0603
C113: NU; CS-T-A; MPN F930J107KAA; not fitted
C114: NU; CS-T-B; MPN F930J227KBA; not fitted
F1: SF-0603F150-2; FS-0603; MPN SF-0603F150-2
F2: 3.5A/32V; FS-0603; MPN 0603SFV350F/32-2
J1, J2: Conn_01x06; PinHeader_1x06_P2.54mm_Vertical
J20: MDT420E01001; J-75-0050-MOS-M2-E
L2: 1285AS-H-2R2M=P2; LS-0806; MPN 1285AS-H-2R2M=P2
L4: XFL4020-222MEC; LS-XFL4020; MPN XFL4020-222MEC
OBJ1: 9774025151R; DIST-WASMSIM0250
Q2: AO3420; SOT23_NO-FILL
R6: 82k; RS-0402_NO-FILL
R10: 10M/5%; RS-0402_NO-FILL
R318, R322, R325: 0R; RS-0402_NO-FILL
R319: 1k; RS-0402_NO-FILL
R323, R324, R326: NU; RS-0402_NO-FILL; not fitted
U3: MAX17225ELT; WDFN6-0200X0200; MPN MAX17225ELT+T
U4: TPS62748YFPT; XFBGA8; MPN TPS62748YFPT

Connections:
+1V8: C9.1, C10.1, C15.1, C16.1, L2.2, L4.2, R318.2, R326.2, U3.5 (IN), U4.C2 (VOS)
+3V3: C7.1, C8.1, R325.2, U3.1 (OUT)
/AUX5: J20.38 (AUX5)
/BOOST_EN: R324.2, U4.D2 (LOAD)
/EN: C116.1, R10.1, R323.2, U4.B1 (EN)
/NRST: J20.67 (NRST), Q2.3 (D)
/RST: C115.1, Q2.1 (G), R319.2
/RX_P: J1.4, J20.62 (RX_P)
/SCL_P: J1.6, J20.40 (SCL_P)
/SDA_P: J1.5, J20.42 (SDA_P)
/TX_P: J1.3, J20.64 (TX_P)
GND: C7.2, C8.2, C9.2, C10.2, C13.2, C14.2, C15.2, C16.2, C113.2, C114.2, C115.2, C116.2, J1.1, J20.3 (GND), J20.5 (GND), J20.6 (GND), J20.11 (GND), J20.18 (GND), J20.33 (GND), J20.39 (GND), J20.45 (GND), J20.51 (GND), J20.57 (GND), J20.71 (GND), J20.73 (GND), OBJ1.1, Q2.2 (S), R6.1, R319.1, R322.1, U3.3 (GND), U4.B2 (GND)
unnamed: R318.1, R324.1, U3.6 (EN)
unnamed: L4.1, U3.2 (LX)
unnamed: R6.2, U3.4 (SEL)
unnamed: R322.2, R323.1, U4.D1 (CTRL)
unnamed: L2.1, U4.A1 (SW)
VACT_GPS_OUT: J20.20 (VACT_GPS_OUT)
VIO: F1.1, R325.1, R326.1
VIO_P: C113.1, F1.2, J1.2, J20.2 (VIO_P), J20.4 (VIO_P)
VMODEM: C13.1, C14.1, F2.1, R10.2, U4.A2 (VIN), U4.C1 (VSEL)
VMODEM_P: C114.1, F2.2, J20.70 (VMODEM_P), J20.72 (VMODEM_P), J20.74 (VMODEM_P)

Notes on the sheet:
150mA
180mA
F1.5A
Notecard Connector
Power

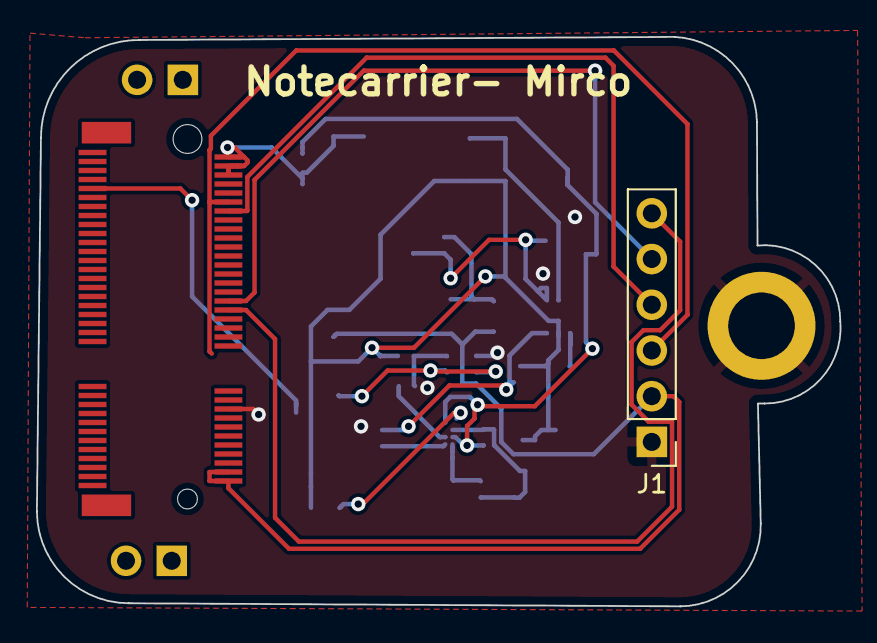
[picture p58: board Notecarrier-Micro.kicad_pcb from above]

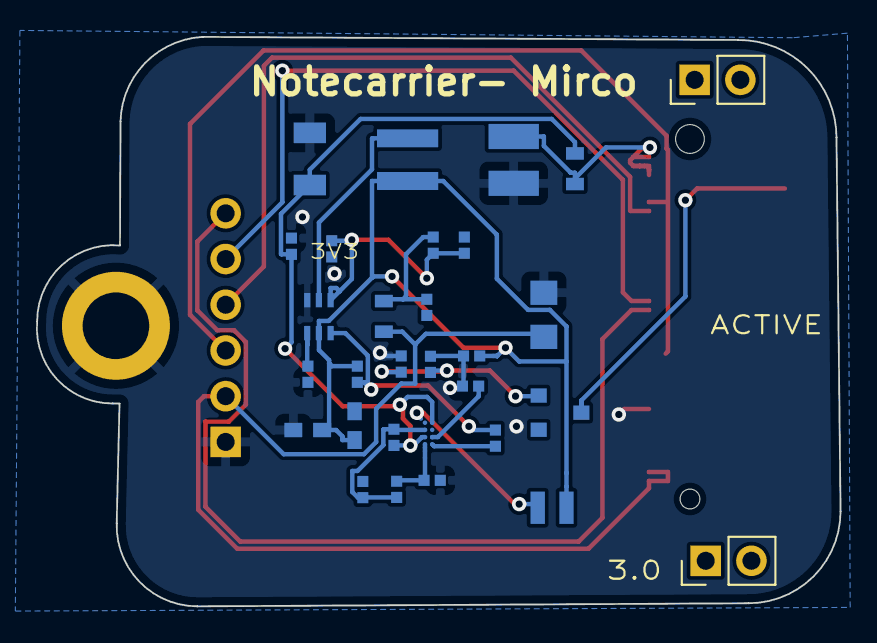
[picture p59: board Notecarrier-Micro.kicad_pcb from below]

Board: 2 copper layers, 44.6 x 31.6 mm, 33 parts (30 on the bottom side), 20 nets.

Other parts of the board:
Extra_pin_1, Extra_pin_2: PinHeader_1x02_P2.54mm_Vertical
