robouden/note-hardware/Notecarrier-A/v2.0/KiCad_format/Notecarrier-A.kicad_pcb

## KiCad design Notecarrier-A/v2.0/KiCad_format/Notecarrier-A.kicad_pcb (2024-03-18)

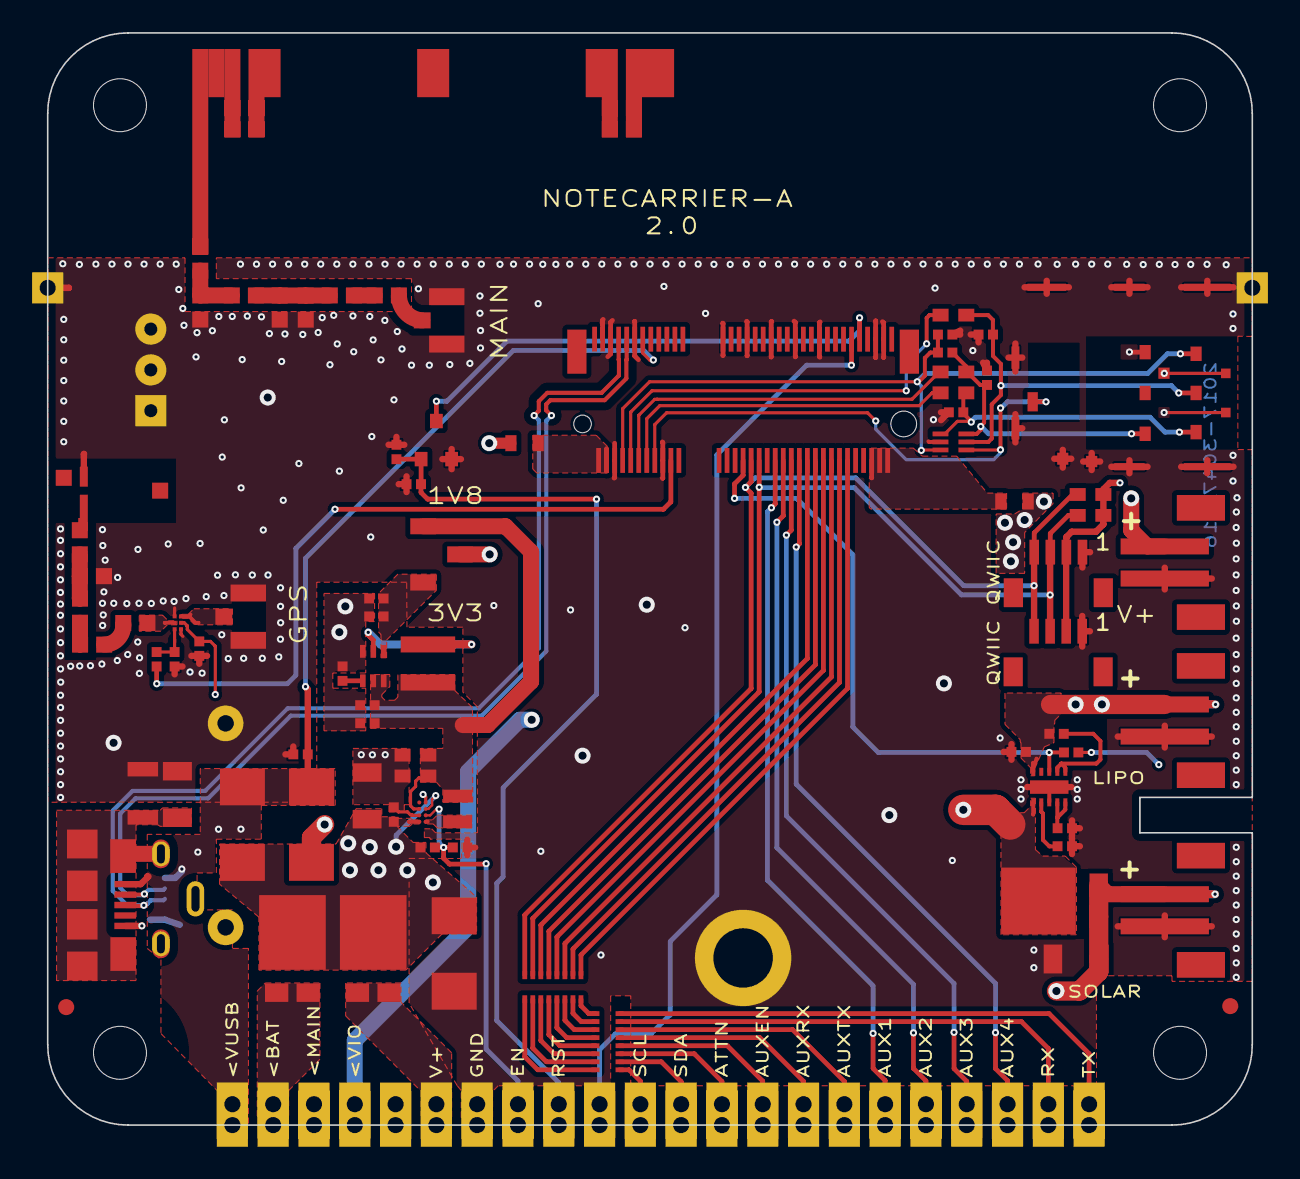
[picture p60: board Notecarrier-A.kicad_pcb from above]

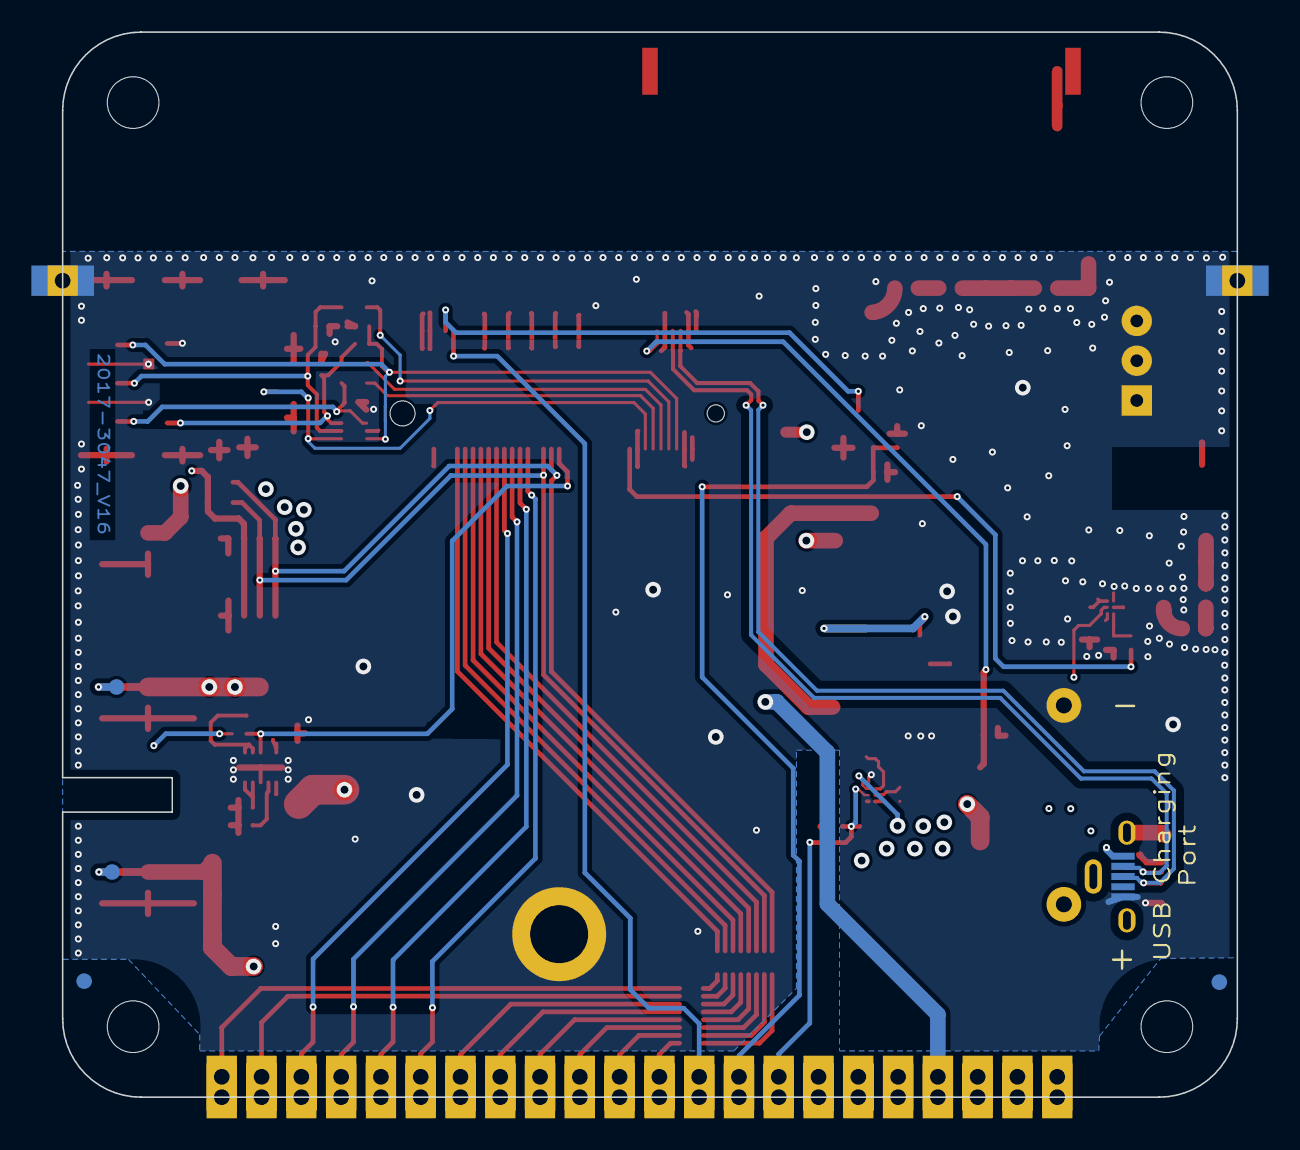
[picture p61: board Notecarrier-A.kicad_pcb from below]

Board: 4 copper layers, 75.0 x 68.0 mm, 99 parts (6 on the bottom side), 79 nets.

Parts:
ANT1: NN03-310; ANT-NN03310-LTE_NO-SILK
ANT2: NN03-320; ANT-NN03320-GPS_NO-SILK
BAT1: NU; BATHLD-2464-NO_MECH
C1: 47u/16V-X5R; CS-C-1206
C2: 4.7u/6.3V-X5R; CS-C-0402
C3, C4: 10u/10V-X5R; CS-C-0603
C5, C6, C9, C10, C16, C23: 100n/16V; CS-C-0402
C7, C8: 10u/6.3V-X5R; CS-C-0402
C11: 10n/1kV; CS-C-1206
C12: 10u/25V-X5R; CS-C-1206
C13, C22: 1u/16V-X5R; CS-C-0402
C17, C18, C19: 33p/50V-C0G; CS-C-0402
C21: 1n/50V; FRACTUS-0404_NO-SILK
C25: 0.5p/50V-C0G; FRACTUS-0404_NO-SILK
C26: 1p/50V-C0G; FRACTUS-0404_NO-SILK
C27: 2.2p/50V-C0G; FRACTUS-0404_NO-SILK
C28: 4.6p/50V-C0G; FRACTUS-0404_NO-SILK
C29: 1.1p/50V-C0G; FRACTUS-0404_NO-SILK
DS2, DS3, DS6: FSV1045V; TO277-3
DS4, DS5: STPS3H100U; SMB
F1: SF-0603F150-2; FS-0603
F2: 3.5A/32V; FS-0603
FID1, FID2, FID3, FID4: TPS; FIDUCIAL_MIN-CLEARANCE
H1, H2, H3, H4: MountingHole; FORO-0330-U
J2: NU; J-5-0065-FDS-UUSB1051330001_NO-SILK
J3, J4, J12: B2B-PH-SM4-TBT(LF)(SN); J-2-0200-MDS-B2B-PH-SM4
J5: NanoSIM - SF72S006VBAR2500; J-NANOSIM-SF72S006VBA_NO-FILL
J6: MDT420E01001; J-75-0050-MOS-M2-E_smaller-mask
J7, J8: uFL-R-SMT-1-10; J-3-MDS-UFL_NO-SILK
J9: 12734; J-22-0254-FDT-H0508_EDGE
J10: 00711; J-3-0254-FDT_H0508
J11: 10118192-0002LF; J-5-0065-FOS-USB10118192-NOF
J13, J14: BM04B-SRSS-TBT; J-4-0100-MDS-SH_NO-SILK
L1: XFL4020-222MEC; LS-XFL4020
L2: 1285AS-H-2R2M=P2; LS-0806
L5: LQW15AN7N5H00D; FRACTUS-0404_NO-SILK
L6: LQW18AN12NG80; FRACTUS-0404_NO-SILK
L7: LQW18AN10NG80D; FRACTUS-0404_NO-SILK
L8: LQW18AN8N4G80D; FRACTUS-0404_NO-SILK
L9: LQW15AN2N3G80D; FRACTUS-0404_NO-SILK
OBJ1: 9774025151R; DIST-WASMSIM0250
PAD1, PAD2: TPS; PAD-THT-CAS-0100
Q1: AO3420; SOT23
R1: 10M/5%; RS-0402
R4: 82k; RS-0402
R5: 1M; RS-1206
R6: NU; RS-0402
R8, R10: 10k; RS-0402
R9: 470R; RS-0402
R12, R14, R15: 22R; RS-0603
R16: 15k; RS-0402
R18: 200k; RS-0402
R21: 1k; RS-0402
R22: 100k; RS-0402
R25, R27, R28, R29: 0R; FRACTUS-0404_NO-SILK
R26: NU; FRACTUS-0404_NO-SILK
R30, R31: NU; RS-0603
RR1, RR2: 100R/5%; RR-8X-1506
SW1: CJS-1200TA; SW_CJS-1200TA_NO-SILK
TP4, TP5: TPS; TPS-SPEA
TVS1: SM6T6V8A; SMB
TVS2: ESDLC5V0M5-TP; SOT666_NO-SILK
U1: TPS62748YFPT; XFBGA8
U2: MAX17225ELT; WDFN6-0200X0200
U3: BQ24210DQCT; WSON10-EXP_NO-SILK
U5: BGA725L6E6327FTSA1; XFDFN6_NO-SILK

Connections:
+1V8: C3.1, C4.1, C8.1, C9.1, L1.2, L2.2, SW1.1 (C), U1.C2 (VOS), U2.5 (IN), U2.6 (EN)
+3V3: C6.1, C7.1, SW1.3 (A), U2.1 (OUT)
/Connector/ATTN_P: J6.54 (ATTN_P), RR2.14 (R3_2)
/Connector/AUX_EN_P: J6.56 (AUX_EN_P), RR2.13 (R4_2)
/Connector/AUX_RX_P: J6.58 (AUX_RX_P), RR2.12 (R5_2)
/Connector/AUX_TX_P: J6.60 (AUX_TX_P), RR2.11 (R6_2)
/Connector/GPS_50: J8.1 (In), U5.3 (AO)
/Connector/GPS_50_A: L5.1, U5.5 (AI)
/Connector/GPS_50_B: C21.1, L5.2
/Connector/GPS_50_C: C21.2, R29.1
/Connector/GPS_50_D: C28.1, C29.1, R29.2
/Connector/GPS_50_E: ANT2.4 (FEED-GPS), C29.2
/Connector/LTE_50: J7.1 (In), R28.1
/Connector/LTE_50_A: R27.1, R28.2
/Connector/LTE_50_B: C26.1, C27.2, L7.1, R27.2
/Connector/LTE_50_C: C27.1, L8.1, L9.1
/Connector/LTE_50_D: ANT1.1 (FEED_LTE), L9.2
/Connector/NRST: J6.67 (NRST), Q1.3 (D)
/Connector/RX_P: J6.62 (RX_P), RR2.10 (R7_2)
/Connector/SCL_P: J6.40 (SCL_P), J13.4, J14.4, R31.1, RR2.16 (R1_2)
/Connector/SDA_P: J6.42 (SDA_P), J13.3, J14.3, R30.1, RR2.15 (R2_2)
/Connector/SIM_CLK: J6.14 (SIM_CLK), R14.1
/Connector/SIM_IO: J6.12 (SIM_IO), R12.1
/Connector/SIM_NPRESENT: J5.DSW, J6.16 (SIM_NPRESENT), TVS2.4 (K3)
/Connector/SIM_RST: J6.10 (SIM_RST), R15.1
/Connector/SIM_VCC: C16.1, J5.C1 (VCC), J6.8 (SIM_VCC), R16.2, TVS2.3 (K2)
/Connector/TX_P: J6.64 (TX_P), RR2.9 (R8_2)
/Power/EN: C5.1, J9.8, R1.1, U1.B1 (EN)
ATTN: J9.13, RR1.3 (R3_1)
AUX1: J6.46 (AUX1), J9.17
AUX2: J6.48 (AUX2), J9.18
AUX3: J6.50 (AUX3), J9.19
AUX4: J6.52 (AUX4), J9.20
AUX5: J6.38 (NC38), R6.1, U3.8 (~CHG)
AUX_EN: J9.14, RR1.4 (R4_1)
AUX_RX: J9.15, RR1.5 (R5_1)
AUX_TX: J9.16, RR1.6 (R6_1)
BOOT: J6.65 (NC65), J9.10
GND: ANT2.2 (M2), BAT1.2 (-), C1.2, C2.2, C3.2, C4.2, C5.2, C6.2, C7.2, C8.2, C9.2, C10.2, C11.2, C12.2, C13.2, C16.2, C17.2, C18.2, C19.2, C22.2, C23.2, C26.2, C28.2, J2.5 (GND), J3.2, J4.2, J5.C5 (GND), J5.CSW, J5.SH, J6.3 (GND), J6.5 (GND), J6.6 (GND), J6.11 (GND), J6.18 (GND), J6.33 (GND), J6.39 (GND), J6.45 (GND), J6.51 (GND), J6.57 (GND), J6.71 (GND), J6.73 (GND), J7.2 (Ext), J8.2 (Ext), J9.7, J10.1, J10.2, J10.3, J11.5 (GND), J12.2, J13.1, J14.1, L7.2, L8.2, OBJ1.1, PAD1.1, PAD2.1, Q1.2 (S), R4.1, R5.2, R9.1, R10.1, R21.1, R22.1, TVS1.2 (A2), TVS2.2 (A), U1.B2 (GND), U1.D1 (CTRL), U2.3 (GND), U3.3 (VSS), U3.11 (EXP), U5.1 (GND), U5.4 (GNDRF)
unnamed: DS5.1 (K), DS6.3 (C), U3.1 (VBUS)
unnamed: C11.1, J2.6 (Shield), J11.6 (Shield), R5.1
unnamed: ANT1.2 (MN1-A), C25.2, L6.1
unnamed: ANT1.3 (MN1-B), C25.1, L6.2
unnamed: ANT1.5 (MN2-A), R25.1, R26.1
unnamed: ANT1.6 (MN2-B), R25.2, R26.2
unnamed: C18.1, J5.C3 (CLK), R14.2, TVS2.1 (K1)
unnamed: C19.1, J5.C7 (I/O), R12.2, R16.1, TVS2.6 (K5)
unnamed: C17.1, J5.C2 (RST), R15.2, TVS2.5 (K4)
unnamed: RR1.16 (R1_2), RR2.1 (R1_1)
unnamed: RR1.15 (R2_2), RR2.2 (R2_1)
unnamed: RR1.14 (R3_2), RR2.3 (R3_1)
unnamed: RR1.13 (R4_2), RR2.4 (R4_1)
unnamed: RR1.12 (R5_2), RR2.5 (R5_1)
unnamed: RR1.11 (R6_2), RR2.6 (R6_1)
unnamed: RR1.10 (R7_2), RR2.7 (R7_1)
unnamed: RR1.9 (R8_2), RR2.8 (R8_1)
unnamed: L2.1, U1.A1 (SW)
unnamed: L1.1, U2.2 (LX)
unnamed: R4.2, U2.4 (SEL)
unnamed: R9.2, U3.2 (ISET)
unnamed: R10.2, U3.4 (VTSB), U3.5 (TS)
unnamed: R8.1, U3.6 (~PG), U3.7 (~EN)
unnamed: R18.1, R22.2, U5.6 (PON)
RST: C23.1, J9.9, Q1.1 (G), R21.2
RX: J9.21, RR1.7 (R7_1)
SCL: J9.11, RR1.1 (R1_1)
SDA: J9.12, RR1.2 (R2_1)
TX: J9.22, RR1.8 (R8_1)
USB_DM: J2.2 (D-), J6.9 (USB_DM), J11.2 (D-)
USB_DP: J2.3 (D+), J6.7 (USB_DP), J11.3 (D+)
V+: DS2.1 (A1), DS2.2 (A2), J9.6, J12.1
VACT_GPS_OUT: J6.20 (VACT_GPS_OUT), R18.2
VBAT: BAT1.1 (+), C13.1, DS3.1 (A1), DS3.2 (A2), J4.1, J9.2, R8.2, TP4.1, U3.10 (BAT)
VIO: C22.1, F1.1, J9.4, J13.2, J14.2, R6.2, R30.2, R31.2, SW1.2 (B), U5.2 (VCC)
VIO_P: F1.2, J6.2 (VIO_P), J6.4 (VIO_P)
VMAIN: C1.1, C2.1, DS2.3 (C), DS3.3 (C), DS4.1 (K), F2.1, J9.3, R1.2, TVS1.1 (A1), U1.A2 (VIN), U1.C1 (VSEL)
VMODEM_P: F2.2, J6.70 (VMODEM_P), J6.72 (VMODEM_P), J6.74 (VMODEM_P)
VSOLAR: C12.1, DS6.1 (A1), DS6.2 (A2), J3.1, J9.5, TP5.1
VUSB: C10.1, DS4.2 (A), DS5.2 (A), J2.1 (VBUS), J6.13 (VUSB), J9.1, J11.1 (VBUS)
