robouden/note-hardware/(commit log)

2024-05-01 Updated boards
2024-05-01 added Notecarrier-micro
    [Coilcraft-XFL4020.STEP, Coilcraft-XFL4020.stl, Notecarrier- Mirco.FCStd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]
