robouden/note-hardware/(notices)

Notices in the files:
Notecarrier-A/v2.0/KiCad_format/Notecarrier-A.kicad_pcb:
Blues Inc (Copyright (c) 2023 Blues Inc)
